tekcanyilmaz42-gif/bldc_driver/yardımcı_dokuman/montaj_yan.png

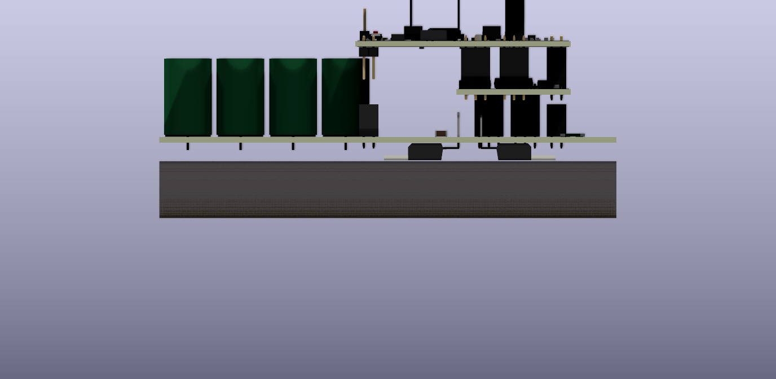
yardımcı_dokuman/montaj_yan.png
