tekcanyilmaz42-gif/bldc_driver/yardımcı_dokuman/montaj_3d.png

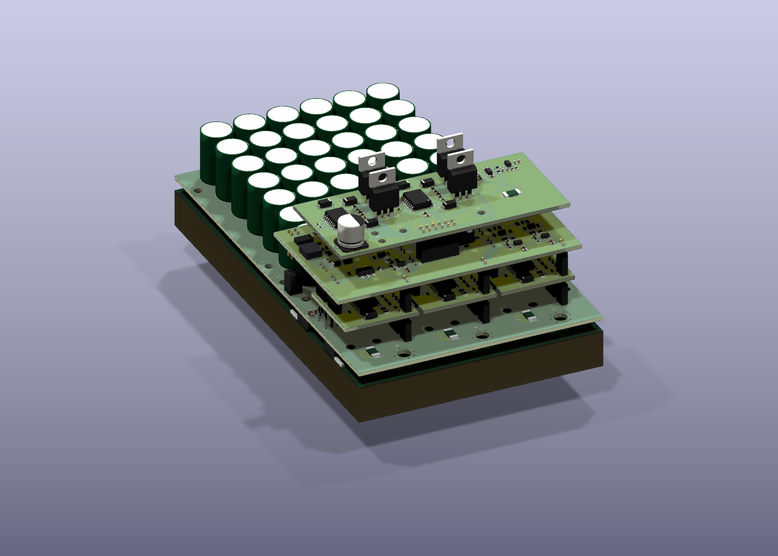
yardımcı_dokuman/montaj_3d.png
