tekcanyilmaz42-gif/bldc_driver/yardımcı_dokuman/guc_karti_alt_TO220.png

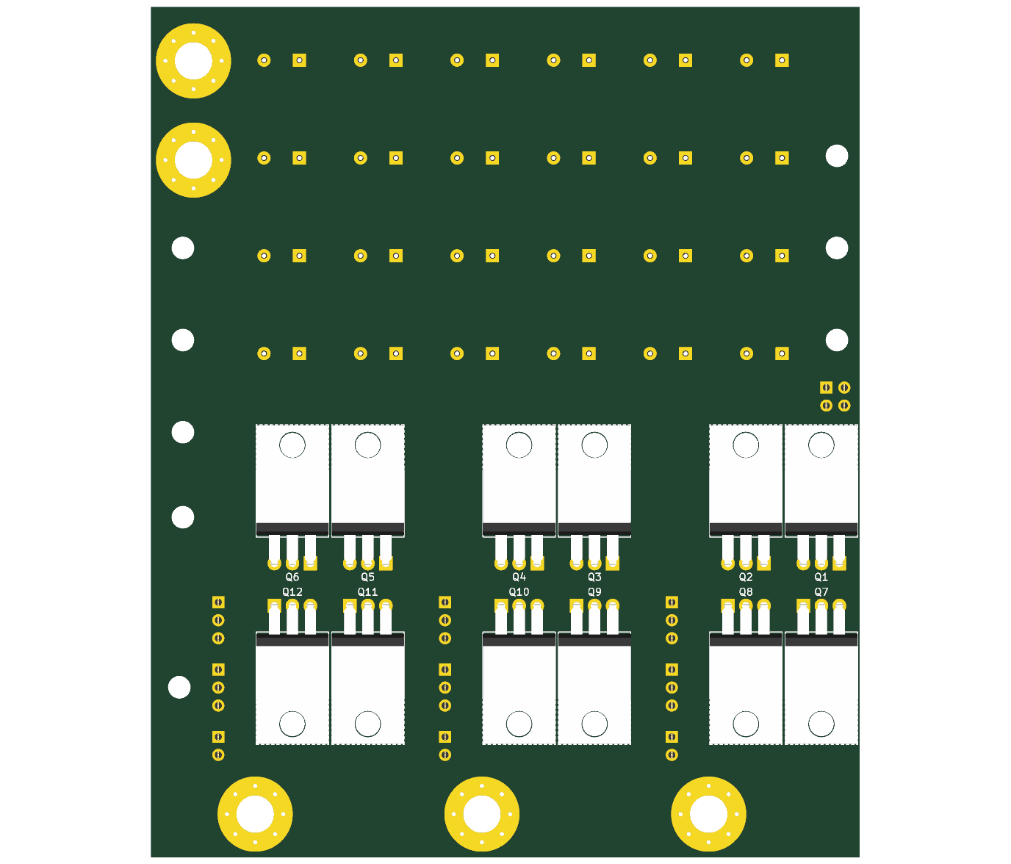
yardımcı_dokuman/guc_karti_alt_TO220.png
