tekcanyilmaz42-gif/bldc_driver/yardımcı_dokuman/master_bottom.png

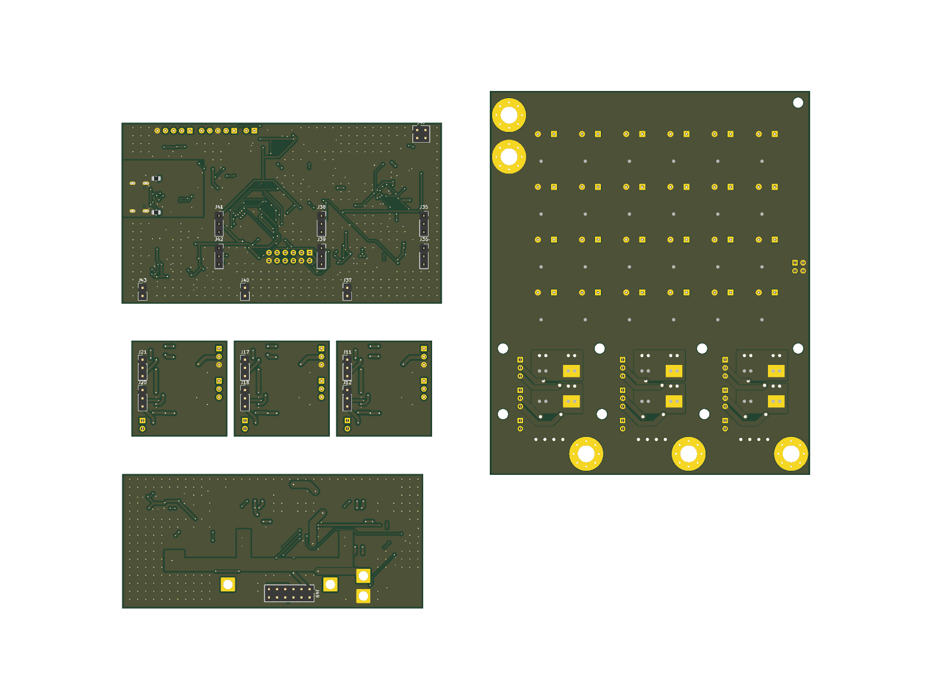
yardımcı_dokuman/master_bottom.png
