tekcanyilmaz42-gif/bldc_driver/yardımcı_dokuman/master_top.png

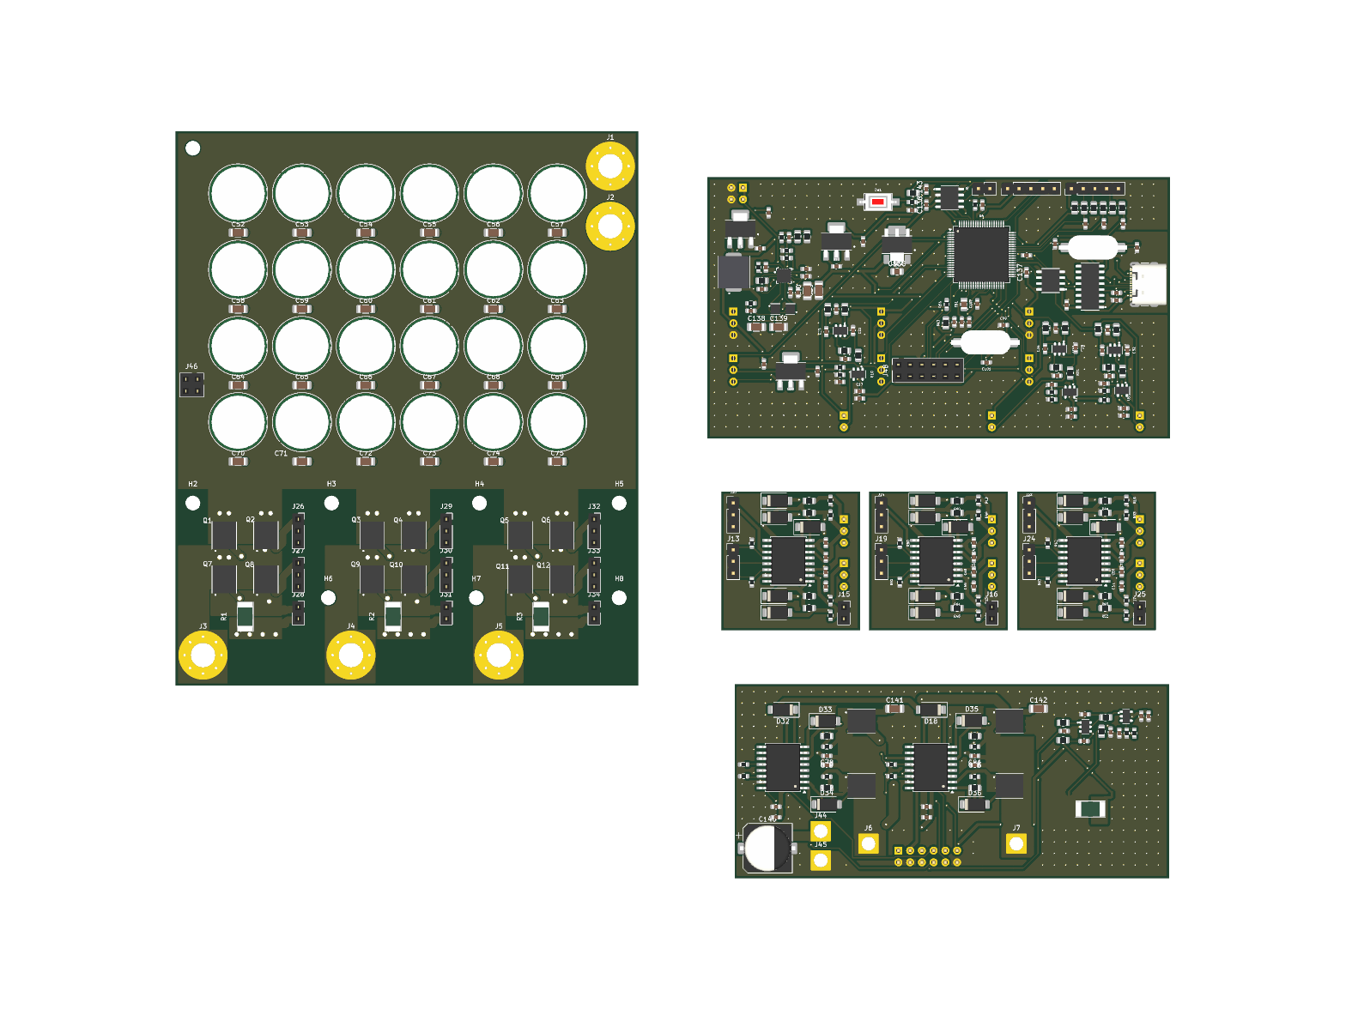
yardımcı_dokuman/master_top.png
