tekcanyilmaz42-gif/bldc_driver/yardımcı_dokuman/pmsm_bom.pdf

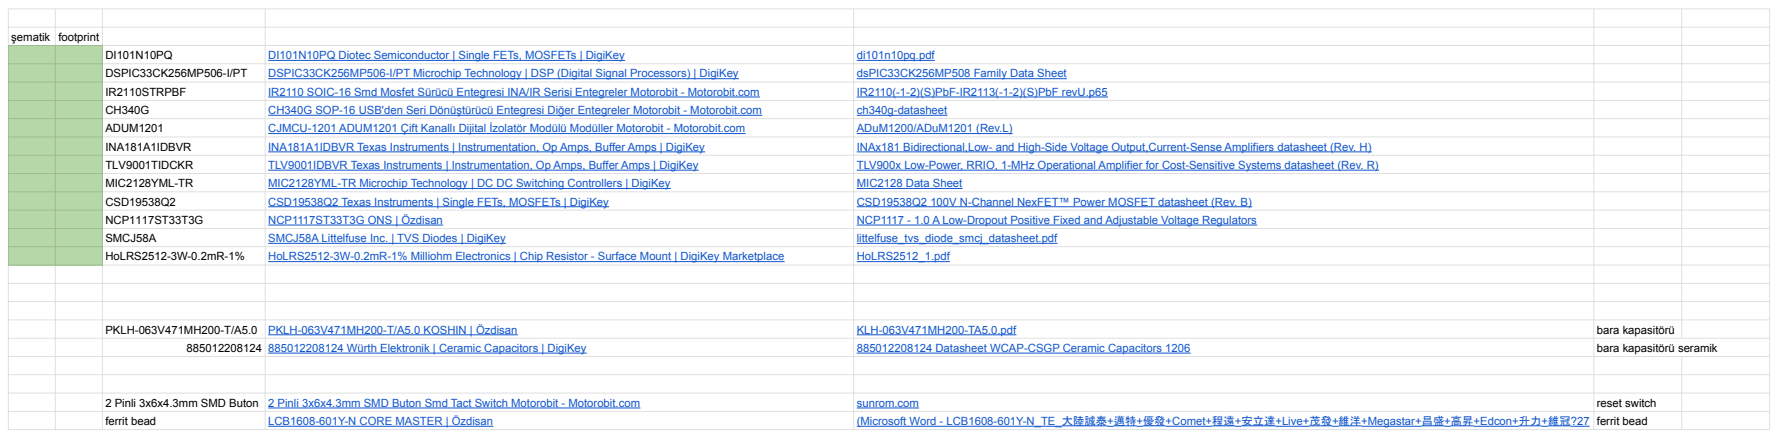
[picture p6: page 1]
şematik footprint; DI101N10PQ Diotec Semiconductor | Single FETs, MOSFETs | DigiKey; di101n10pq.pdf; DSPIC33CK256MP506-I/PT; DSPIC33CK256MP506-I/PT Microchip Technology | DSP (Digital Signal Processors) | DigiKey; dsPIC33CK256MP508 Family Data Sheet; IR2110STRPBF; IR2110 SOIC-16 Smd Mosfet Sürücü Entegresi INA/IR Serisi Entegreler Motorobit - Motorobit.com; IR2110(-1-2)(S)PbF-IR2113(-1-2)(S)PbF revU.p65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

şematik | footprint
| | SS18-T/R | VCC-VB diyot | SS18-T/R (https://www.ozdisan.com/p/schottky-diyotlar-385/galaxy-ss18-t-r-349246) | SK12-SK110.xls (https://cdn.ozdisan.com/public/product/assets/SS12-SS110-GALAXY.pdf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) | önceki ES1A-ES1J_HT.pdf (https://cdn.ozdisan.com/public/product/assets/ES1A-ES1J_HT.pdf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)
| | SS18-T/R | gate diyot | SS18-T/R (https://www.ozdisan.com/p/schottky-diyotlar-385/galaxy-ss18-t-r-349246) | SK12-SK110.xls (https://cdn.ozdisan.com/public/product/assets/SS12-SS110-GALAXY.pdf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) | Önceki https://diotec.com/request/datasheet/m1.pdf
| | CL10B104KB8NNNC | 100nF | CL10B104KB8NNNC SAMSUNG | Özdisan (https://www.ozdisan.com/p/smt-smd-ve-mlcc-kapasitorler-184/samsung-cl10b104kb8nnnc-9739?catSequenceId=184) | SAMSUNG MLCC_JAN-2024.pdf (https://cdn.ozdisan.com/public/product/assets/SAMSUNG%20MLCC_JAN-2024.pdf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)
| | CL21A106KAYNNNE | 10uF | CL21A106KAYNNNE SAMSUNG | Özdisan (https://www.ozdisan.com/p/smt-smd-ve-mlcc-kapasitorler-184/samsung-cl21a106kaynnne-453566?catSequenceId=184) | SAMSUNG MLCC_JAN-2024.pdf (https://cdn.ozdisan.com/public/product/assets/SAMSUNG%20MLCC_JAN-2024.pdf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)
| | 0805S8J0100T5E | 10 ohm | 0805S8J0100T5E ROYALOHM | Özdisan (https://www.ozdisan.com/p/smt-smd-ve-cip-direncler-194/royalohm-0805s8j0100t5e-29704?catSequenceId=194) | general_royalohm.pdf (https://cdn.ozdisan.com/public/product/assets/general_royalohm.pdf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)
| | RC0603JR-0710KL | 10k ohm | RC0603JR-0710KL YAGEO | Özdisan (https://www.ozdisan.com/p/smt-smd-ve-cip-direncler-194/yageo-rc0603jr-0710kl-383150?catSequenceId=194) | PYu-RC_Group_51_RoHS_L_10.pdf (https://cdn.ozdisan.com/public/product/assets/PYu-RC_Group_51_RoHS_L_10.pdf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)
| | 0805S8J0101T5E | 100 ohm | 0805S8J0101T5E ROYALOHM | Özdisan (https://www.ozdisan.com/p/smt-smd-ve-cip-direncler-194/royalohm-0805s8j0101t5e-36382?catSequenceId=194)

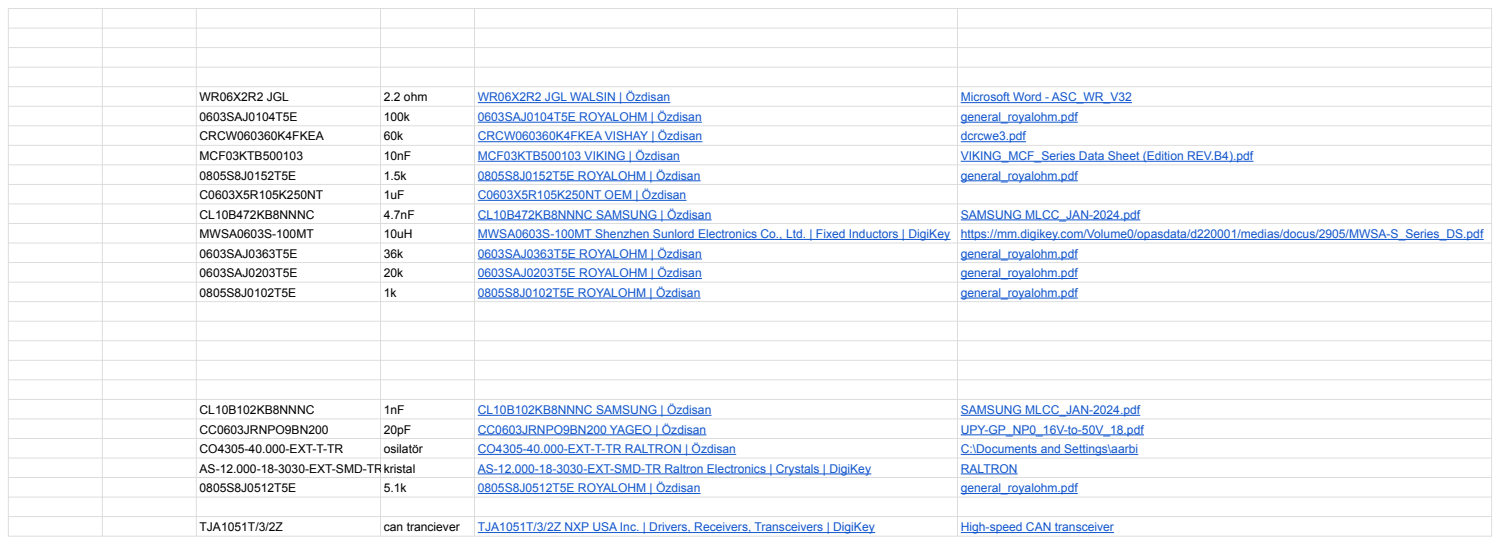
[picture p7: page 3]
WR06X2R2 JGL; 2.2 ohm; WR06X2R2 JGL WALSIN | Özdisan; Microsoft Word - ASC_WR_V32; 0603SAJ0104T5E; 0603SAJ0104T5E ROYALOHM | Özdisan; general_royalohm.pdf; CRCW060360K4FKEA; CRCW060360K4FKEA VISHAY | Özdisan; dcrcwe3.pdf; MCF03KTB500103; MCF03KTB500103 VIKING | Özdisan; VIKING_MCF_Series Data Sheet (Edition REV.B4).pdf; 0805S8J0152T5E ROYALOHM | Özdisan; C0603X5R105K250NT OEM | Özdisan; CL10B472KB8NNNC; CL10B472KB8NNNC SAMSUNG | Özdisan; SAMSUNG MLCC_JAN-2024.pdf; MWSA0603S-100MT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
