tekcanyilmaz42-gif/bldc_driver/bldc_driver_ai_BOM.xlsx

Sheet: BOM
bldc_driver_ai – Malzeme Listesi (BOM)
Rev 2.5 (2 katman). Kaynak: bldc_driver_ai.kicad_pcb, referans format: yardımcı_dokuman/pmsm_bom.pdf
Üretilecek set sayısı: |  |  | 1 |  | Sarı hücreler (set sayısı, birim fiyat) kullanıcı girişidir. Yeşil = referans BOM'daki parça; turuncu = referanstan farklı / yeni parça (bkz. Not).
şematik | footprint | No | Kart / Modül | Referanslar | Adet / set | Değer | Kılıf (footprint) | Üretici parça no (MPN) | Üretici | Açıklama | Tedarikçi | Ürün arama | Datasheet | Toplam adet | Birim fiyat (TL) | Toplam fiyat (TL) | Not
 |  |  | 1 - Güç kartı
 |  | 1 | Güç kartı | Q1, Q2, Q3, Q4, Q5, Q6, Q7, Q8, Q9, Q10, Q11, Q12 | 12 | IRFB4110PBF | TO-220-3_Horizontal_TabUp_NoHole | IRFB4110PBF | Infineon | N-kanal MOSFET 100 V, 4.5 mΩ, TO-220AB | DigiKey / Özdisan | DigiKey'de ara (https://www.digikey.com/en/products/result?keywords=IRFB4110PBF) | irfb4110pbf.pdf |  |  |  | DI101N10PQ yerine (Rev 3.0). Güç kartında kartın altında yatık, tab soğutucuya (yalıtkan ped + burç + M3 vida, Mekanik sayfası); EESM'de dik, soğutucusuz. Sahte ürün riski: yetkili distribütörden alın
 |  | 2 | Güç kartı | D38, D39 | 2 | 5.0SMDJ58CA | D_SMC | 5.0SMDJ58CA | Littelfuse | TVS diyot 58 V çift yönlü 5000 W, SMC | DigiKey | DigiKey'de ara (https://www.digikey.com/en/products/result?keywords=5.0SMDJ58CA) | 5.0SMDJ series datasheet |  |  |  | Referanstaki SMCJ58A yerine daha yüksek enerjili TVS (bara koruması, Faz 3)
 |  | 3 | Güç kartı | C52, C53, C54, C55, C56, C57, C58, C59, C60, C61, C62, C63, C64, C65, C66, C67, C68, C69, C70, C71, C72, C73, C74, C75 | 24 | 4.7uF/100V | C_1210 | HMK325C7475KN-TE | Taiyo Yuden | MLCC 4.7 µF 100 V X7S 1210 (bara seramik) | DigiKey | DigiKey'de ara (https://www.digikey.com/en/products/result?keywords=HMK325C7475KN-TE) | GRM32E datasheet |  |  |  | Faz başına yüksek frekans bara dekuplajı (Faz 3)
 |  | 4 | Güç kartı | C167, C168, C169, C170, C171, C172 | 6 | 4.7nF/100V C0G | C_1206 | GRM3195C2A472JA01D | Murata | MLCC 4.7 nF 100 V C0G 1206 (snubber) | DigiKey | DigiKey'de ara (https://www.digikey.com/en/products/result?keywords=GRM3195C2A472JA01D) | GRM319 datasheet |  |  |  | RC snubber (Faz 3)
 |  | 5 | Güç kartı | C200, C201, C202, C203, C204, C205, C206, C207, C208, C209, C210, C211, C212, C213, C214, C215, C216, C217, C218, C219, C220, C221, C222, C223 | 24 | 1000uF/100V | CP_Radial_D18.0mm_L40mm_P7.50mm_KOSHIN_KLH | PKLH-100V102MK400 | KOSHIN | Alüminyum elektrolitik 1000 µF ±%20 100 V, KLH serisi, Ø18 x 40 mm radyal, P 7.5 mm, Z ≤ 0.076 Ω (100 kHz), IRMS 2.5 A (100 kHz, 105 °C), 5000 h @ 105 °C | Özdisan | DigiKey'de ara (https://www.digikey.com/en/products/result?keywords=PKLH-100V102MK400) | KLH-100V102MK400.pdf (KOSHIN DJJ-2875) |  |  |  | Kullanıcı seçimi: TDK B32776G4506 film yerine. Güç kartının sağ bölümünde, petek (şaşırtmalı) dizilim; 24 adet = 24 mF, 60 A rms (105 °C değeri; gereken ≈ 50–60 A rms)
 |  | 6 | Güç kartı | R1, R2, R3 | 3 | 0.2mR 4-terminal | R_Shunt_Isabellenhuette_BVR4026 | BVR-Z-R0002-1.0 | Isabellenhütte | 4 uçlu (Kelvin) şönt 0.2 mΩ %1, 4026 | DigiKey / Mouser | DigiKey'de ara (https://www.digikey.com/en/products/result?keywords=BVR-Z-R0002-1.0) | BVR datasheet |  |  |  | Faz 3: HoLRS2512 yerine 4 uçlu şönt; 100 A rms'de I²R ≈ 2 W. MPN son ekini distribütörde doğrulayın
 |  | 7 | Güç kartı | R118, R119, R120, R121, R122, R123, R124, R125, R126, R127, R128, R129 | 12 | 10k | R_0805 | RC0603JR-0710KL | YAGEO | Direnç 10 kΩ %5 0603 | Özdisan | DigiKey'de ara (https://www.digikey.com/en/products/result?keywords=RC0603JR-0710KL) | PYu-RC_Group_51_RoHS_L_10.pdf
 |  | 8 | Güç kartı | R130, R132, R134 | 3 | 2.2 | R_2010 | CRCW20102R20FKEF | Vishay | Direnç 2.2 Ω %1 0.75 W 2010 (yüksek taraf RC snubber) | DigiKey | DigiKey'de ara (https://www.digikey.com/en/products/result?keywords=CRCW20102R20FKEF) | dcrcwe3.pdf |  |  |  | HS snubber, alt yüzde band içinde; kayıp ≈ 0.27 W
 |  | 9 | Güç kartı | R131, R133, R135 | 3 | 2.2 | R_1210 | CRCW12102R20FKEA | Vishay | Direnç 2.2 Ω %1 0.5 W 1210 (alçak taraf RC snubber) | DigiKey | DigiKey'de ara (https://www.digikey.com/en/products/result?keywords=CRCW12102R20FKEA) | dcrcwe3.pdf |  |  |  | LS snubber; band üstüne sığması için 2010 yerine 1210 (kayıp ≈ 0.27 W)
 |  | 10 | Güç kartı | R136, R137, R138 | 3 | 10k 1W | R_2512 | CRCW251210K0FKEG | Vishay | Direnç 10 kΩ %1 1 W 2512 (bara deşarj) | DigiKey | DigiKey'de ara (https://www.digikey.com/en/products/result?keywords=CRCW251210K0FKEG) | dcrcwe3.pdf |  |  |  | Bara kapasitörü deşarj (bleeder), Faz 3
 |  | 11 | Güç kartı | J28, J31, J34 | 3 | - | PinSocket_1x02 | - | genel | 2.54 mm dişi soket 1x2, 8.5 mm gövde | genel (Motorobit / Özdisan) |  | - |  |  |  | Kartlar arası konnektör
 |  | 12 | Güç kartı | J26, J27, J29, J30, J32, J33 | 6 | - | PinSocket_1x03 | - | genel | 2.54 mm dişi soket 1x3, 8.5 mm gövde | genel (Motorobit / Özdisan) |  | - |  |  |  | Kartlar arası konnektör
 |  | 13 | Güç kartı | J46 | 1 | - | PinSocket_2x02 | - | genel | 2.54 mm dişi soket 2x2, 8.5 mm gövde – riser | genel (Motorobit / Özdisan) |  | - |  |  |  | Kartlar arası konnektör
 |  |  | 2 - Gate driver (U/V/W)
 |  | 14 | Gate driver (U/V/W) | U1, U2, U3 | 3 | IR2110S | SOIC-16W_7.5x10.3mm_P1.27mm | IR2110STRPBF | Infineon | Yüksek/alçak taraf gate sürücü, SOIC-16W | Motorobit | DigiKey'de ara (https://www.digikey.com/en/products/result?keywords=IR2110STRPBF) | IR2110(-1-2)(S)PbF
 |  | 15 | Gate driver (U/V/W) | D10, D11, D12, D23, D24, D25, D26, D27, D28, D29, D30, D31 | 12 | SS18 | D_SMA | SS18 | onsemi | Schottky diyot 1 A 80 V, SMA | Özdisan | DigiKey'de ara (https://www.digikey.com/en/products/result?keywords=SS18) | SK12-SK110 |  |  |  | VCC-VB (bootstrap) ve gate deşarj diyotu olarak kullanılıyor
 |  | 16 | Gate driver (U/V/W) | D1, D2, D13 | 3 | US1D | D_SMA | US1D-E3/61T | Vishay | Ultra hızlı diyot 1 A 200 V, SMA | DigiKey | DigiKey'de ara (https://www.digikey.com/en/products/result?keywords=US1D-E3%2F61T) | US1A-US1M datasheet |  |  |  | Bootstrap diyodu (SS18 yerine, Faz 2)
 |  | 17 | Gate driver (U/V/W) | C1, C5, C6, C148, C149, C152, C153, C156, C157 | 9 | 100nF | C_0603 | CL10B104KB8NNNC | Samsung | MLCC 100 nF 50 V X7R 0603 | Özdisan | DigiKey'de ara (https://www.digikey.com/en/products/result?keywords=CL10B104KB8NNNC) | SAMSUNG MLCC_JAN-2024.pdf
 |  | 18 | Gate driver (U/V/W) | C3, C4, C7 | 3 | 2.2uF/25V | C_1206 | CL31B225KAHNNNE | Samsung | MLCC 2.2 µF 25 V X7R 1206 | Özdisan | DigiKey'de ara (https://www.digikey.com/en/products/result?keywords=CL31B225KAHNNNE) | SAMSUNG MLCC_JAN-2024.pdf |  |  |  | Revizyonla eklendi
 |  | 19 | Gate driver (U/V/W) | C41, C47, C48, C49, C50, C51, C150, C154, C158 | 9 | 1uF | C_0603 | C0603X5R105K250NT | OEM | MLCC 1 µF 25 V X5R 0603 | Özdisan | DigiKey'de ara (https://www.digikey.com/en/products/result?keywords=C0603X5R105K250NT) | -
 |  | 20 | Gate driver (U/V/W) | C147, C151, C155 | 3 | 22uF/25V | C_1206 | CL31A226KAHNNNE | Samsung | MLCC 22 µF 25 V X5R 1206 | Özdisan | DigiKey'de ara (https://www.digikey.com/en/products/result?keywords=CL31A226KAHNNNE) | SAMSUNG MLCC_JAN-2024.pdf |  |  |  | Gate sürücü VCC dekuplajı
 |  | 21 | Gate driver (U/V/W) | R6, R7, R10, R11, R14, R15, R43, R45, R47, R48, R51, R52 | 12 | 10 | R_0805 | 0805S8J0100T5E | ROYALOHM | Direnç 10 Ω %5 0805 (gate direnci) | Özdisan | DigiKey'de ara (https://www.digikey.com/en/products/result?keywords=0805S8J0100T5E) | general_royalohm.pdf
 |  | 22 | Gate driver (U/V/W) | R8, R9, R12, R13, R16, R17, R44, R46, R49, R50, R53, R54, R58, R59, R60, R61, R62, R63 | 18 | 10k | R_0603 | RC0603JR-0710KL | YAGEO | Direnç 10 kΩ %5 0603 | Özdisan | DigiKey'de ara (https://www.digikey.com/en/products/result?keywords=RC0603JR-0710KL) | PYu-RC_Group_51_RoHS_L_10.pdf
 |  | 23 | Gate driver (U/V/W) | R102, R103, R104, R105, R106, R107, R108, R109, R110, R111, R112, R113 | 12 | 2.2 | R_0603 | WR06X2R2 JGL | WALSIN | Direnç 2.2 Ω %5 0603 | Özdisan | DigiKey'de ara (https://www.digikey.com/en/products/result?keywords=WR06X2R2+JGL) | ASC_WR_V32
 |  | 24 | Gate driver (U/V/W) | J10, J11, J12, J13, J14, J17, J18, J19, J20, J21, J22, J24 | 12 | - | PinHeader_1x03 | - | genel | 2.54 mm erkek pin başlık 1x3, düz | genel (Motorobit / Özdisan) |  | - |  |  |  | Kartlar arası konnektör
 |  | 25 | Gate driver (U/V/W) | J15, J16, J25 | 3 | - | PinSocket_1x02 | ESQ-102-xx-T-S sınıfı (uzun kuyruklu) | Samtec / genel | 2.54 mm 1x2 STACKING dişi soket: üstte 8.5 mm soket, altta ≥ 10.5 mm uzun kuyruk (Arduino stacking header tipi) | Samtec / LCSC | DigiKey'de ara (https://www.digikey.com/en/products/result?keywords=ESQ-102-xx-T-S+sınıfı+(uzun+kuyruklu)) | - |  |  |  | Faz 7 (inceleme K21): şönt ölçüm hattı güç kartı J28/J31/J34 soketlerine bu kuyruklarla girer (kart arası 11 mm, giriş ≈ 6 mm). Standart soket TAKILMAZ: INA181 girişleri boşta kalır
 |  |  | 3 - Kontrol kartı
 |  | 26 | Kontrol kartı | Q13, Q14 | 2 | IRLML0100TRPBF | SOT-23 | IRLML0100TRPBF | Infineon | N-kanal MOSFET 100 V 1.6 A, SOT-23 | DigiKey | DigiKey'de ara (https://www.digikey.com/en/products/result?keywords=IRLML0100TRPBF) | IRLML0100 datasheet |  |  |  | Faz 2
 |  | 27 | Kontrol kartı | Q19, Q20 | 2 | AO3400A | SOT-23 | AO3400A | Alpha & Omega | N-kanal MOSFET 30 V 5.7 A, SOT-23 | DigiKey | DigiKey'de ara (https://www.digikey.com/en/products/result?keywords=AO3400A) | AO3400A datasheet |  |  |  | Kontaktör / ön şarj sürücüsü
 |  | 28 | Kontrol kartı | U4 | 1 | ADuM1201 | ADuM1201_LP | ADUM1201ARZ | Analog Devices | Çift kanallı dijital izolatör, SOIC-8 | DigiKey | DigiKey'de ara (https://www.digikey.com/en/products/result?keywords=ADUM1201ARZ) | ADuM1200/ADuM1201 (Rev.L) |  |  |  | Referans BOM'da CJMCU-1201 modülü var; kart üstü SOIC-8 entegre gerekir
 |  | 29 | Kontrol kartı | U5 | 1 | CH340G | CH340G_LP | CH340G | WCH | USB-UART dönüştürücü, SOP-16 | Motorobit | DigiKey'de ara (https://www.digikey.com/en/products/result?keywords=CH340G) | ch340g-datasheet
 |  | 30 | Kontrol kartı | U6 | 1 | dsPIC33CK256MP508 | LQFP-80_12x12mm_P0.5mm | DSPIC33CK256MP508-I/PT | Microchip Technology | dsPIC33CK DSC, 256 KB, TQFP-80 12x12 | DigiKey | DigiKey'de ara (https://www.digikey.com/en/products/result?keywords=DSPIC33CK256MP508-I%2FPT) | dsPIC33CK256MP508 Family Data Sheet |  |  |  | Referans BOM'da MP506 (64 pin) yazıyor; tasarım 80 pinli MP508 kullanıyor
 |  | 31 | Kontrol kartı | U8, U19, U20 | 3 | LDL1117S33R | NCP1117 | LDL1117S33R | STMicroelectronics | LDO 3.3 V 1.2 A, SOT-223, seramik çıkış kondansatörüyle kararlı | DigiKey | DigiKey'de ara (https://www.digikey.com/en/products/result?keywords=LDL1117S33R) | LDL1117 datasheet |  |  |  | Faz 7: NCP1117 yerine (NCP1117 çıkış kondansatöründe ESR ≥ 33 mΩ ister; 22 µF seramikle salınım riski). Bacak düzeni aynı: 1 GND, 2 OUT, 3 IN
 |  | 32 | Kontrol kartı | U9 | 1 | MIC2128 | MIC2128_LP | MIC2128YML-TR | Microchip Technology | Senkron buck denetleyici, VQFN-16 3x3 | DigiKey | DigiKey'de ara (https://www.digikey.com/en/products/result?keywords=MIC2128YML-TR) | MIC2128 Data Sheet
 |  | 33 | Kontrol kartı | U10, U11, U13 | 3 | TLV9001 | TLV9001_LP | TLV9001IDBVR | Texas Instruments | RRIO op-amp 1 MHz, SOT-23-5 | DigiKey | DigiKey'de ara (https://www.digikey.com/en/products/result?keywords=TLV9001IDBVR) | TLV900x datasheet (Rev. R) |  |  |  | Footprint SOT-23-5 (DBV); referanstaki TLV9001TIDCKR SC-70 kılıfı uymaz
 |  | 34 | Kontrol kartı | U7, U12, U14 | 3 | INA181 | INA181_LP | INA181A1IDBVR | Texas Instruments | Akım ölçüm yükselteci, kazanç 20, SOT-23-6 | DigiKey | DigiKey'de ara (https://www.digikey.com/en/products/result?keywords=INA181A1IDBVR) | INAx181 datasheet (Rev. H)
 |  | 35 | Kontrol kartı | U21 | 1 | LDL1117S50R | NCP1117 | LDL1117S50R | STMicroelectronics | LDO 5.0 V 1.2 A, SOT-223 (CAN beslemesi) | DigiKey | DigiKey'de ara (https://www.digikey.com/en/products/result?keywords=LDL1117S50R) | LDL1117 datasheet |  |  |  | Faz 7: NCP1117-5.0 yerine
 |  | 36 | Kontrol kartı | U22 | 1 | TJA1051 | TJA1051_LP | TJA1051T/3/1J | NXP | Yüksek hızlı CAN alıcı-verici, SOIC-8 | DigiKey | DigiKey'de ara (https://www.digikey.com/en/products/result?keywords=TJA1051T%2F3%2F1J) | High-speed CAN transceiver
 |  | 37 | Kontrol kartı | U23 | 1 | SP0503BAHT | SOT-143 | SP0503BAHTG | Littelfuse | 3 kanallı ESD dizisi, SOT-143 | DigiKey | DigiKey'de ara (https://www.digikey.com/en/products/result?keywords=SP0503BAHTG) | SP0503BAHT datasheet |  |  |  | Enkoder girişleri (Faz 5)
 |  | 38 | Kontrol kartı | U24 | 1 | USBLC6-2SC6 | SOT-23-6 | USBLC6-2SC6 | STMicroelectronics | USB ESD koruma dizisi, SOT-23-6 | DigiKey | DigiKey'de ara (https://www.digikey.com/en/products/result?keywords=USBLC6-2SC6) | USBLC6-2 datasheet |  |  |  | Faz 5
 |  | 39 | Kontrol kartı | U25 | 1 | TSR 1-2450 | Converter_DCDC_TRACO_TSR-1_THT | TSR 1-2450 | TRACO Power | DC-DC regülatör modülü 5 V 1 A, SIP-3 | DigiKey | DigiKey'de ara (https://www.digikey.com/en/products/result?keywords=TSR+1-2450) | TSR-1 datasheet |  |  |  | Faz 5
 |  | 40 | Kontrol kartı | D37 | 1 | NUP2105L | SOT-23 | NUP2105LT1G | onsemi | CAN hattı ESD koruma, SOT-23 | DigiKey | DigiKey'de ara (https://www.digikey.com/en/products/result?keywords=NUP2105LT1G) | NUP2105L datasheet |  |  |  | Faz 5
 |  | 41 | Kontrol kartı | D40, D41 | 2 | SS18 | D_SMA | SS18 | onsemi | Schottky diyot 1 A 80 V, SMA | Özdisan | DigiKey'de ara (https://www.digikey.com/en/products/result?keywords=SS18) | SK12-SK110 |  |  |  | VCC-VB (bootstrap) ve gate deşarj diyotu olarak kullanılıyor
 |  | 42 | Kontrol kartı | D42 | 1 | SS34 | D_SMA | B340A-13-F | Diodes Inc. | Schottky diyot 3 A 40 V, SMA (DO-214AC) | DigiKey | DigiKey'de ara (https://www.digikey.com/en/products/result?keywords=B340A-13-F) | B320A-B360A datasheet |  |  |  | Faz 7 (D42): harici 12 V (J50.1) ile kart 12 V rayı arasında diyot-VEYA; MCU bara dolmadan açılabilsin diye
 |  | 43 | Kontrol kartı | D43 | 1 | SMAJ15A | D_SMA | SMAJ15A | Littelfuse | TVS diyot 400 W tek yönlü, VRWM 15 V, VC 24.4 V, SMA | DigiKey / LCSC | DigiKey'de ara (https://www.digikey.com/en/products/result?keywords=SMAJ15A) | SMAJ series datasheet |  |  |  | Faz 7 (inceleme): J50.1 harici 12 V girişi. Kıskaç 24.4 V < IR2110 VCC mutlak sınırı 25 V; U21 (LDL1117S50, 20 V) kısa darbelerde F1 + 12 V ray kapasitörleriyle korunur
 |  | 44 | Kontrol kartı | C8 | 1 | 10nF | C_0603 | CL10B103KB8NNNC | Samsung | MLCC 10 nF 50 V X7R 0603 | Özdisan | DigiKey'de ara (https://www.digikey.com/en/products/result?keywords=CL10B103KB8NNNC) | SAMSUNG MLCC_JAN-2024.pdf |  |  |  | Faz 7: referanstaki MCF03KTB500103 distribütörde bulunamadı
 |  | 45 | Kontrol kartı | C9, C11 | 2 | 100nF/100V | C_0805 | CL21B104KCFNNNE | Samsung | MLCC 100 nF 100 V X7R 0805 | Özdisan | DigiKey'de ara (https://www.digikey.com/en/products/result?keywords=CL21B104KCFNNNE) | SAMSUNG MLCC_JAN-2024.pdf |  |  |  | VBAT tarafı dekuplaj (Faz 4)
 |  | 46 | Kontrol kartı | C12 | 1 | 4.7nF | C_0603 | CL10B472KB8NNNC | Samsung | MLCC 4.7 nF 50 V X7R 0603 | Özdisan | DigiKey'de ara (https://www.digikey.com/en/products/result?keywords=CL10B472KB8NNNC) | SAMSUNG MLCC_JAN-2024.pdf
 |  | 47 | Kontrol kartı | C14, C15 | 2 | 10uF | C_0603 | CL10A106MA8NRNC | Samsung | MLCC 10 µF 25 V X5R 0603 | Özdisan | DigiKey'de ara (https://www.digikey.com/en/products/result?keywords=CL10A106MA8NRNC) | SAMSUNG MLCC_JAN-2024.pdf |  |  |  | Referanstaki CL21A106KAYNNNE 0805 kılıflı; bu kapasitörlerin footprint'i 0603 ve bir kısmı 12 V'ta, bu yüzden 25 V 0603 seçildi
 |  | 48 | Kontrol kartı | C23, C26, C33 | 3 | 220nF | C_0603 | CL10B224KB8NNNC | Samsung | MLCC 220 nF 50 V X7R 0603 | Özdisan | DigiKey'de ara (https://www.digikey.com/en/products/result?keywords=CL10B224KB8NNNC) | SAMSUNG MLCC_JAN-2024.pdf |  |  |  | Revizyonla eklendi
 |  | 49 | Kontrol kartı | C21, C25, C32 | 3 | 1nF C0G | C_0603 | GRM1885C1H102JA01D | Murata | MLCC 1 nF 50 V C0G 0603 (ölçüm filtresi) | DigiKey | DigiKey'de ara (https://www.digikey.com/en/products/result?keywords=GRM1885C1H102JA01D) | GRM188 datasheet |  |  |  | Faz 4
 |  | 50 | Kontrol kartı | C18, C39, C40, C91, C93 | 5 | 10uF/25V | C_1206 | CL31A106KAHNNNE | Samsung | MLCC 10 µF 25 V X5R 1206 (12 V çıkışı, R6) | Özdisan | DigiKey'de ara (https://www.digikey.com/en/products/result?keywords=CL31A106KAHNNNE) | SAMSUNG MLCC_JAN-2024.pdf |  |  |  | Revizyon R6 ile eklendi
 |  | 51 | Kontrol kartı | C19, C92, C94, C146 | 4 | 22uF/10V | C_0805 | CL21A226MPQNNNE | Samsung | MLCC 22 µF 10 V X5R 0805 | Özdisan | DigiKey'de ara (https://www.digikey.com/en/products/result?keywords=CL21A226MPQNNNE) | SAMSUNG MLCC_JAN-2024.pdf |  |  |  | LDO çıkışı (Faz 5)
 |  | 52 | Kontrol kartı | C43, C44, C99, C101 | 4 | 27pF | C_0603 | CC0603JRNPO9BN270 | YAGEO | MLCC 27 pF 50 V NP0 0603 (kristal yükü) | Özdisan | DigiKey'de ara (https://www.digikey.com/en/products/result?keywords=CC0603JRNPO9BN270) | UPY-GP_NP0_16V-to-50V_18.pdf |  |  |  | 20 pF yerine, kristal CL'ye göre
 |  | 53 | Kontrol kartı | C10, C16, C17, C22, C28, C29, C30, C35, C36, C37, C42, C45, C46, C100, C102, C103, C104, C105, C106, C136, C137, C143, C144, C199, C224 | 25 | 100nF | C_0603 | CL10B104KB8NNNC | Samsung | MLCC 100 nF 50 V X7R 0603 | Özdisan | DigiKey'de ara (https://www.digikey.com/en/products/result?keywords=CL10B104KB8NNNC) | SAMSUNG MLCC_JAN-2024.pdf
 |  | 54 | Kontrol kartı | C13, C20, C31, C38, C107 | 5 | 1uF | C_0603 | C0603X5R105K250NT | OEM | MLCC 1 µF 25 V X5R 0603 | Özdisan | DigiKey'de ara (https://www.digikey.com/en/products/result?keywords=C0603X5R105K250NT) | -
 |  | 55 | Kontrol kartı | C135 | 1 | 10uF/16V | C_0805 | CL21A106KAYNNNE | Samsung | MLCC 10 µF 25 V X5R 0805 | Özdisan | DigiKey'de ara (https://www.digikey.com/en/products/result?keywords=CL21A106KAYNNNE) | SAMSUNG MLCC_JAN-2024.pdf
 |  | 56 | Kontrol kartı | C138, C139 | 2 | 2.2uF/100V | C_1206 | 885012208124 | Würth Elektronik | MLCC 2.2 µF 100 V X7R 1206, bara kapasitörü (seramik) | DigiKey | DigiKey'de ara (https://www.digikey.com/en/products/result?keywords=885012208124) | WCAP-CSGP 1206 datasheet
 |  | 57 | Kontrol kartı | C145 | 1 | 4.7uF/10V | C_0805 | CL21A475KPFNNNE | Samsung | MLCC 4.7 µF 10 V X5R 0805 | Özdisan | DigiKey'de ara (https://www.digikey.com/en/products/result?keywords=CL21A475KPFNNNE) | SAMSUNG MLCC_JAN-2024.pdf |  |  |  | USB VBUS
 |  | 58 | Kontrol kartı | C24, C27, C34, C132, C133, C134, C173, C174, C175, C176, C177, C178 | 12 | 1nF | C_0603 | CL10B102KB8NNNC | Samsung | MLCC 1 nF 50 V X7R 0603 | Özdisan | DigiKey'de ara (https://www.digikey.com/en/products/result?keywords=CL10B102KB8NNNC) | SAMSUNG MLCC_JAN-2024.pdf
 |  | 59 | Kontrol kartı | R4 | 1 | 5.6k | R_0805 | RC0805FR-075K6L | YAGEO | Direnç 5.6 kΩ %1 0805 | Özdisan | DigiKey'de ara (https://www.digikey.com/en/products/result?keywords=RC0805FR-075K6L) | PYu-RC_Group_51_RoHS_L_10.pdf |  |  |  | Revizyonla eklendi
 |  | 60 | Kontrol kartı | R18 | 1 | 20k | R_0603 | 0603SAJ0203T5E | ROYALOHM | Direnç 20 kΩ %5 0603 | Özdisan | DigiKey'de ara (https://www.digikey.com/en/products/result?keywords=0603SAJ0203T5E) | general_royalohm.pdf
 |  | 61 | Kontrol kartı | R19 | 1 | 1.05k 1% | R_0805 | RC0805FR-071K05L | YAGEO | Direnç 1.05 kΩ %1 0805 | Özdisan | DigiKey'de ara (https://www.digikey.com/en/products/result?keywords=RC0805FR-071K05L) | PYu-RC_Group_51_RoHS_L_10.pdf |  |  |  | Revizyonla eklendi
 |  | 62 | Kontrol kartı | R20 | 1 | 2.2 | R_0603 | WR06X2R2 JGL | WALSIN | Direnç 2.2 Ω %5 0603 | Özdisan | DigiKey'de ara (https://www.digikey.com/en/products/result?keywords=WR06X2R2+JGL) | ASC_WR_V32
 |  | 63 | Kontrol kartı | R21 | 1 | 100k | R_1206 | 0603SAJ0104T5E | ROYALOHM | Direnç 100 kΩ %5 0603 | Özdisan | DigiKey'de ara (https://www.digikey.com/en/products/result?keywords=0603SAJ0104T5E) | general_royalohm.pdf
 |  | 64 | Kontrol kartı | R22 | 1 | 60k | R_0603 | CRCW060360K4FKEA | Vishay | Direnç 60.4 kΩ %1 0603 | Özdisan | DigiKey'de ara (https://www.digikey.com/en/products/result?keywords=CRCW060360K4FKEA) | dcrcwe3.pdf
 |  | 65 | Kontrol kartı | R23, R24, R33, R34, R39, R40, R68, R140, R142 | 9 | 10k | R_0603 | RC0603JR-0710KL | YAGEO | Direnç 10 kΩ %5 0603 | Özdisan | DigiKey'de ara (https://www.digikey.com/en/products/result?keywords=RC0603JR-0710KL) | PYu-RC_Group_51_RoHS_L_10.pdf
 |  | 66 | Kontrol kartı | R25, R26, R27, R29, R30, R31, R35, R36, R37 | 9 | 10 | R_0805 | 0805S8J0100T5E | ROYALOHM | Direnç 10 Ω %5 0805 (gate direnci) | Özdisan | DigiKey'de ara (https://www.digikey.com/en/products/result?keywords=0805S8J0100T5E) | general_royalohm.pdf
 |  | 67 | Kontrol kartı | R41, R42 | 2 | 5.1k | R_0805 | 0805S8J0512T5E | ROYALOHM | Direnç 5.1 kΩ %5 0805 (USB-C CC) | Özdisan | DigiKey'de ara (https://www.digikey.com/en/products/result?keywords=0805S8J0512T5E) | general_royalohm.pdf
 |  | 68 | Kontrol kartı | R57 | 1 | 2.2k | R_0603 | RC0603FR-072K2L | YAGEO | Direnç 2.2 kΩ %1 0603 | Özdisan | DigiKey'de ara (https://www.digikey.com/en/products/result?keywords=RC0603FR-072K2L) | PYu-RC_Group_51_RoHS_L_10.pdf |  |  |  | Revizyonla eklendi
 |  | 69 | Kontrol kartı | R5, R66, R100 | 3 | 100k | R_0603 | 0603SAJ0104T5E | ROYALOHM | Direnç 100 kΩ %5 0603 | Özdisan | DigiKey'de ara (https://www.digikey.com/en/products/result?keywords=0603SAJ0104T5E) | general_royalohm.pdf
 |  | 70 | Kontrol kartı | R67 | 1 | 4.7k | R_0805 | 0805S8J0472T5E | ROYALOHM | Direnç 4.7 kΩ %5 0805 (V_BUS bölücü, R7) | Özdisan | DigiKey'de ara (https://www.digikey.com/en/products/result?keywords=0805S8J0472T5E) | general_royalohm.pdf |  |  |  | Revizyon R7 ile eklendi (aynı seri)
 |  | 71 | Kontrol kartı | R28, R32, R38, R69 | 4 | 100 | R_0805 | 0805S8J0101T5E | ROYALOHM | Direnç 100 Ω %5 0805 | Özdisan | DigiKey'de ara (https://www.digikey.com/en/products/result?keywords=0805S8J0101T5E) | general_royalohm.pdf
 |  | 72 | Kontrol kartı | R71, R73, R75 | 3 | 1k | R_0805 | 0805S8J0102T5E | ROYALOHM | Direnç 1 kΩ %5 0805 | Özdisan | DigiKey'de ara (https://www.digikey.com/en/products/result?keywords=0805S8J0102T5E) | general_royalohm.pdf
 |  | 73 | Kontrol kartı | R70, R72, R74 | 3 | 1.5k | R_0805 | 0805S8J0152T5E | ROYALOHM | Direnç 1.5 kΩ %5 0805 | Özdisan | DigiKey'de ara (https://www.digikey.com/en/products/result?keywords=0805S8J0152T5E) | general_royalohm.pdf
 |  | 74 | Kontrol kartı | R97 | 1 | 0R | R_0805 | RC0805JR-070RL | YAGEO | Direnç 0 Ω 0805 (köprü) | Özdisan | DigiKey'de ara (https://www.digikey.com/en/products/result?keywords=RC0805JR-070RL) | PYu-RC_Group_51_RoHS_L_10.pdf |  |  |  | Revizyonla eklendi
 |  | 75 | Kontrol kartı | R98 | 1 | 470k | R_1206 | RC1206FR-07470KL | YAGEO | Direnç 470 kΩ %1 1206 (yüksek gerilim bölücü) | Özdisan | DigiKey'de ara (https://www.digikey.com/en/products/result?keywords=RC1206FR-07470KL) | PYu-RC_Group_51_RoHS_L_10.pdf |  |  |  | Revizyonla eklendi
 |  | 76 | Kontrol kartı | R99 | 1 | 27k | R_0603 | RC0603FR-0727KL | YAGEO | Direnç 27 kΩ %1 0603 (buck EN bölücüsü) | Özdisan | DigiKey'de ara (https://www.digikey.com/en/products/result?keywords=RC0603FR-0727KL) | PYu-RC_Group_51_RoHS_L_10.pdf |  |  |  | Faz 7: 20k yerine; 36 V'ta EN = 1.96 V (MIC2128 EN yüksek eşiği en az 1.6 V)
 |  | 77 | Kontrol kartı | R101 | 1 | 120 | R_0805 | RC0805FR-07120RL | YAGEO | Direnç 120 Ω %1 0805 (CAN sonlandırma) | Özdisan | DigiKey'de ara (https://www.digikey.com/en/products/result?keywords=RC0805FR-07120RL) | PYu-RC_Group_51_RoHS_L_10.pdf |  |  |  | JP1 ile seçilir
 |  | 78 | Kontrol kartı | R139, R141 | 2 | 100 | R_0603 | 0805S8J0101T5E | ROYALOHM | Direnç 100 Ω %5 0805 | Özdisan | DigiKey'de ara (https://www.digikey.com/en/products/result?keywords=0805S8J0101T5E) | general_royalohm.pdf
 |  | 79 | Kontrol kartı | R143 | 1 | 10k 0.1% | R_0603 | RG1608P-103-B-T5 | Susumu | Direnç 10 kΩ %0.1 25 ppm 0603 (ölçüm bölücü) | DigiKey | DigiKey'de ara (https://www.digikey.com/en/products/result?keywords=RG1608P-103-B-T5) | RG series datasheet |  |  |  | Hassas bölücü (Faz 4)
 |  | 80 | Kontrol kartı | R144 | 1 | 1k | R_0603 | 0805S8J0102T5E | ROYALOHM | Direnç 1 kΩ %5 0805 | Özdisan | DigiKey'de ara (https://www.digikey.com/en/products/result?keywords=0805S8J0102T5E) | general_royalohm.pdf
 |  | 81 | Kontrol kartı | R145 | 1 | 2.2k 0.1% | R_0603 | RG1608P-222-B-T5 | Susumu | Direnç 2.2 kΩ %0.1 25 ppm 0603 (motor sıcaklık sensörü pull-up) | DigiKey | DigiKey'de ara (https://www.digikey.com/en/products/result?keywords=RG1608P-222-B-T5) | RG series datasheet |  |  |  | İnceleme 3: hem 10k NTC hem KTY84-130 ile kullanılabilir; sensör tipi motor datasheet'inden teyit edilecek
 |  | 82 | Kontrol kartı | R146 | 1 | 22k | R_0603 | RC0603FR-0722KL | YAGEO | Direnç 22 kΩ %1 0603 | DigiKey | DigiKey'de ara (https://www.digikey.com/en/products/result?keywords=RC0603FR-0722KL) | PYu-RC_Group_51_RoHS_L_10.pdf |  |  |  | İnceleme 3: motor sıcaklık girişi seri koruma (sargı yalıtımı bozulursa 60 V'ta pine giren akım ≈ 2.6 mA)
 |  | 83 | Kontrol kartı | FB1 | 1 | FerriteBead | C_0805 | BLM21PG601SN1D | Murata | Ferrit boncuk 600 Ω @100 MHz, 0805 | DigiKey | DigiKey'de ara (https://www.digikey.com/en/products/result?keywords=BLM21PG601SN1D) | BLM21PG datasheet |  |  |  | Referanstaki LCB1608-601Y-N 0603 kılıflı; PCB footprint'i 0805 olduğu için 0805 muadili önerildi
 |  | 84 | Kontrol kartı | L2 | 1 | 33uH | L_Bourns_SRR1260 | SRR1260-330M | Bourns | Güç endüktansı 33 µH, 12.5x12.5 mm, Isat 2.8 A, Irms 3 A | DigiKey | DigiKey'de ara (https://www.digikey.com/en/products/result?keywords=SRR1260-330M) | SRR1260 datasheet |  |  |  | Buck endüktansı (Faz 5). Faz 7: Isat 2.8 A, MIC2128 akım sınırının üst değeri (≈ 2.2 A) üstünde; yeterli
 |  | 85 | Kontrol kartı | Y2, Y3 | 2 | 12MHz Kristal | AS-12.000-18-3030-EXT-SMD-TR | AS-12.000-18-3030-EXT-SMD-TR | Raltron | Kristal 12 MHz 18 pF, HC-49/US SMD 12x4.8 mm (2 pad) | DigiKey | DigiKey'de ara (https://www.digikey.com/en/products/result?keywords=AS-12.000-18-3030-EXT-SMD-TR) | RALTRON |  |  |  | Referansta dsPIC için 40 MHz osilatör (CO4305-40.000) var; tasarımda dsPIC ve CH340 için iki adet 12 MHz kristal kullanılıyor
 |  | 86 | Kontrol kartı | F1 | 1 | PTC 1.1A/33V | Fuse_1812 | 1812L110/33MR | Littelfuse | PTC resettable sigorta 1812, Ihold 1.1 A, Itrip 1.95 A, 33 V | DigiKey / LCSC C142747 | DigiKey'de ara (https://www.digikey.com/en/products/result?keywords=1812L110%2F33MR) | 1812L series datasheet |  |  |  | Faz 7 (inceleme): harici 12 V (J50.1) kart besleme yolunda, D42 öncesi
 |  | 87 | Kontrol kartı | J23 | 1 | USB_IN | USB_C_Receptacle_GCT_USB4105-xx-A_16P_TopMnt_Horizontal | USB4105-GF-A | GCT | USB-C dişi konnektör, 16 pin, yatay SMD | DigiKey | DigiKey'de ara (https://www.digikey.com/en/products/result?keywords=USB4105-GF-A) | USB4105 datasheet
 |  | 88 | Kontrol kartı | SW1 | 1 | SW_Push | SW_SPST_CK_RS282G05A3 | 2 pinli 3x6x4.3 mm SMD buton | - | SMD tact switch (reset) | Motorobit |  | sunrom.com
 |  | 89 | Kontrol kartı | Enkoder_soket1, JICSPSoket1 | 2 | - | PinHeader_1x05 | - | genel | 2.54 mm erkek pin başlık 1x5, düz | genel (Motorobit / Özdisan) |  | - |  |  |  | Kartlar arası konnektör
 |  | 90 | Kontrol kartı | J8 | 1 | - | PinHeader_1x03 | - | genel | 2.54 mm erkek pin başlık 1x3, düz | genel (Motorobit / Özdisan) |  | - |  |  |  | Kartlar arası konnektör
 |  | 91 | Kontrol kartı | J35, J36, J38, J39, J41, J42 | 6 | - | PinSocket_1x03 | - | genel | 2.54 mm dişi soket 1x3, 8.5 mm gövde | genel (Motorobit / Özdisan) |  | - |  |  |  | Kartlar arası konnektör
 |  | 92 | Kontrol kartı | J47 | 1 | - | PinHeader_2x02 | - | genel | 2.54 mm 2x2 ERKEK pin başlık, toplam pin boyu ≥ 25 mm (plastik altında ≥ 17.5 mm) | genel (LCSC 'extra long pin header') |  | - |  |  |  | Faz 7 (inceleme): kontrol kartı altı güç kartı üstünden 23.6 mm yukarıda; J46 soketine girmek için plastik altında ≈ 18 mm pin gerekir. Standart uzun pin yetmez
 |  | 93 | Kontrol kartı | J48 | 1 | - | PinSocket_2x06 | - | genel | 2.54 mm dişi soket 2x6, 8.5 mm gövde | genel (Motorobit / Özdisan) |  | - |  |  |  | Kartlar arası konnektör
 |  | 94 | Kontrol kartı | J50 | 1 | - | PinHeader_1x04 | - | genel | 2.54 mm erkek pin başlık 1x4, düz | genel (Motorobit / Özdisan) |  | - |  |  |  | Kartlar arası konnektör
 |  | 95 | Kontrol kartı | J37, J40, J43, J51, J52 | 5 | - | PinHeader_1x02 | - | genel | 2.54 mm erkek pin başlık 1x2, düz | genel (Motorobit / Özdisan) |  | - |  |  |  | Kartlar arası konnektör
 |  |  | 4 - EESM modülü
 |  | 96 | EESM modülü | Q15, Q16, Q17, Q18 | 4 | IRFB4110PBF | TO-220-3_Vertical | IRFB4110PBF | Infineon | N-kanal MOSFET 100 V, 4.5 mΩ, TO-220AB | DigiKey / Özdisan | DigiKey'de ara (https://www.digikey.com/en/products/result?keywords=IRFB4110PBF) | irfb4110pbf.pdf |  |  |  | DI101N10PQ yerine (Rev 3.0). Güç kartında kartın altında yatık, tab soğutucuya (yalıtkan ped + burç + M3 vida, Mekanik sayfası); EESM'de dik, soğutucusuz. Sahte ürün riski: yetkili distribütörden alın
 |  | 97 | EESM modülü | U15, U16 | 2 | IR2110S | SOIC-16W_7.5x10.3mm_P1.27mm | IR2110STRPBF | Infineon | Yüksek/alçak taraf gate sürücü, SOIC-16W | Motorobit | DigiKey'de ara (https://www.digikey.com/en/products/result?keywords=IR2110STRPBF) | IR2110(-1-2)(S)PbF
 |  | 98 | EESM modülü | U17 | 1 | TLV9001 | TLV9001_LP | TLV9001IDBVR | Texas Instruments | RRIO op-amp 1 MHz, SOT-23-5 | DigiKey | DigiKey'de ara (https://www.digikey.com/en/products/result?keywords=TLV9001IDBVR) | TLV900x datasheet (Rev. R) |  |  |  | Footprint SOT-23-5 (DBV); referanstaki TLV9001TIDCKR SC-70 kılıfı uymaz
 |  | 99 | EESM modülü | U18 | 1 | INA181 | INA181_LP | INA181A1IDBVR | Texas Instruments | Akım ölçüm yükselteci, kazanç 20, SOT-23-6 | DigiKey | DigiKey'de ara (https://www.digikey.com/en/products/result?keywords=INA181A1IDBVR) | INAx181 datasheet (Rev. H)
 |  | 100 | EESM modülü | D18, D32 | 2 | US1D | D_SMA | US1D-E3/61T | Vishay | Ultra hızlı diyot 1 A 200 V, SMA | DigiKey | DigiKey'de ara (https://www.digikey.com/en/products/result?keywords=US1D-E3%2F61T) | US1A-US1M datasheet |  |  |  | Bootstrap diyodu (SS18 yerine, Faz 2)
 |  | 101 | EESM modülü | D33, D34, D35, D36 | 4 | SS18 | D_SMA | SS18 | onsemi | Schottky diyot 1 A 80 V, SMA | Özdisan | DigiKey'de ara (https://www.digikey.com/en/products/result?keywords=SS18) | SK12-SK110 |  |  |  | VCC-VB (bootstrap) ve gate deşarj diyotu olarak kullanılıyor
 |  | 102 | EESM modülü | C79, C83 | 2 | 2.2uF/25V | C_1206 | CL31B225KAHNNNE | Samsung | MLCC 2.2 µF 25 V X7R 1206 | Özdisan | DigiKey'de ara (https://www.digikey.com/en/products/result?keywords=CL31B225KAHNNNE) | SAMSUNG MLCC_JAN-2024.pdf |  |  |  | Revizyonla eklendi
 |  | 103 | EESM modülü | C76, C77, C80, C82, C90, C162, C166 | 7 | 1uF | C_0603 | C0603X5R105K250NT | OEM | MLCC 1 µF 25 V X5R 0603 | Özdisan | DigiKey'de ara (https://www.digikey.com/en/products/result?keywords=C0603X5R105K250NT) | -
 |  | 104 | EESM modülü | C84 | 1 | 1nF C0G | C_0603 | GRM1885C1H102JA01D | Murata | MLCC 1 nF 50 V C0G 0603 (ölçüm filtresi) | DigiKey | DigiKey'de ara (https://www.digikey.com/en/products/result?keywords=GRM1885C1H102JA01D) | GRM188 datasheet |  |  |  | Faz 4
 |  | 105 | EESM modülü | C85, C86 | 2 | 1nF | C_0603 | CL10B102KB8NNNC | Samsung | MLCC 1 nF 50 V X7R 0603 | Özdisan | DigiKey'de ara (https://www.digikey.com/en/products/result?keywords=CL10B102KB8NNNC) | SAMSUNG MLCC_JAN-2024.pdf
 |  | 106 | EESM modülü | C140 | 1 | 100uF/63V | CP_Elec_10x10.5 | EEE-FK1J101P | Panasonic | Alüminyum elektrolitik SMD 100 µF 63 V, 10x10.2 mm (EESM bulk, R13) | DigiKey | DigiKey'de ara (https://www.digikey.com/en/products/result?keywords=EEE-FK1J101P) | Panasonic FK serisi |  |  |  | Revizyon R13 ile eklendi; 10x10.5 mm footprint'e uyan muadil seçilebilir
 |  | 107 | EESM modülü | C141, C142 | 2 | 2.2uF/100V | C_1206 | 885012208124 | Würth Elektronik | MLCC 2.2 µF 100 V X7R 1206, bara kapasitörü (seramik) | DigiKey | DigiKey'de ara (https://www.digikey.com/en/products/result?keywords=885012208124) | WCAP-CSGP 1206 datasheet
 |  | 108 | EESM modülü | C159, C163 | 2 | 22uF/25V | C_1206 | CL31A226KAHNNNE | Samsung | MLCC 22 µF 25 V X5R 1206 | Özdisan | DigiKey'de ara (https://www.digikey.com/en/products/result?keywords=CL31A226KAHNNNE) | SAMSUNG MLCC_JAN-2024.pdf |  |  |  | Gate sürücü VCC dekuplajı
 |  | 109 | EESM modülü | C78, C81, C87, C88, C89, C160, C161, C164, C165 | 9 | 100nF | C_0603 | CL10B104KB8NNNC | Samsung | MLCC 100 nF 50 V X7R 0603 | Özdisan | DigiKey'de ara (https://www.digikey.com/en/products/result?keywords=CL10B104KB8NNNC) | SAMSUNG MLCC_JAN-2024.pdf
 |  | 110 | EESM modülü | C197, C198 | 2 | 4.7uF/100V | C_1210 | HMK325C7475KN-TE | Taiyo Yuden | MLCC 4.7 µF 100 V X7S 1210 (bara seramik) | DigiKey | DigiKey'de ara (https://www.digikey.com/en/products/result?keywords=HMK325C7475KN-TE) | GRM32E datasheet |  |  |  | Faz başına yüksek frekans bara dekuplajı (Faz 3)
 |  | 111 | EESM modülü | R77, R78, R80, R83, R85, R86, R89, R90, R94, R95 | 10 | 10k | R_0603 | RC0603JR-0710KL | YAGEO | Direnç 10 kΩ %5 0603 | Özdisan | DigiKey'de ara (https://www.digikey.com/en/products/result?keywords=RC0603JR-0710KL) | PYu-RC_Group_51_RoHS_L_10.pdf
 |  | 112 | EESM modülü | R76, R81, R82, R87, R88, R91, R92 | 7 | 10 | R_0805 | 0805S8J0100T5E | ROYALOHM | Direnç 10 Ω %5 0805 (gate direnci) | Özdisan | DigiKey'de ara (https://www.digikey.com/en/products/result?keywords=0805S8J0100T5E) | general_royalohm.pdf
 |  | 113 | EESM modülü | R93 | 1 | 100 | R_0805 | 0805S8J0101T5E | ROYALOHM | Direnç 100 Ω %5 0805 | Özdisan | DigiKey'de ara (https://www.digikey.com/en/products/result?keywords=0805S8J0101T5E) | general_royalohm.pdf
 |  | 114 | EESM modülü | R96 | 1 | 5mR 2512 3W | R_2512 | WSLP25125L000FEA | Vishay | Şönt 5 mΩ %1 3 W 2512 (EESM akım ölçümü) | DigiKey | DigiKey'de ara (https://www.digikey.com/en/products/result?keywords=WSLP25125L000FEA) | WSLP datasheet |  |  |  | EESM uyartım akımı
 |  | 115 | EESM modülü | R114, R115, R116, R117 | 4 | 2.2 | R_0603 | WR06X2R2 JGL | WALSIN | Direnç 2.2 Ω %5 0603 | Özdisan | DigiKey'de ara (https://www.digikey.com/en/products/result?keywords=WR06X2R2+JGL) | ASC_WR_V32
 |  | 116 | EESM modülü | J49 | 1 | - | PinHeader_2x06 | - | genel | 2.54 mm erkek pin başlık 2x6, düz | genel (Motorobit / Özdisan) |  | - |  |  |  | Kartlar arası konnektör
 |  |  |  | TOPLAM |  |  |  |  |  |  |  |  |  |  |  |  | Fiyatı girilmemiş satırlar toplama katılmaz

Sheet: Toplu Sipariş
Toplu sipariş listesi (aynı MPN tüm kartlarda birleştirildi)
MPN | Üretici | Açıklama | Tedarikçi | Adet / set | Toplam adet | Birim fiyat (TL) | Toplam fiyat (TL)
IRFB4110PBF | Infineon | N-kanal MOSFET 100 V, 4.5 mΩ, TO-220AB | DigiKey / Özdisan
5.0SMDJ58CA | Littelfuse | TVS diyot 58 V çift yönlü 5000 W, SMC | DigiKey
HMK325C7475KN-TE | Taiyo Yuden | MLCC 4.7 µF 100 V X7S 1210 (bara seramik) | DigiKey
GRM3195C2A472JA01D | Murata | MLCC 4.7 nF 100 V C0G 1206 (snubber) | DigiKey
PKLH-100V102MK400 | KOSHIN | Alüminyum elektrolitik 1000 µF ±%20 100 V, KLH serisi, Ø18 x 40 mm radyal, P 7.5 mm, Z ≤ 0.076 Ω (100 kHz), IRMS 2.5 A (100 kHz, 105 °C), 5000 h @ 105 °C | Özdisan
BVR-Z-R0002-1.0 | Isabellenhütte | 4 uçlu (Kelvin) şönt 0.2 mΩ %1, 4026 | DigiKey / Mouser
RC0603JR-0710KL | YAGEO | Direnç 10 kΩ %5 0603 | Özdisan
CRCW20102R20FKEF | Vishay | Direnç 2.2 Ω %1 0.75 W 2010 (yüksek taraf RC snubber) | DigiKey
CRCW12102R20FKEA | Vishay | Direnç 2.2 Ω %1 0.5 W 1210 (alçak taraf RC snubber) | DigiKey
CRCW251210K0FKEG | Vishay | Direnç 10 kΩ %1 1 W 2512 (bara deşarj) | DigiKey
- | genel | 2.54 mm dişi soket 1x2, 8.5 mm gövde | genel (Motorobit / Özdisan)
- | genel | 2.54 mm dişi soket 1x3, 8.5 mm gövde | genel (Motorobit / Özdisan)
- | genel | 2.54 mm dişi soket 2x2, 8.5 mm gövde – riser | genel (Motorobit / Özdisan)
IR2110STRPBF | Infineon | Yüksek/alçak taraf gate sürücü, SOIC-16W | Motorobit
SS18 | onsemi | Schottky diyot 1 A 80 V, SMA | Özdisan
US1D-E3/61T | Vishay | Ultra hızlı diyot 1 A 200 V, SMA | DigiKey
CL10B104KB8NNNC | Samsung | MLCC 100 nF 50 V X7R 0603 | Özdisan
CL31B225KAHNNNE | Samsung | MLCC 2.2 µF 25 V X7R 1206 | Özdisan
C0603X5R105K250NT | OEM | MLCC 1 µF 25 V X5R 0603 | Özdisan
CL31A226KAHNNNE | Samsung | MLCC 22 µF 25 V X5R 1206 | Özdisan
0805S8J0100T5E | ROYALOHM | Direnç 10 Ω %5 0805 (gate direnci) | Özdisan
WR06X2R2 JGL | WALSIN | Direnç 2.2 Ω %5 0603 | Özdisan
- | genel | 2.54 mm erkek pin başlık 1x3, düz | genel (Motorobit / Özdisan)
ESQ-102-xx-T-S sınıfı (uzun kuyruklu) | Samtec / genel | 2.54 mm 1x2 STACKING dişi soket: üstte 8.5 mm soket, altta ≥ 10.5 mm uzun kuyruk (Arduino stacking header tipi) | Samtec / LCSC
IRLML0100TRPBF | Infineon | N-kanal MOSFET 100 V 1.6 A, SOT-23 | DigiKey
AO3400A | Alpha & Omega | N-kanal MOSFET 30 V 5.7 A, SOT-23 | DigiKey
ADUM1201ARZ | Analog Devices | Çift kanallı dijital izolatör, SOIC-8 | DigiKey
CH340G | WCH | USB-UART dönüştürücü, SOP-16 | Motorobit
DSPIC33CK256MP508-I/PT | Microchip Technology | dsPIC33CK DSC, 256 KB, TQFP-80 12x12 | DigiKey
LDL1117S33R | STMicroelectronics | LDO 3.3 V 1.2 A, SOT-223, seramik çıkış kondansatörüyle kararlı | DigiKey
MIC2128YML-TR | Microchip Technology | Senkron buck denetleyici, VQFN-16 3x3 | DigiKey
TLV9001IDBVR | Texas Instruments | RRIO op-amp 1 MHz, SOT-23-5 | DigiKey
INA181A1IDBVR | Texas Instruments | Akım ölçüm yükselteci, kazanç 20, SOT-23-6 | DigiKey
LDL1117S50R | STMicroelectronics | LDO 5.0 V 1.2 A, SOT-223 (CAN beslemesi) | DigiKey
TJA1051T/3/1J | NXP | Yüksek hızlı CAN alıcı-verici, SOIC-8 | DigiKey
SP0503BAHTG | Littelfuse | 3 kanallı ESD dizisi, SOT-143 | DigiKey
USBLC6-2SC6 | STMicroelectronics | USB ESD koruma dizisi, SOT-23-6 | DigiKey
TSR 1-2450 | TRACO Power | DC-DC regülatör modülü 5 V 1 A, SIP-3 | DigiKey
NUP2105LT1G | onsemi | CAN hattı ESD koruma, SOT-23 | DigiKey
B340A-13-F | Diodes Inc. | Schottky diyot 3 A 40 V, SMA (DO-214AC) | DigiKey
SMAJ15A | Littelfuse | TVS diyot 400 W tek yönlü, VRWM 15 V, VC 24.4 V, SMA | DigiKey / LCSC
CL10B103KB8NNNC | Samsung | MLCC 10 nF 50 V X7R 0603 | Özdisan
CL21B104KCFNNNE | Samsung | MLCC 100 nF 100 V X7R 0805 | Özdisan
CL10B472KB8NNNC | Samsung | MLCC 4.7 nF 50 V X7R 0603 | Özdisan
CL10A106MA8NRNC | Samsung | MLCC 10 µF 25 V X5R 0603 | Özdisan
CL10B224KB8NNNC | Samsung | MLCC 220 nF 50 V X7R 0603 | Özdisan
GRM1885C1H102JA01D | Murata | MLCC 1 nF 50 V C0G 0603 (ölçüm filtresi) | DigiKey
CL31A106KAHNNNE | Samsung | MLCC 10 µF 25 V X5R 1206 (12 V çıkışı, R6) | Özdisan
CL21A226MPQNNNE | Samsung | MLCC 22 µF 10 V X5R 0805 | Özdisan
CC0603JRNPO9BN270 | YAGEO | MLCC 27 pF 50 V NP0 0603 (kristal yükü) | Özdisan
CL21A106KAYNNNE | Samsung | MLCC 10 µF 25 V X5R 0805 | Özdisan
885012208124 | Würth Elektronik | MLCC 2.2 µF 100 V X7R 1206, bara kapasitörü (seramik) | DigiKey
CL21A475KPFNNNE | Samsung | MLCC 4.7 µF 10 V X5R 0805 | Özdisan
CL10B102KB8NNNC | Samsung | MLCC 1 nF 50 V X7R 0603 | Özdisan
RC0805FR-075K6L | YAGEO | Direnç 5.6 kΩ %1 0805 | Özdisan
0603SAJ0203T5E | ROYALOHM | Direnç 20 kΩ %5 0603 | Özdisan
RC0805FR-071K05L | YAGEO | Direnç 1.05 kΩ %1 0805 | Özdisan
0603SAJ0104T5E | ROYALOHM | Direnç 100 kΩ %5 0603 | Özdisan
CRCW060360K4FKEA | Vishay | Direnç 60.4 kΩ %1 0603 | Özdisan
0805S8J0512T5E | ROYALOHM | Direnç 5.1 kΩ %5 0805 (USB-C CC) | Özdisan
RC0603FR-072K2L | YAGEO | Direnç 2.2 kΩ %1 0603 | Özdisan
0805S8J0472T5E | ROYALOHM | Direnç 4.7 kΩ %5 0805 (V_BUS bölücü, R7) | Özdisan
0805S8J0101T5E | ROYALOHM | Direnç 100 Ω %5 0805 | Özdisan
0805S8J0102T5E | ROYALOHM | Direnç 1 kΩ %5 0805 | Özdisan
0805S8J0152T5E | ROYALOHM | Direnç 1.5 kΩ %5 0805 | Özdisan
RC0805JR-070RL | YAGEO | Direnç 0 Ω 0805 (köprü) | Özdisan
RC1206FR-07470KL | YAGEO | Direnç 470 kΩ %1 1206 (yüksek gerilim bölücü) | Özdisan
RC0603FR-0727KL | YAGEO | Direnç 27 kΩ %1 0603 (buck EN bölücüsü) | Özdisan
RC0805FR-07120RL | YAGEO | Direnç 120 Ω %1 0805 (CAN sonlandırma) | Özdisan
RG1608P-103-B-T5 | Susumu | Direnç 10 kΩ %0.1 25 ppm 0603 (ölçüm bölücü) | DigiKey
RG1608P-222-B-T5 | Susumu | Direnç 2.2 kΩ %0.1 25 ppm 0603 (motor sıcaklık sensörü pull-up) | DigiKey
RC0603FR-0722KL | YAGEO | Direnç 22 kΩ %1 0603 | DigiKey
BLM21PG601SN1D | Murata | Ferrit boncuk 600 Ω @100 MHz, 0805 | DigiKey
SRR1260-330M | Bourns | Güç endüktansı 33 µH, 12.5x12.5 mm, Isat 2.8 A, Irms 3 A | DigiKey
AS-12.000-18-3030-EXT-SMD-TR | Raltron | Kristal 12 MHz 18 pF, HC-49/US SMD 12x4.8 mm (2 pad) | DigiKey
1812L110/33MR | Littelfuse | PTC resettable sigorta 1812, Ihold 1.1 A, Itrip 1.95 A, 33 V | DigiKey / LCSC C142747
USB4105-GF-A | GCT | USB-C dişi konnektör, 16 pin, yatay SMD | DigiKey
2 pinli 3x6x4.3 mm SMD buton | - | SMD tact switch (reset) | Motorobit
- | genel | 2.54 mm erkek pin başlık 1x5, düz | genel (Motorobit / Özdisan)
- | genel | 2.54 mm 2x2 ERKEK pin başlık, toplam pin boyu ≥ 25 mm (plastik altında ≥ 17.5 mm) | genel (LCSC 'extra long pin header')
- | genel | 2.54 mm dişi soket 2x6, 8.5 mm gövde | genel (Motorobit / Özdisan)
- | genel | 2.54 mm erkek pin başlık 1x4, düz | genel (Motorobit / Özdisan)
- | genel | 2.54 mm erkek pin başlık 1x2, düz | genel (Motorobit / Özdisan)
EEE-FK1J101P | Panasonic | Alüminyum elektrolitik SMD 100 µF 63 V, 10x10.2 mm (EESM bulk, R13) | DigiKey
WSLP25125L000FEA | Vishay | Şönt 5 mΩ %1 3 W 2512 (EESM akım ölçümü) | DigiKey
- | genel | 2.54 mm erkek pin başlık 2x6, düz | genel (Motorobit / Özdisan)
 |  |  | TOPLAM
 |  |  | Kontrol: BOM sayfası toplamı

Sheet: Mekanik ve Montaj
Kart dışı malzemeler (montaj, soğutucu, bağlantı)
Kalem | Adet / set | Toplam adet | Açıklama | Not
PCB – Güç kartı (Katman 1) | 1 |  | 120 x 161 mm, 2 katman, 2 oz (24 x KLH kapasitör yüksek taraf MOSFET'lerin üstünde) | Evde üretim: iz ≥ 1.5 mm, via ≥ 1.0/1.8 mm (bldc_driver_ai.kicad_dru). xSH barı, faz bağlantıları ve şönt GND viyaları bakır telle takviye edilmeli
PCB – Gate driver kartı (Katman 2) | 3 |  | 2 katman, U/V/W
PCB – Kontrol kartı (Katman 3) | 1 |  | 2 katman
PCB – EESM modülü (Katman 4) | 1 |  | 2 katman
Alüminyum soğutucu levha | 1 |  | Düz plaka, 15 mm kalınlık, ≈ 92 x 54 mm (yalnız 12 MOSFET gövdesinin altı) | 12 adet M3 havşalı geçiş deliği (TO-220 vidaları alttan girer)
TO-220 yalıtkan ısıl ped | 12 |  | Silikon (Sil-Pad) TO-220, ≥1.5 kV | IRFB4110 tabı dren potansiyelinde: tab–levha arasına zorunlu
TO-220 yalıtkan burç (omuzlu) | 12 |  | TO-220 tab deliği için naylon/polyamid omuzlu burç (M3) | ZORUNLU: vida ile tab arasında yalıtım
Naylon düz pul M3, Ø7 mm (somun altı) | 12 |  | PA66, M3, dış çap 7 mm | Somun tabın üstünde, kartın altında kalır; metal pul KULLANMAYIN
M3 havşa başlı vida + somun (TO-220) | 12 |  | M3x10 havşa başlı + M3 somun; vida soğutucunun altından girer, somun tabın üstünde | Kartta TO-220 deliği yok (kapasitörler üstte): MOSFET'ler kart lehimlenmeden önce soğutucuya sabitlenir. Vida ucu somundan ≤ 2 mm taşmalı
M3 vida + ara parça 8.5 mm | 8 |  | H1–H8, kartı soğutucuya / tabana sabitleme | Kart soğutucunun 8.5 mm üstünde (TO-220 4.5 + ped 0.3 + 3.7 mm boşluk). Kapasitör bacakları HS MOSFET gövdelerinin üstüne gelir: bacak ucu ≤ 1.5 mm kesilmeli (≈ 2.2 mm pay kalır)
M5 cıvata + somun + kablo pabucu | 5 |  | J1–J5 bara bağlantıları (VBAT, GND, U, V, W) | Kartın sağ kenarındaki şeritte; kontrol kartının yanında, üstü açık
Pabuç makaronu / izolasyon başlığı | 2 |  | 25–35 mm² pabuç için ısıyla daralan kalın makaron veya PVC başlık (J1 VBAT kırmızı, J2 GND siyah) | ZORUNLU: J1–J2 merkezleri arası 15 mm, pabuçlar dönünce değebilir (bataryaya kısa devre). Pabuç dili kart kenarına doğru bağlanmalı
Kablo 2.5 mm² | 1 |  | EESM besleme (J44 VBAT_EESM, J45 GND_EESM) ve J6/J7 | Uzunluk montaja göre
Kart arası ara parça (spacer) M3 | 12 |  | Kat aralığı 11 mm (gate/kontrol/EESM) | Adet montaj şekline göre değişebilir

Sheet: Notlar
Notlar
1. Bu BOM doğrudan bldc_driver_ai.kicad_pcb dosyasındaki 460 footprint'ten üretildi.
2. Listeye alınmayanlar: net-tie (NT1–NT8, bakır köprü, parça yok), montaj delikleri (H1–H8), M5 pabuç pad'leri (J1–J5) ve kablo lehim pad'leri (J6, J7, J44, J45). Bunların donanımı 'Mekanik ve Montaj' sayfasında.
3. Parça numaraları ve tedarikçiler referans BOM'dan (yardımcı_dokuman/pmsm_bom.pdf) alındı. Referansta olmayan ya da tasarımla uyuşmayan kalemler turuncu işaretli; nedeni 'Not' sütununda.
4. Referansta olup tasarımda olmayan: CO4305-40.000 osilatör (yerine 12 MHz kristal). Referanstaki SMCJ58A yerine 5.0SMDJ58CA bara TVS'i (D38, D39) kullanıldı. JP1 lehim köprüsüdür, parça değildir.
5. Ürün arama bağlantıları DigiKey arama sayfasını açar; Özdisan ve Motorobit için aynı MPN ile arama yapın.
6. Fiyat sütunları boş bırakıldı; birim fiyatları girince toplam maliyet otomatik hesaplanır.
7. Gate driver satırları üç kartın (U, V, W) toplamını gösterir; referans sütunundaki numaralar üç karta aittir.
