tekcanyilmaz42-gif/bldc_driver/montaj/3d/gate_driver_v.step

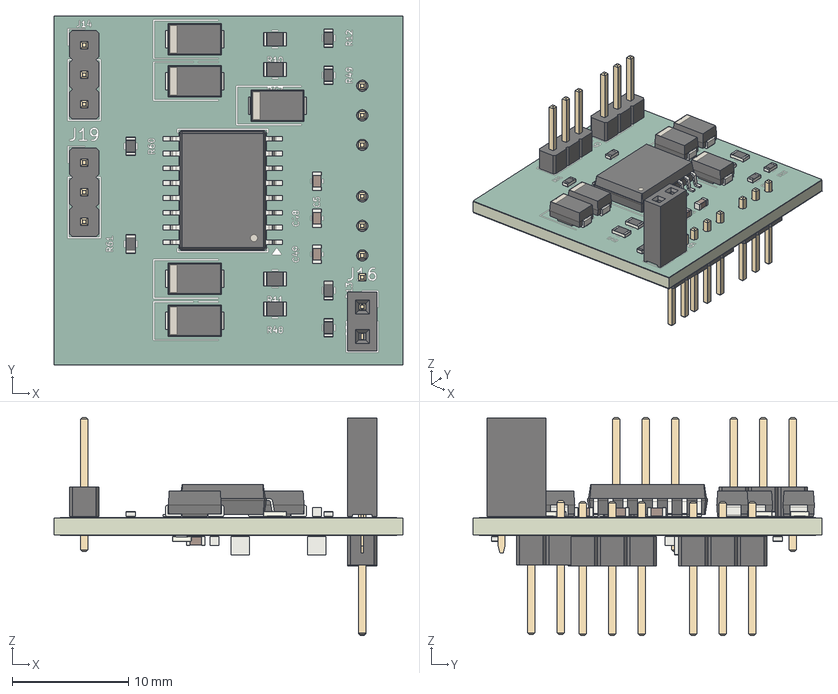
[picture p8: CAD file, 2026-11-07]
montaj/3d/gate_driver_v.step
30.0 x 30.0 x 18.8 mm
R_0603_1608Metric x 10
PinSocket_1x02_P2.54mm_Vertical
PinHeader_1x02_P254mm_Vertical
D_SMA x 5
R_0805_2012Metric x 4
C_0603_1608Metric x 6
SOIC-16W_7.5x10.3mm_P1.27mm
PinHeader_1x03_P254mm_Vertical x 4
C_1206_3216Metric x 2
gate_driver_v_copper
gate_driver_v_via
gate_driver_v_silkscreen x 2
gate_driver_v_soldermask x 2
gate_driver_v_PCB
