tekcanyilmaz42-gif/bldc_driver/yardımcı_dokuman/3d/kontrol_karti.step

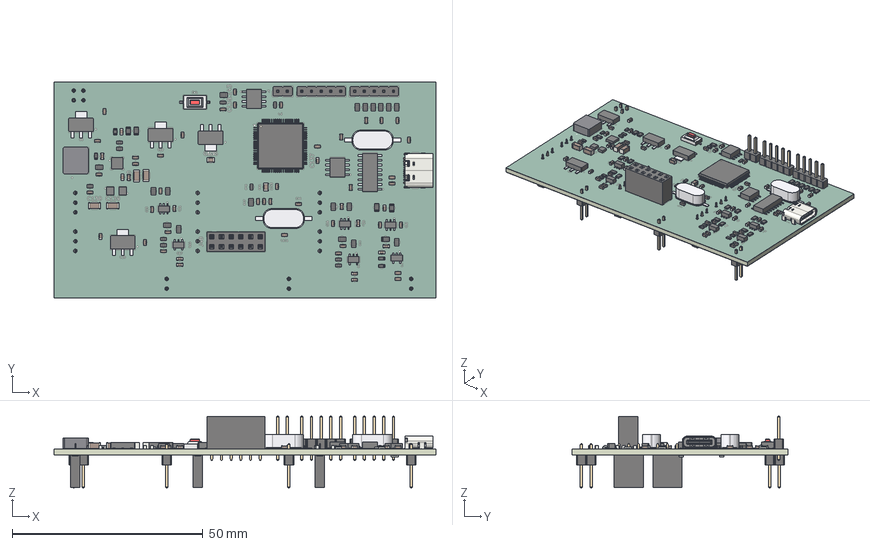
[picture p9: CAD file, 2026-11-04]
yardımcı_dokuman/3d/kontrol_karti.step
100.0 x 56.5 x 18.8 mm
R_0603_1608Metric x 14
C_0603_1608Metric x 55
Leads x 16
R_0805_2012Metric x 25
C_1206_3216Metric x 4
PinHeader_1x02_P254mm_Vertical x 4
MoldedBody x 3
ThermalPad x 3
PinSocket_2x06_P2.54mm_Vertical
PinHeader_1x05_P254mm_Vertical x 2
SOT223Body x 4
C_0805_2012Metric x 2
MetalCan x 2
SMDLeads x 2
LQFP-80_12x12mm_P0.5mm
SW_SPST_CK_RS282G05A3
USB_C_Receptacle_16P_TopMnt_Horizontal_GCT_USB4105-xx-A
InductorCore
Terminals
PinSocket_1x03_P2.54mm_Vertical x 6
PinHeader_2x02_P254mm_Vertical
kontrol_karti_copper
kontrol_karti_via
kontrol_karti_silkscreen x 2
kontrol_karti_soldermask x 2
kontrol_karti_PCB
