tekcanyilmaz42-gif/bldc_driver/montaj/3d/gate_driver_u.step

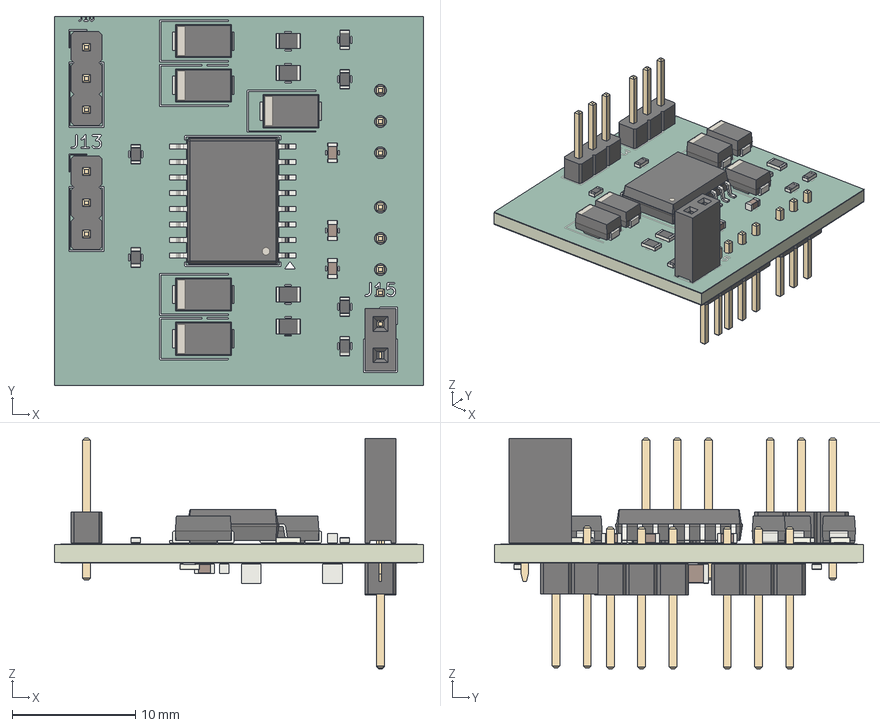
[picture p12: CAD file, 2026-11-07]
montaj/3d/gate_driver_u.step
30.0 x 30.0 x 18.8 mm
PinHeader_1x03_P254mm_Vertical x 4
R_0805_2012Metric x 4
C_0603_1608Metric x 6
PinSocket_1x02_P2.54mm_Vertical
PinHeader_1x02_P254mm_Vertical
D_SMA x 5
R_0603_1608Metric x 10
SOIC-16W_7.5x10.3mm_P1.27mm
C_1206_3216Metric x 2
gate_driver_u_copper
gate_driver_u_via
gate_driver_u_silkscreen x 2
gate_driver_u_soldermask x 2
gate_driver_u_PCB
