tekcanyilmaz42-gif/bldc_driver/montaj/3d/guc_karti.step

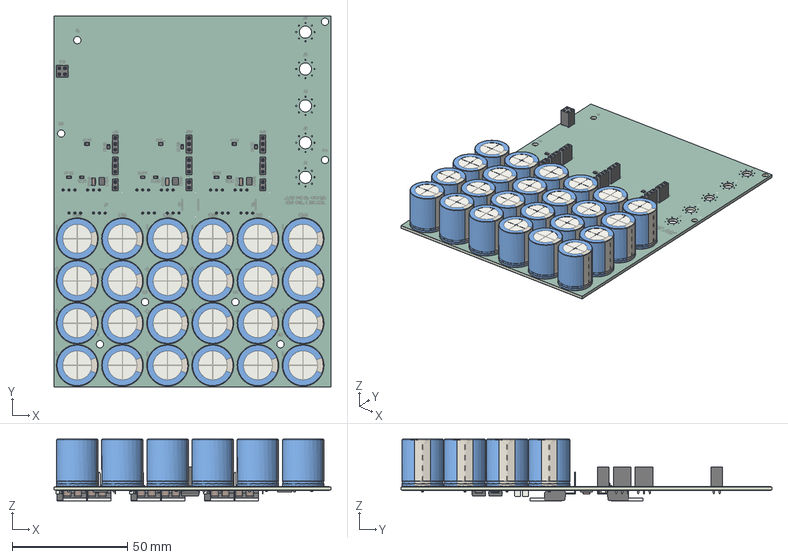
[picture p13: CAD file, 2026-11-07]
montaj/3d/guc_karti.step
120.0 x 161.0 x 26.7 mm
CP_Radial_D180mm_P750mm x 24
PinSocket_1x03_P2.54mm_Vertical x 6
R_0805_2012Metric x 12
R_1210_3225Metric x 3
C_1206_3216Metric x 6
PinSocket_1x02_P2.54mm_Vertical x 3
PinSocket_2x02_P2.54mm_Vertical
TO-220-3_Horizontal_TabUp x 12
C_1210_3225Metric x 24
R_2512_6332Metric x 3
R_2010_5025Metric x 3
D_SMC x 2
guc_karti_copper
guc_karti_via
guc_karti_silkscreen x 2
guc_karti_soldermask x 2
guc_karti_PCB
