tekcanyilmaz42-gif/bldc_driver/yardımcı_dokuman/3d/eesm_modulu.step

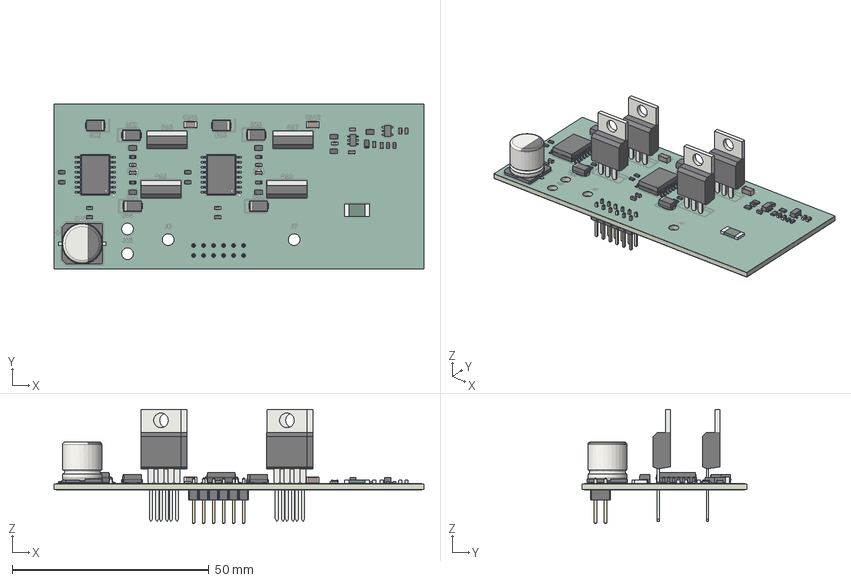
[picture p14: CAD file, 2026-11-04]
yardımcı_dokuman/3d/eesm_modulu.step
94.0 x 42.0 x 29.0 mm
CP_Elec_10x105
R_0603_1608Metric x 10
C_0603_1608Metric x 15
D_SMA x 6
TO-220-3_Vertical x 4
R_0805_2012Metric x 8
SOIC-16W_7.5x10.3mm_P1.27mm x 2
C_1206_3216Metric x 2
ResistorBody
Terminations
Leads x 2
PinHeader_2x06_P254mm_Vertical
eesm_modulu_copper
eesm_modulu_via
eesm_modulu_silkscreen x 2
eesm_modulu_soldermask x 2
eesm_modulu_PCB
