tekcanyilmaz42-gif/bldc_driver/yardımcı_dokuman/3d/guc_karti.step

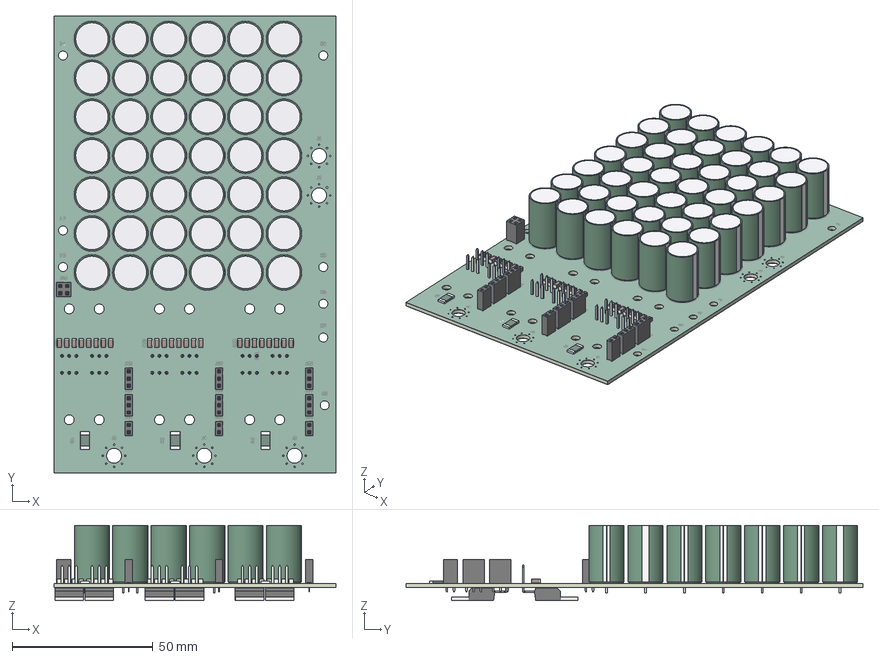
[picture p15: CAD file, 2026-11-04]
yardımcı_dokuman/3d/guc_karti.step
100.0 x 162.0 x 26.7 mm
C_1206_3216Metric x 24
PinSocket_1x03_P2.54mm_Vertical x 6
SleeveBody x 42
AluminumTopVent x 42
CathodeStripe x 42
BottomSeal x 42
WireLeads x 42
ResistorBody x 3
Terminations x 3
PinSocket_1x02_P2.54mm_Vertical x 3
PinSocket_2x02_P2.54mm_Vertical
TO-220-3_Horizontal_TabUp x 12
guc_karti_copper
guc_karti_silkscreen x 2
guc_karti_soldermask x 2
guc_karti_PCB
