tekcanyilmaz42-gif/bldc_driver/(list of files, cad)

Other CAD files:
montaj/3d/kontrol_karti.step
yardımcı_dokuman/3d/gate_driver_v.step
yardımcı_dokuman/3d/gate_driver_w.step
montaj/3d/gate_driver_w.step
