tekcanyilmaz42-gif/bldc_driver/montaj/render_guc_karti_alt.png

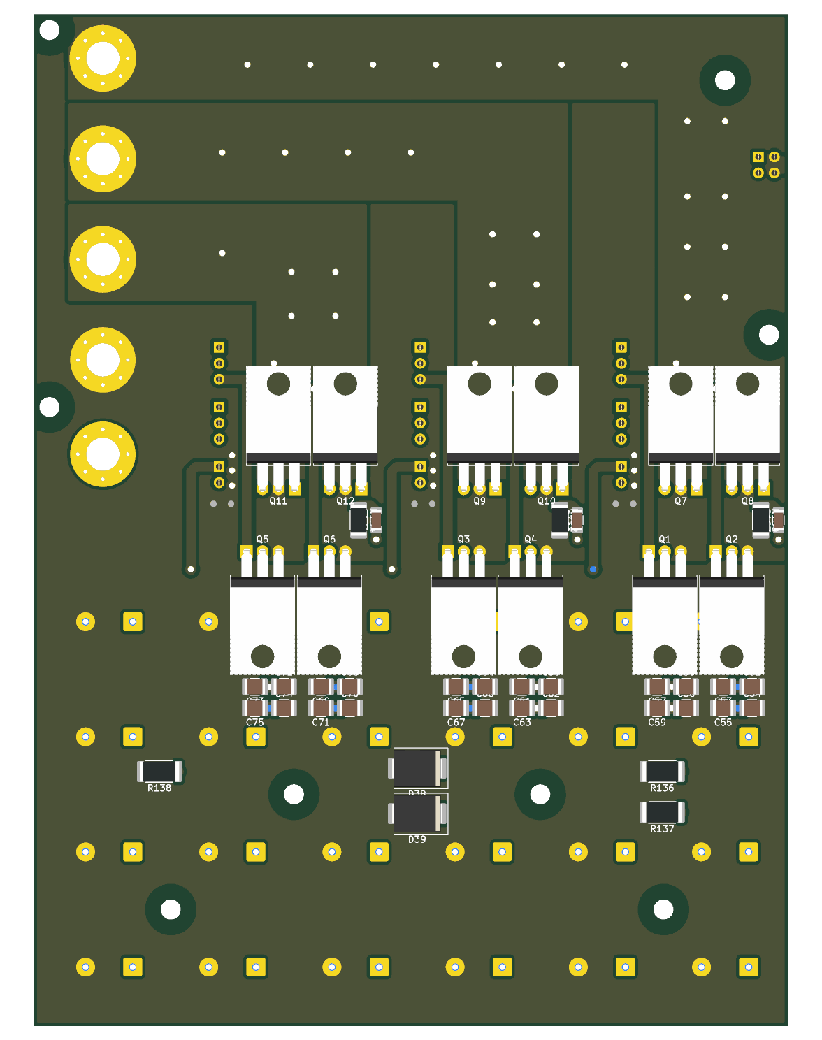
montaj/render_guc_karti_alt.png
