tekcanyilmaz42-gif/bldc_driver/montaj/render_montaj_iso.png

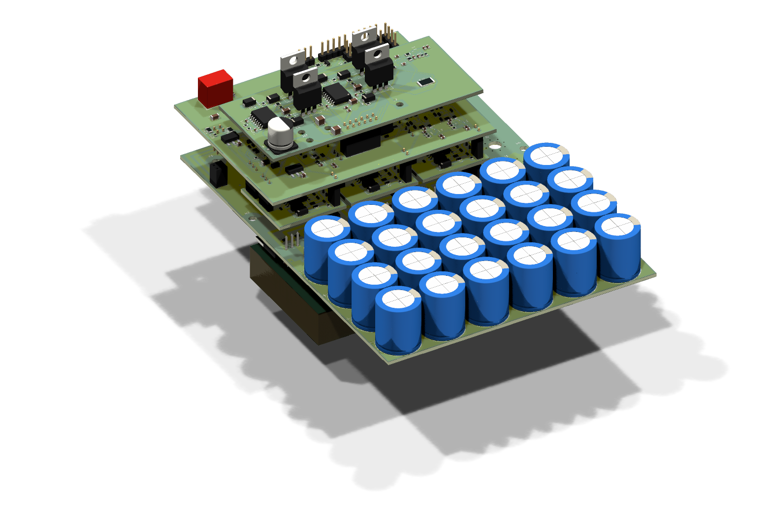
montaj/render_montaj_iso.png
