tekcanyilmaz42-gif/bldc_driver/montaj/render_montaj_yan.png

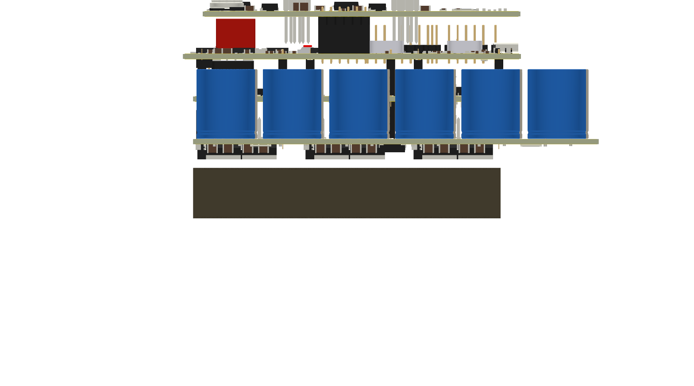
montaj/render_montaj_yan.png
