tekcanyilmaz42-gif/bldc_driver/montaj/render_pcb_ust.png

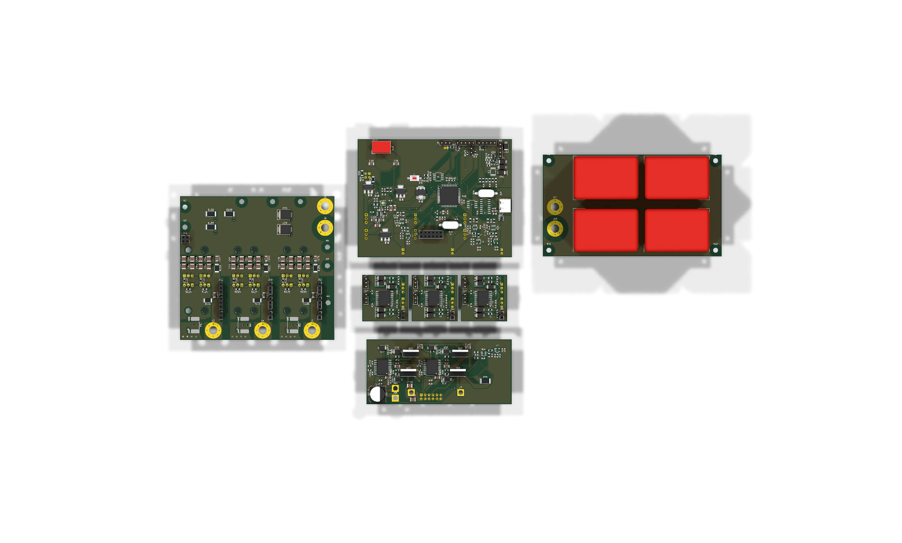
montaj/render_pcb_ust.png
