tekcanyilmaz42-gif/bldc_driver/bldc_driver_ai.pdf

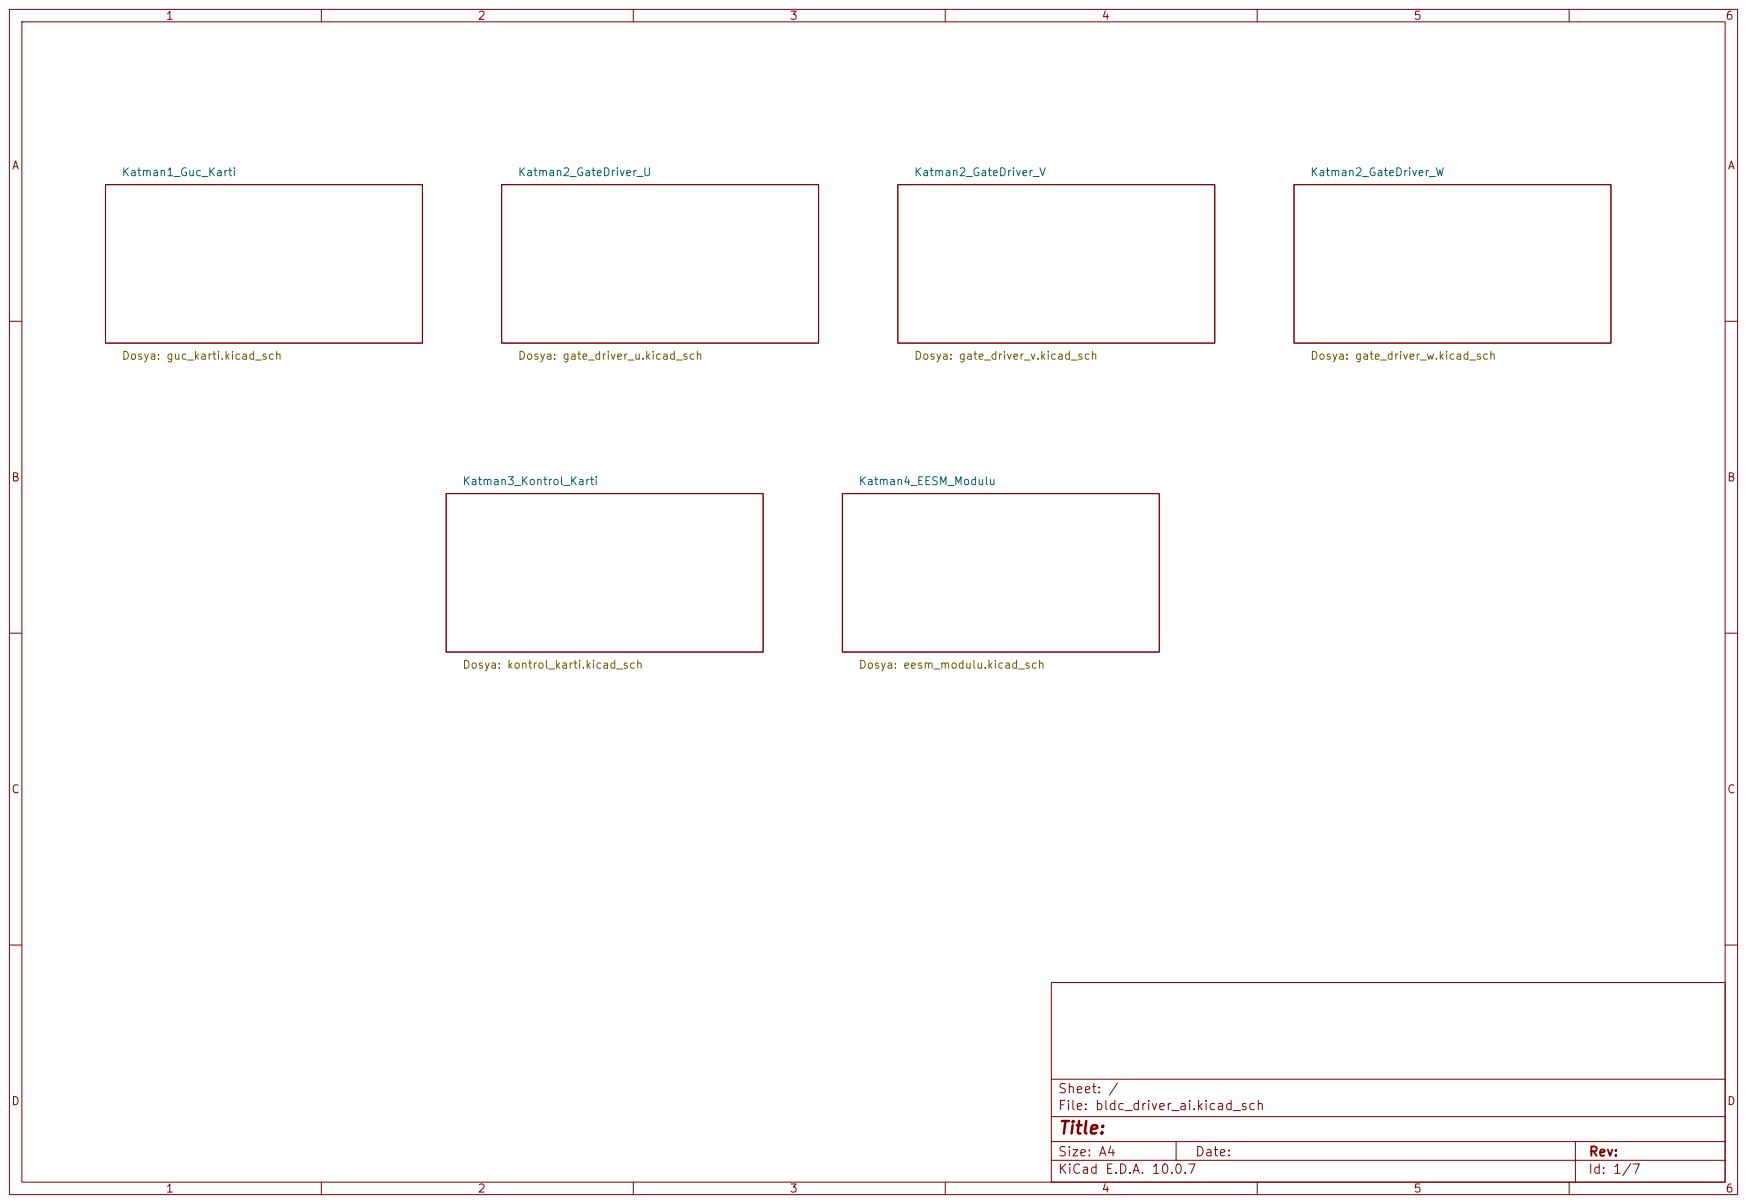
[picture p21: page 1]

Size: A4 | Rev:
KiCad E.D.A. 10.0.7 | Id: 1/7

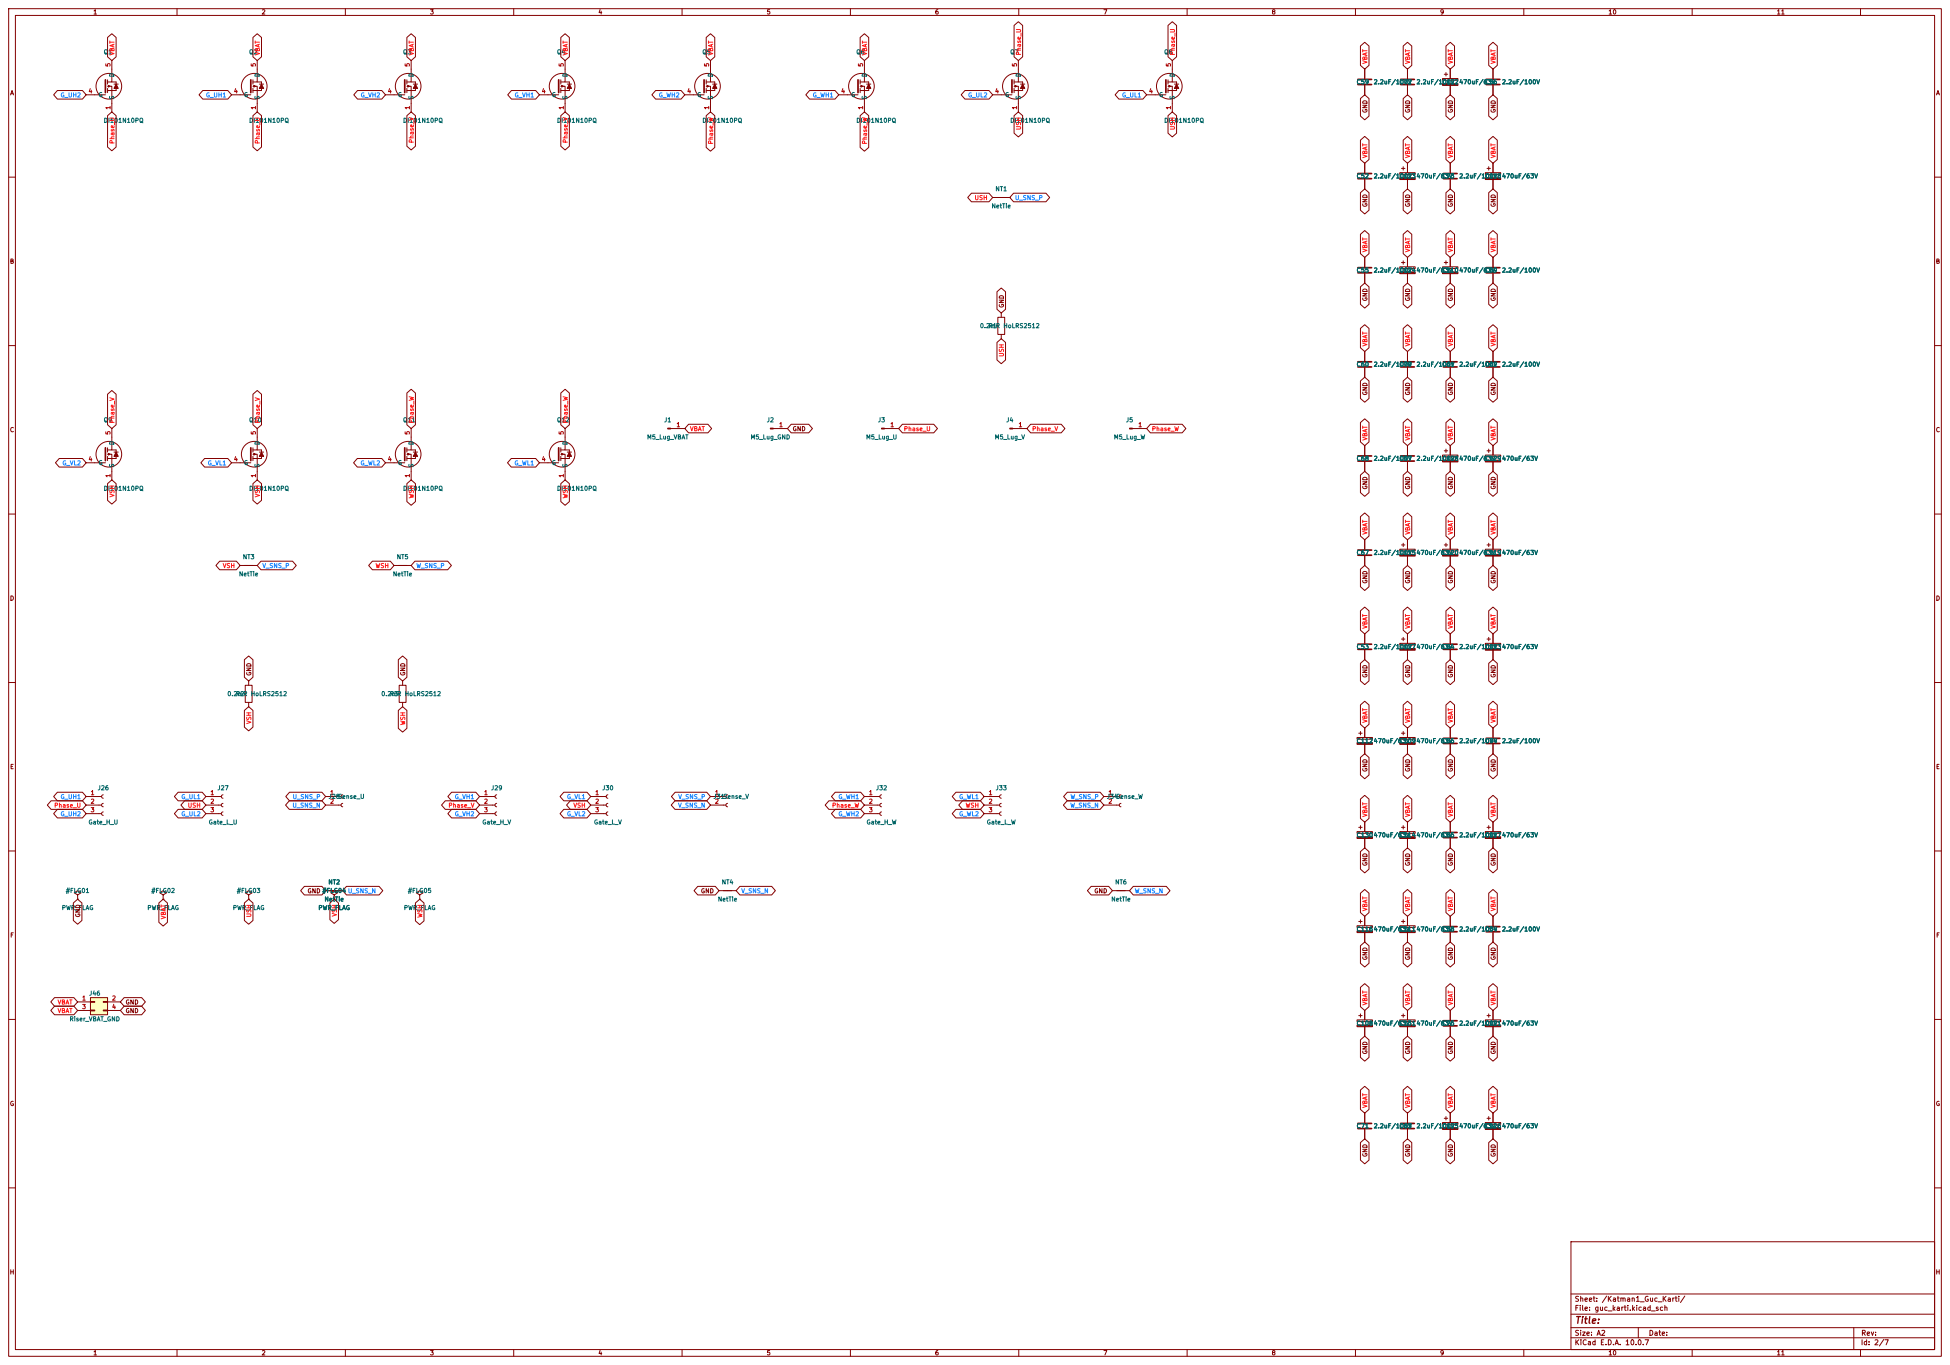
[picture p22: page 2]

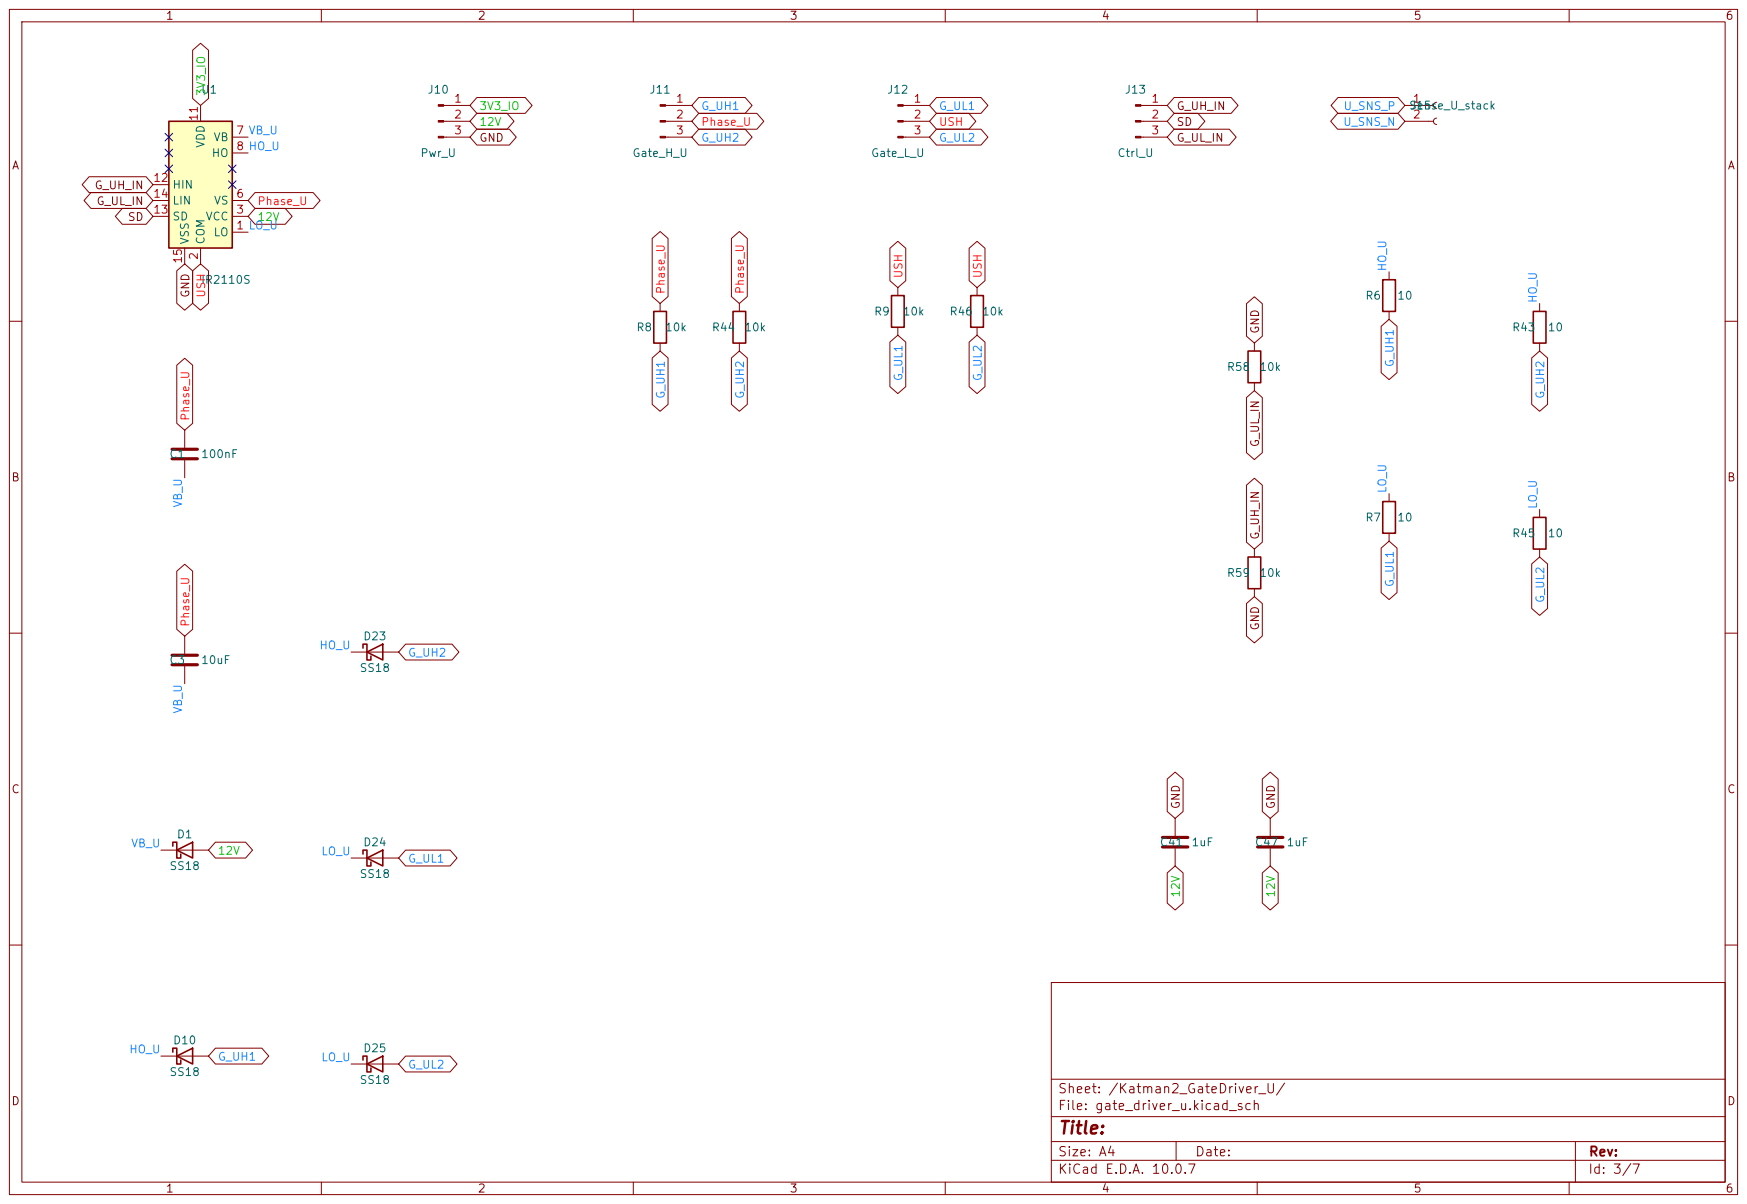
[picture p23: page 3]

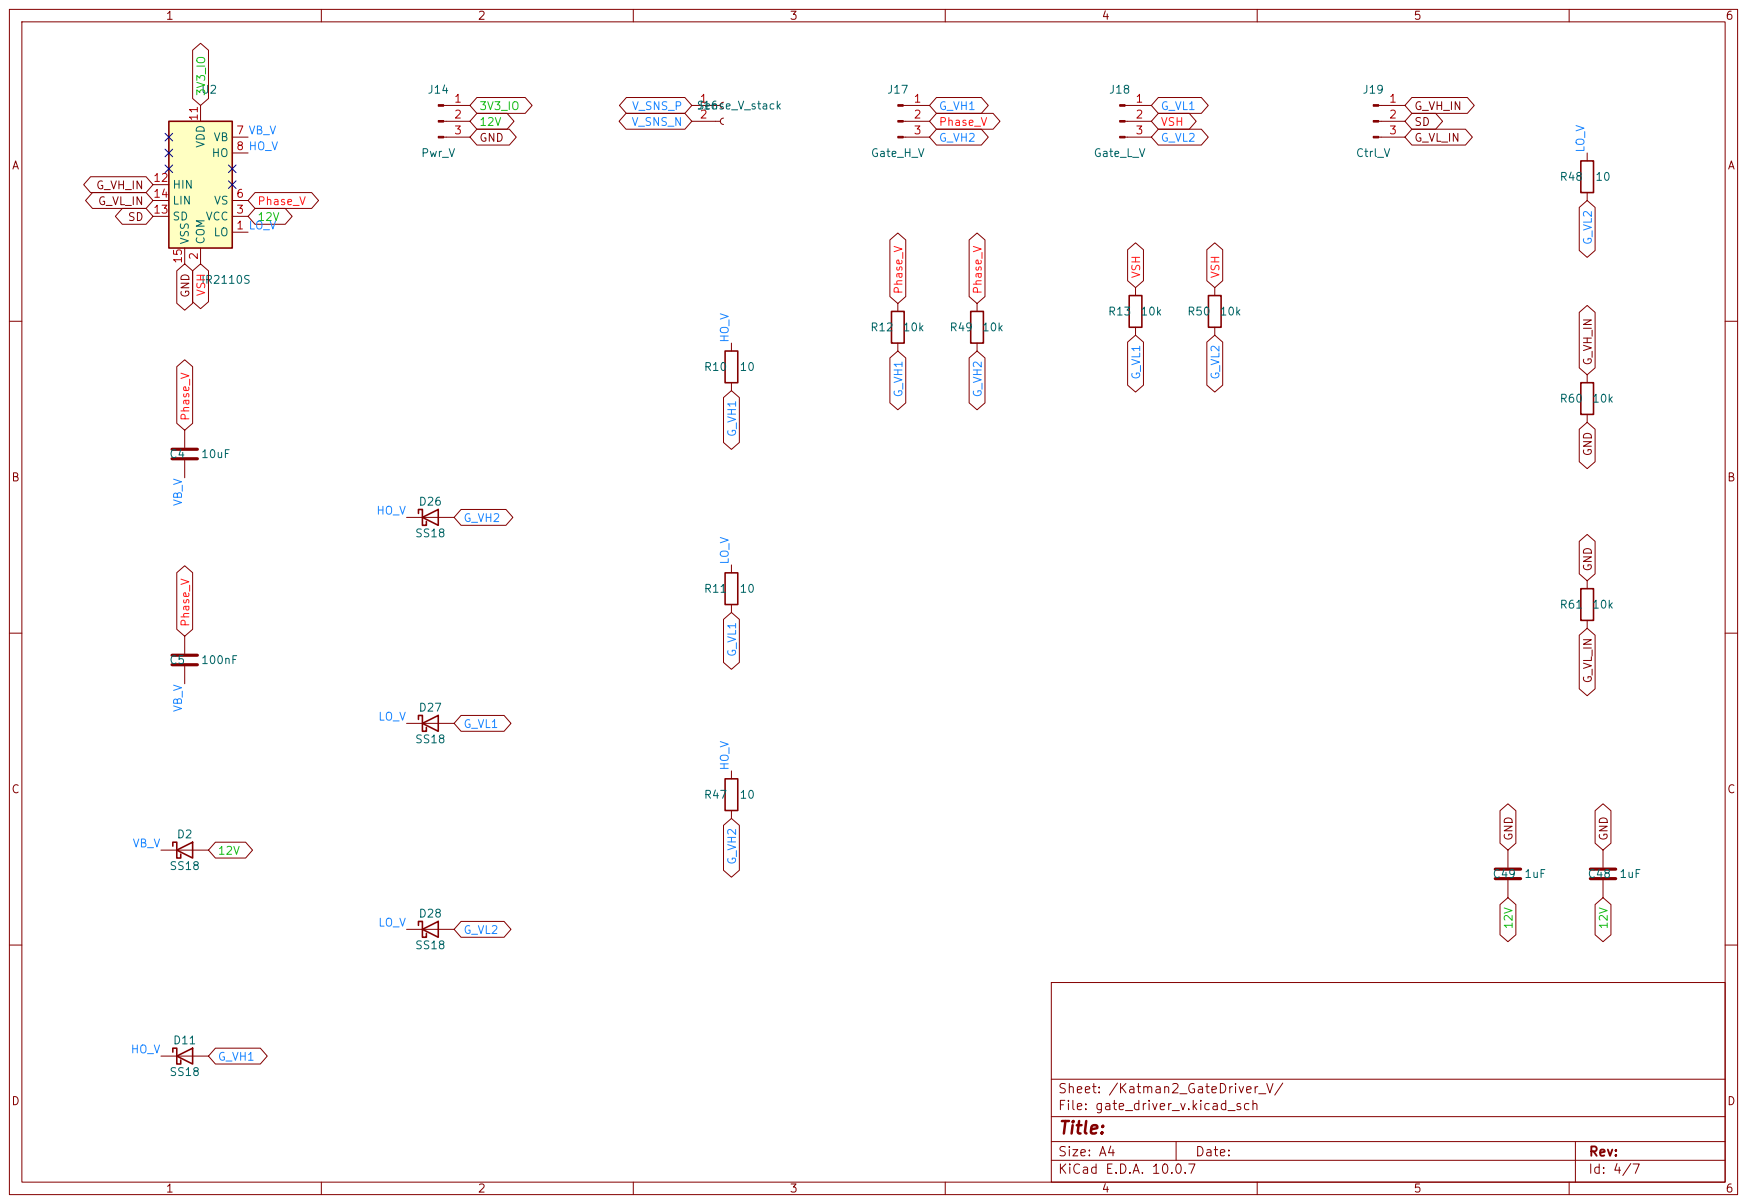
[picture p24: page 4]

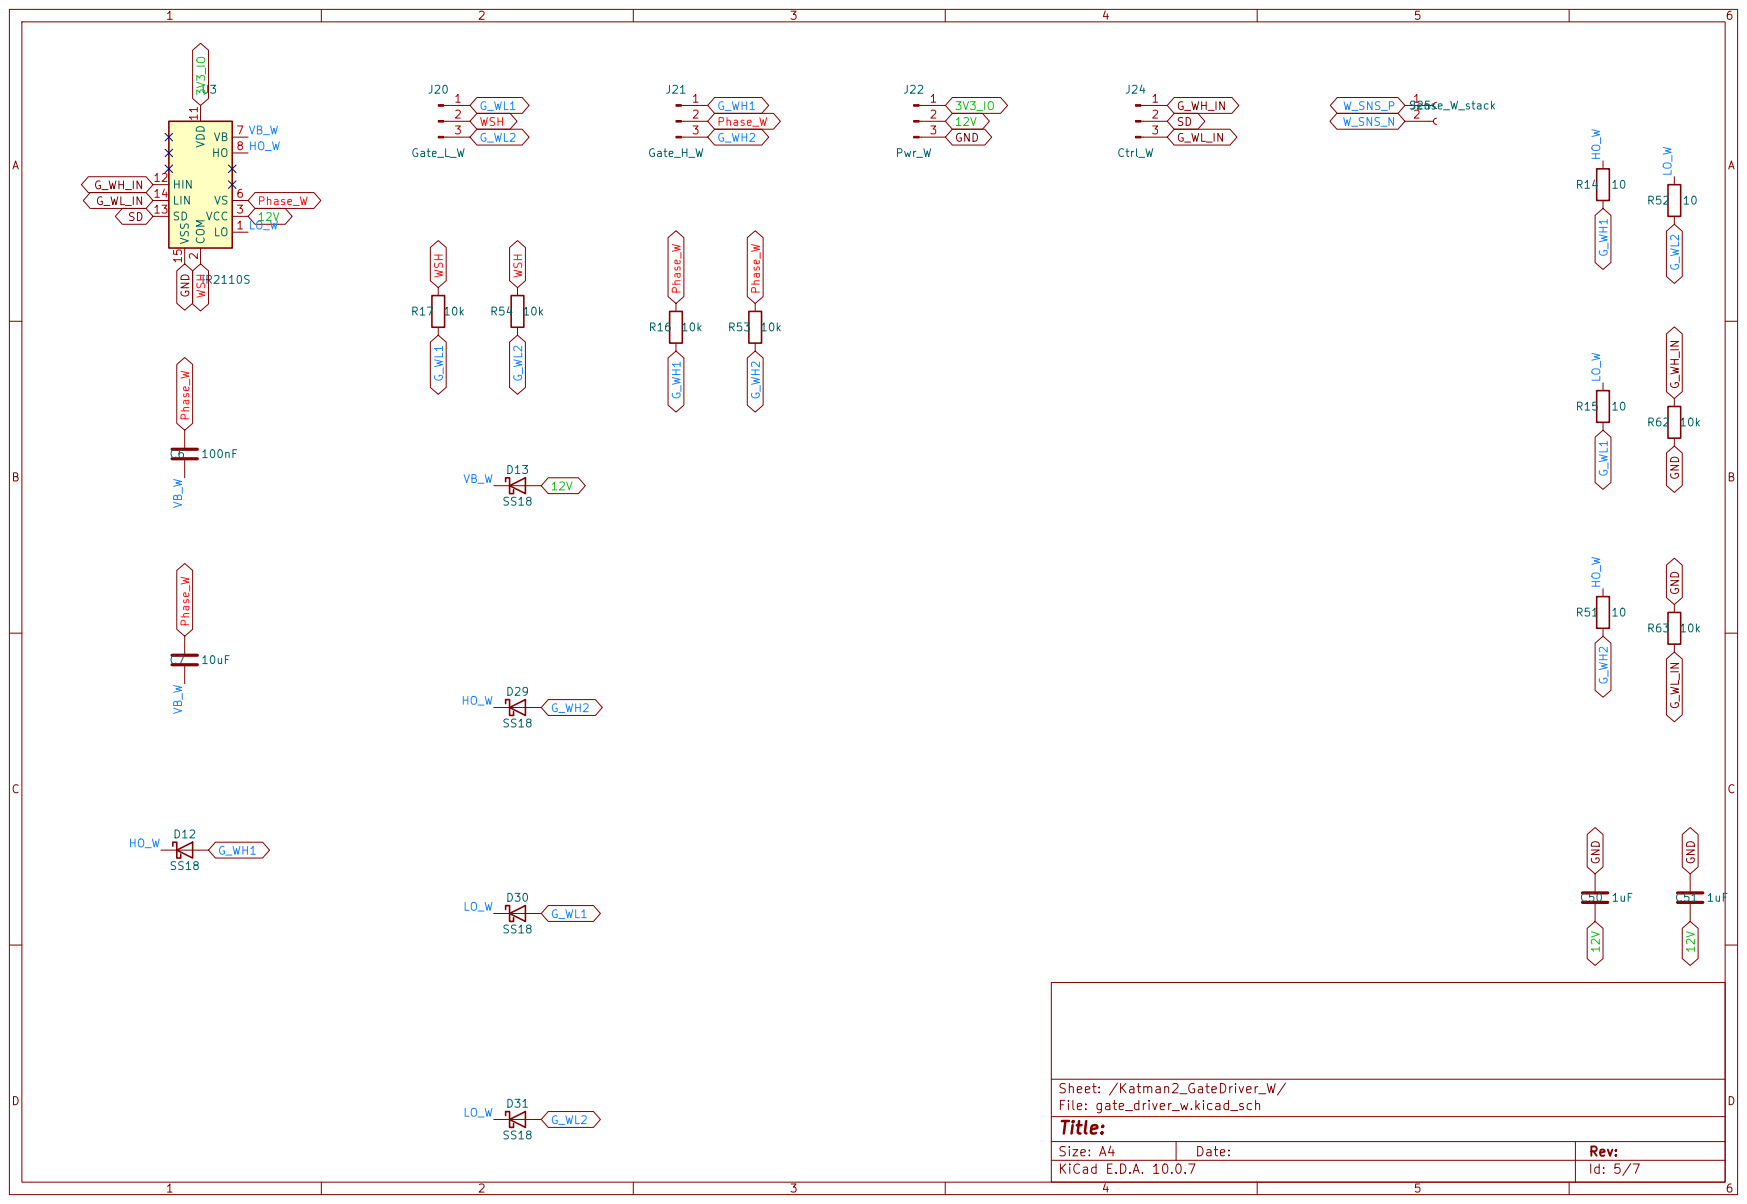
[picture p25: page 5]

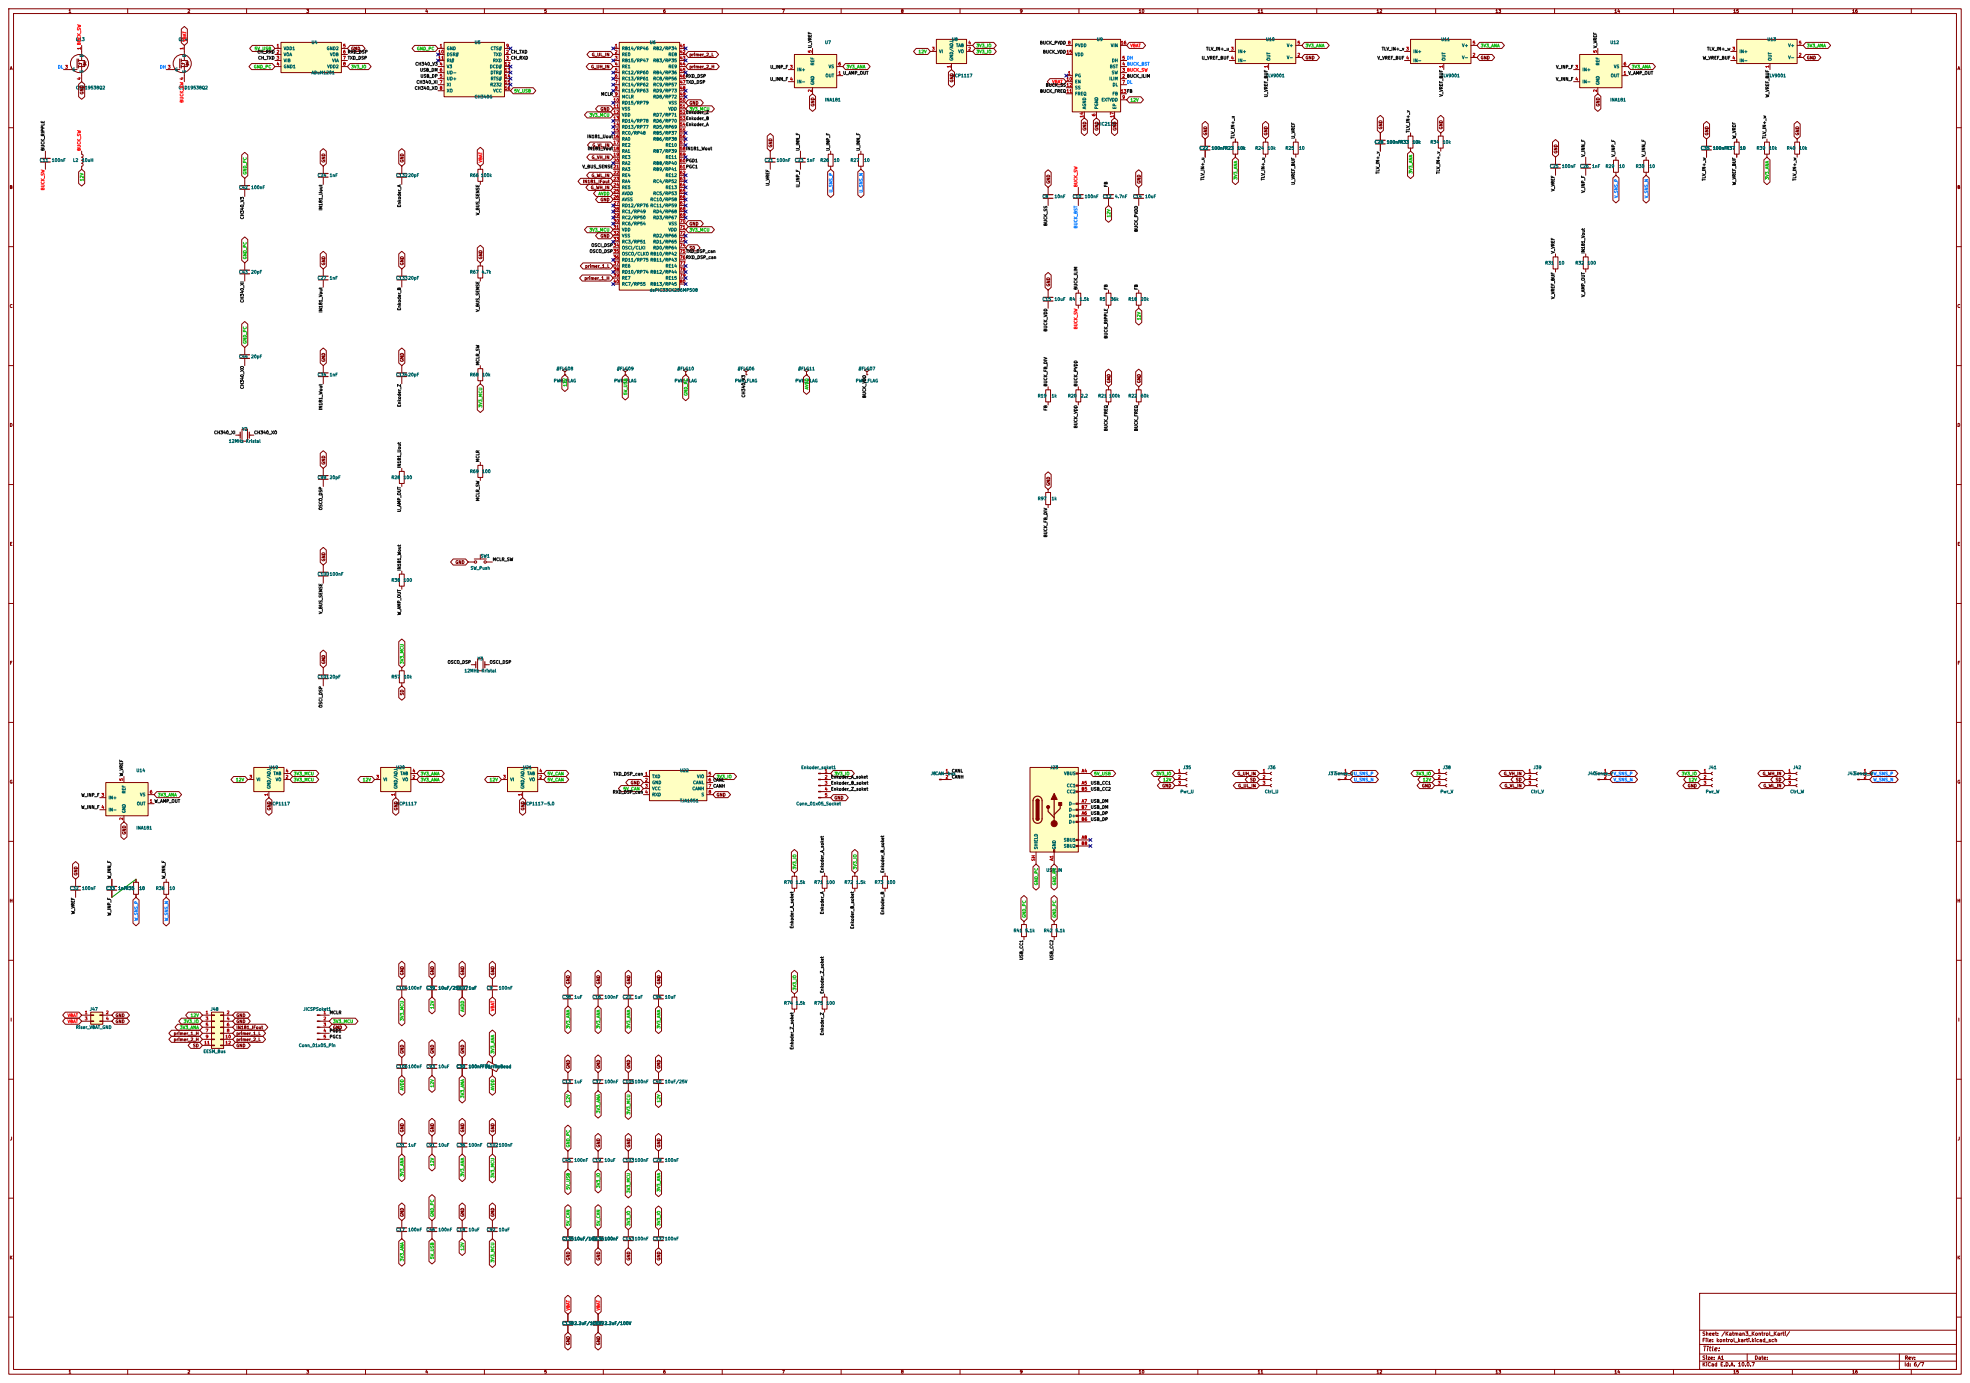
[picture p26: page 6]

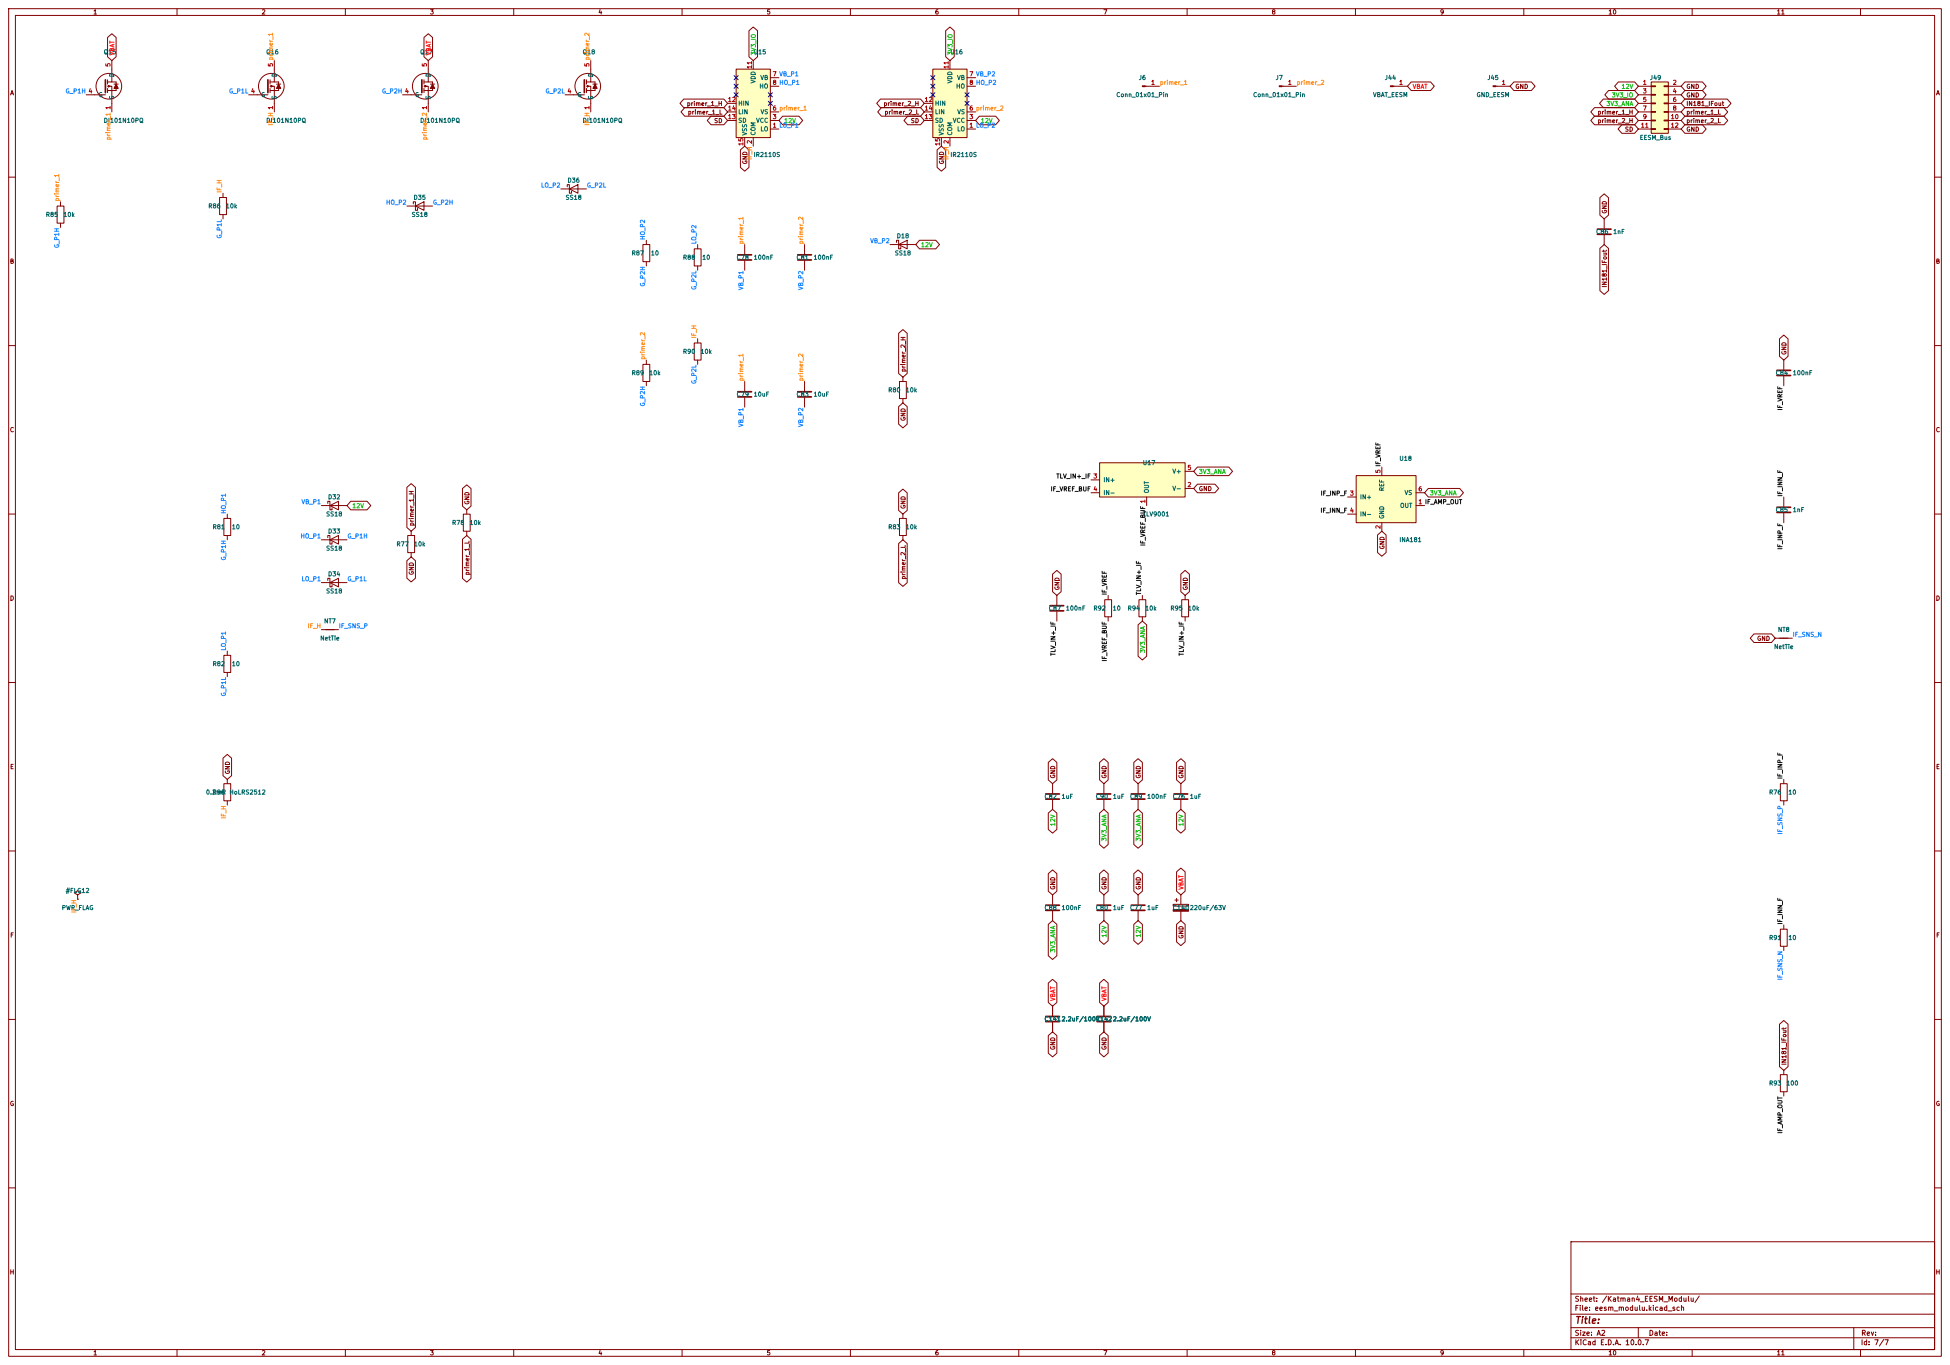
[picture p27: page 7]
