tekcanyilmaz42-gif/bldc_driver/yedek_faz7/pre_inceleme3/bldc_driver_ai.kicad_pcb

## KiCad design yedek_faz7/pre_inceleme3/bldc_driver_ai.kicad_pcb (2026-11-06)

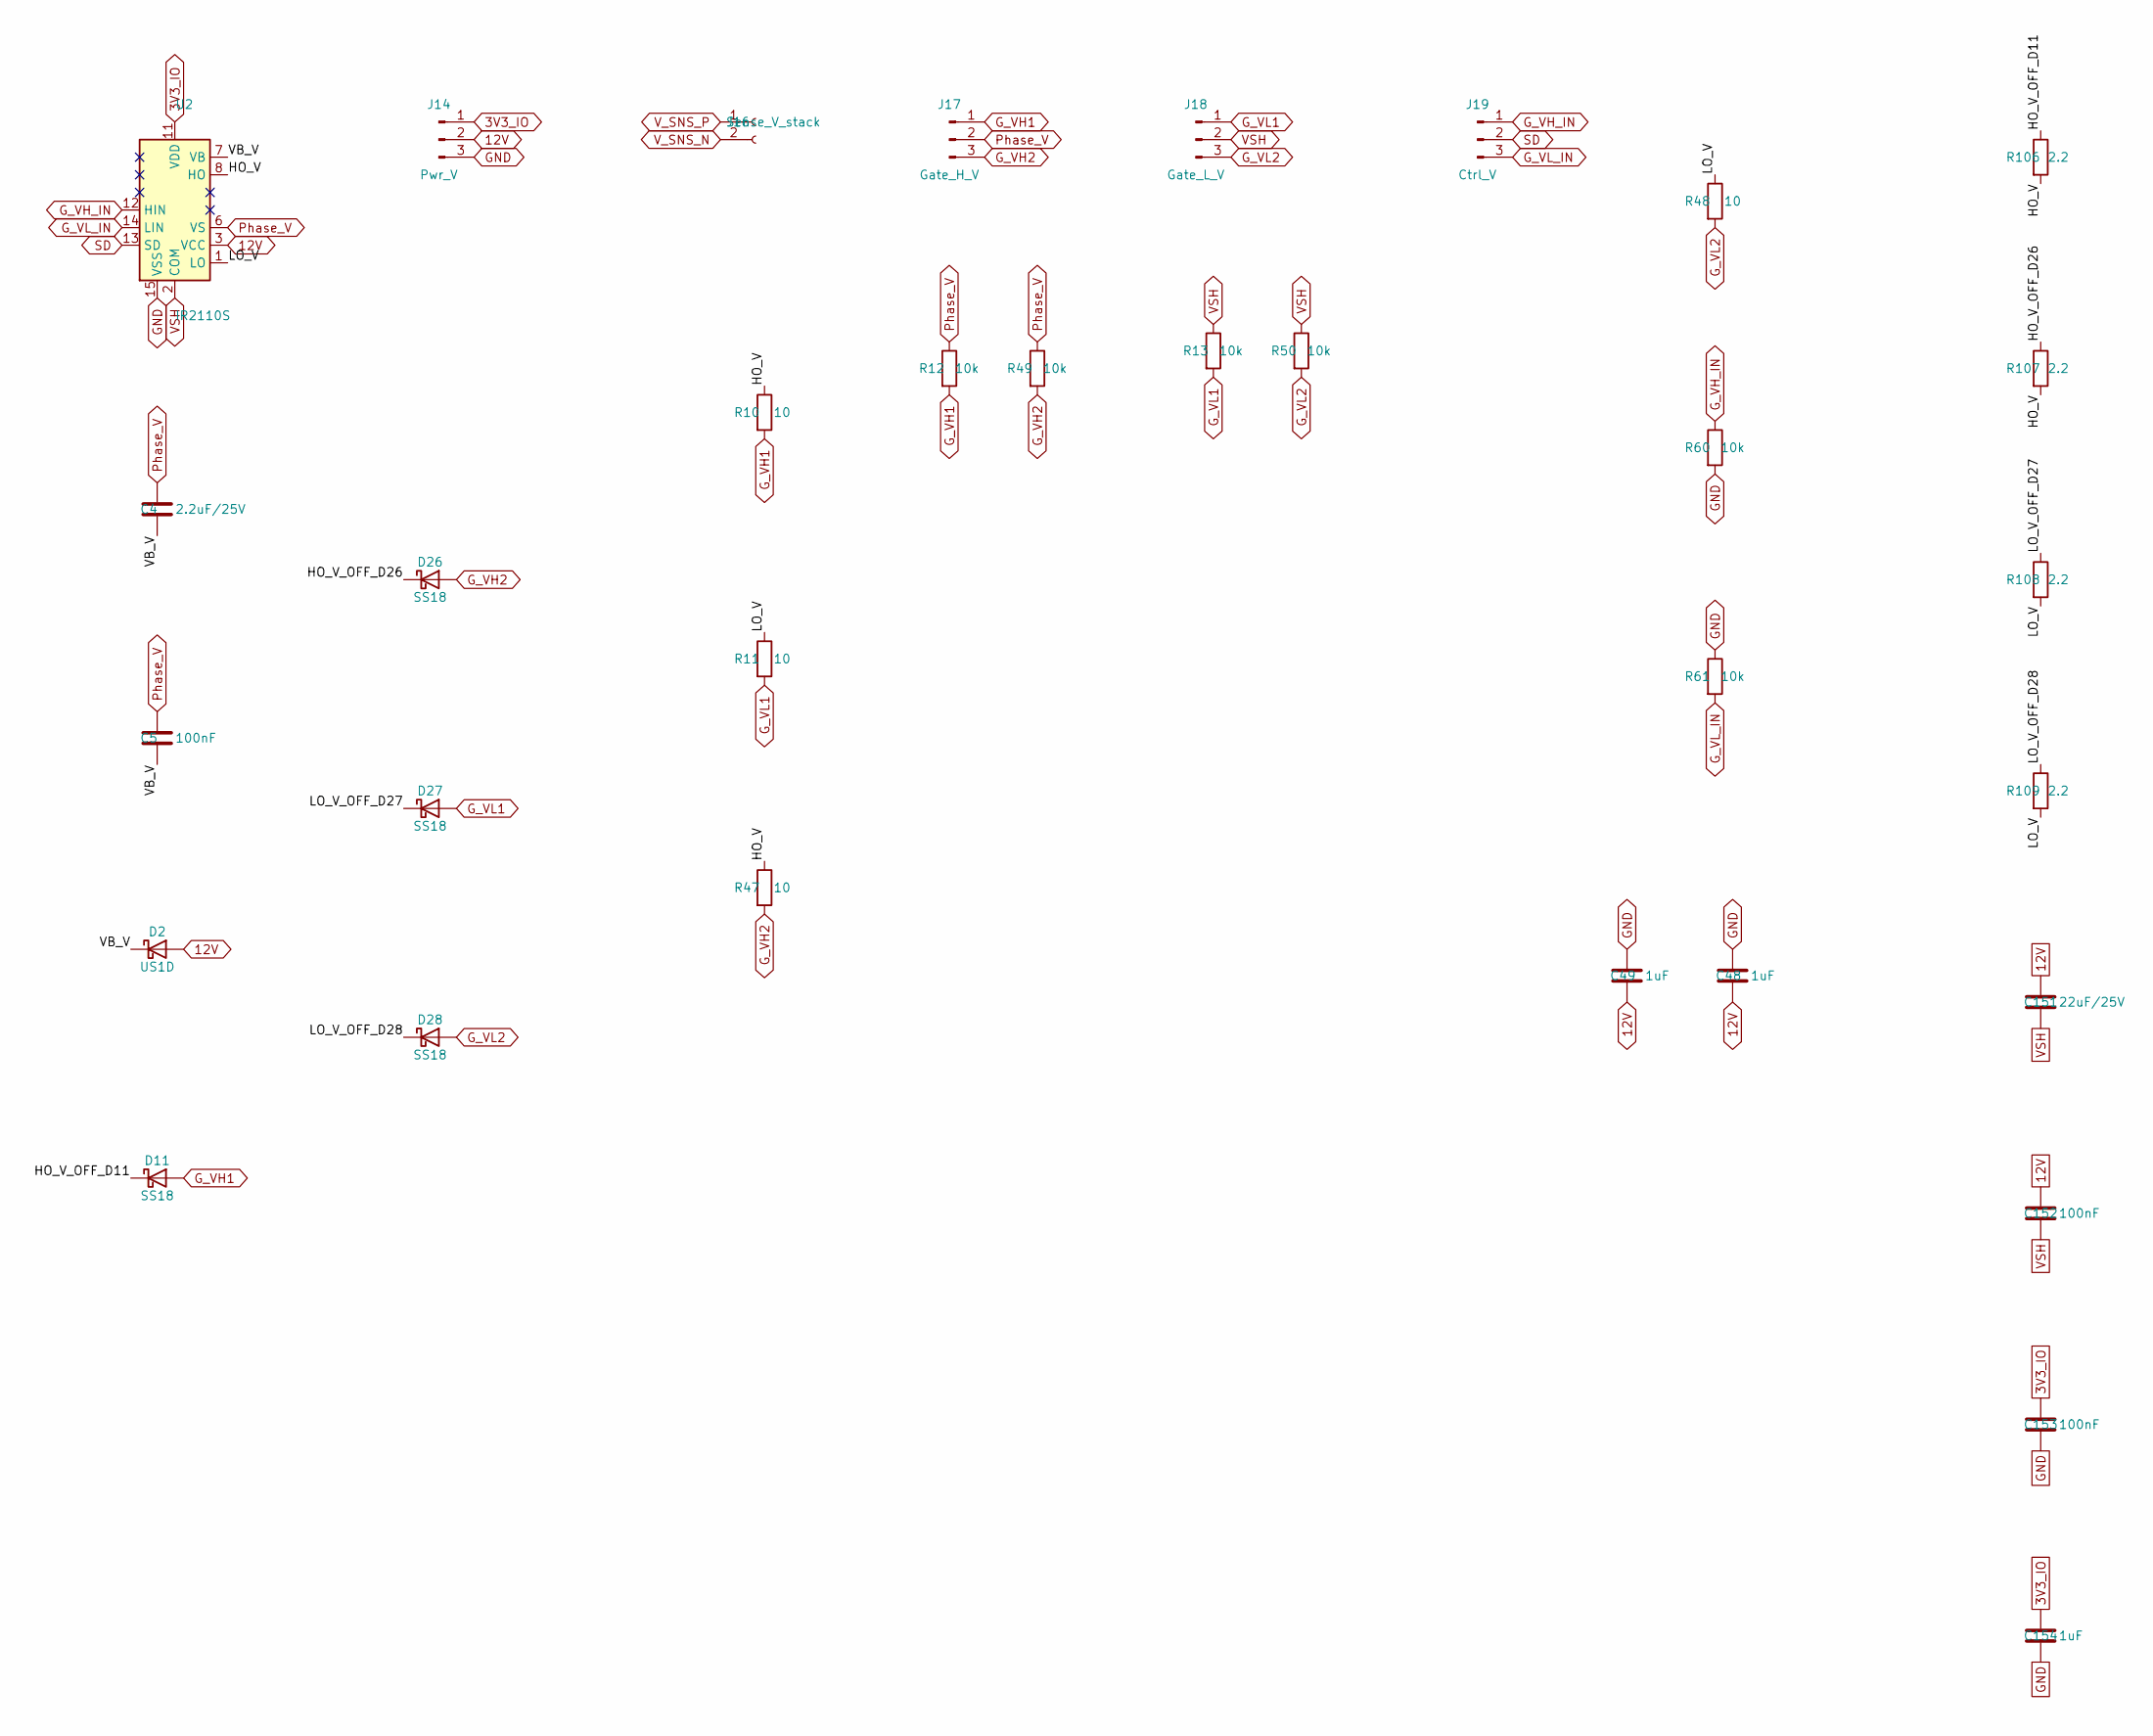
[picture p28: schematic gate_driver_v.kicad_sch]

Parts:
C4: 2.2uF/25V; C_1206_3216Metric; MPN CL31B225KAHNNNE
C5, C152, C153: 100nF; C_0603_1608Metric
C48, C49, C154: 1uF; C_0603_1608Metric
C151: 22uF/25V; C_1206_3216Metric; MPN CL31A226KAHNNNE
D2: US1D; D_SMA; MPN US1D-13-F
D11, D26, D27, D28: SS18; D_SMA
J14: Pwr_V; PinHeader_1x03_P2.54mm_Vertical
J16: Sense_V_stack; PinSocket_1x02_P2.54mm_Vertical
J17: Gate_H_V; PinHeader_1x03_P2.54mm_Vertical
J18: Gate_L_V; PinHeader_1x03_P2.54mm_Vertical
J19: Ctrl_V; PinHeader_1x03_P2.54mm_Vertical
R10, R11, R47, R48: 10; R_0805_2012Metric
R12, R13, R49, R50, R60, R61: 10k; R_0603_1608Metric
R106, R107, R108, R109: 2.2; R_0603_1608Metric
U2: IR2110S; SOIC-16W_7.5x10.3mm_P1.27mm

Connections:
3V3_IO: C153.1, C154.1, J14.1, U2.11 (VDD); also elsewhere on the board
12V: C48.2, C49.2, C151.1, C152.1, D2.2 (A), J14.2, U2.3 (VCC); also elsewhere on the board
/Katman2_GateDriver_V/HO_V: R10.1, R47.1, R106.2, R107.2, U2.8 (HO)
/Katman2_GateDriver_V/HO_V_OFF_D11: D11.1 (K), R106.1
/Katman2_GateDriver_V/HO_V_OFF_D26: D26.1 (K), R107.1
/Katman2_GateDriver_V/LO_V: R11.1, R48.1, R108.2, R109.2, U2.1 (LO)
/Katman2_GateDriver_V/LO_V_OFF_D27: D27.1 (K), R108.1
/Katman2_GateDriver_V/LO_V_OFF_D28: D28.1 (K), R109.1
/Katman2_GateDriver_V/VB_V: C4.2, C5.2, D2.1 (K), U2.7 (VB)
GND: C48.1, C49.1, C153.2, C154.2, J14.3, R60.2, R61.1, U2.15 (VSS); also elsewhere on the board
G_VH1: D11.2 (A), J17.1, R10.2, R12.2; also elsewhere on the board
G_VH2: D26.2 (A), J17.3, R47.2, R49.2; also elsewhere on the board
G_VH_IN: J19.1, R60.1, U2.12 (HIN); also elsewhere on the board
G_VL1: D27.2 (A), J18.1, R11.2, R13.2; also elsewhere on the board
G_VL2: D28.2 (A), J18.3, R48.2, R50.2; also elsewhere on the board
G_VL_IN: J19.3, R61.2, U2.14 (LIN); also elsewhere on the board
Phase_V: C4.1, C5.1, J17.2, R12.1, R49.1, U2.6 (VS); also elsewhere on the board
SD: J19.2, U2.13 (SD); also elsewhere on the board
VSH: C151.2, C152.2, J18.2, R13.1, R50.1, U2.2 (COM); also elsewhere on the board
V_SNS_N: J16.2; also elsewhere on the board
V_SNS_P: J16.1; also elsewhere on the board

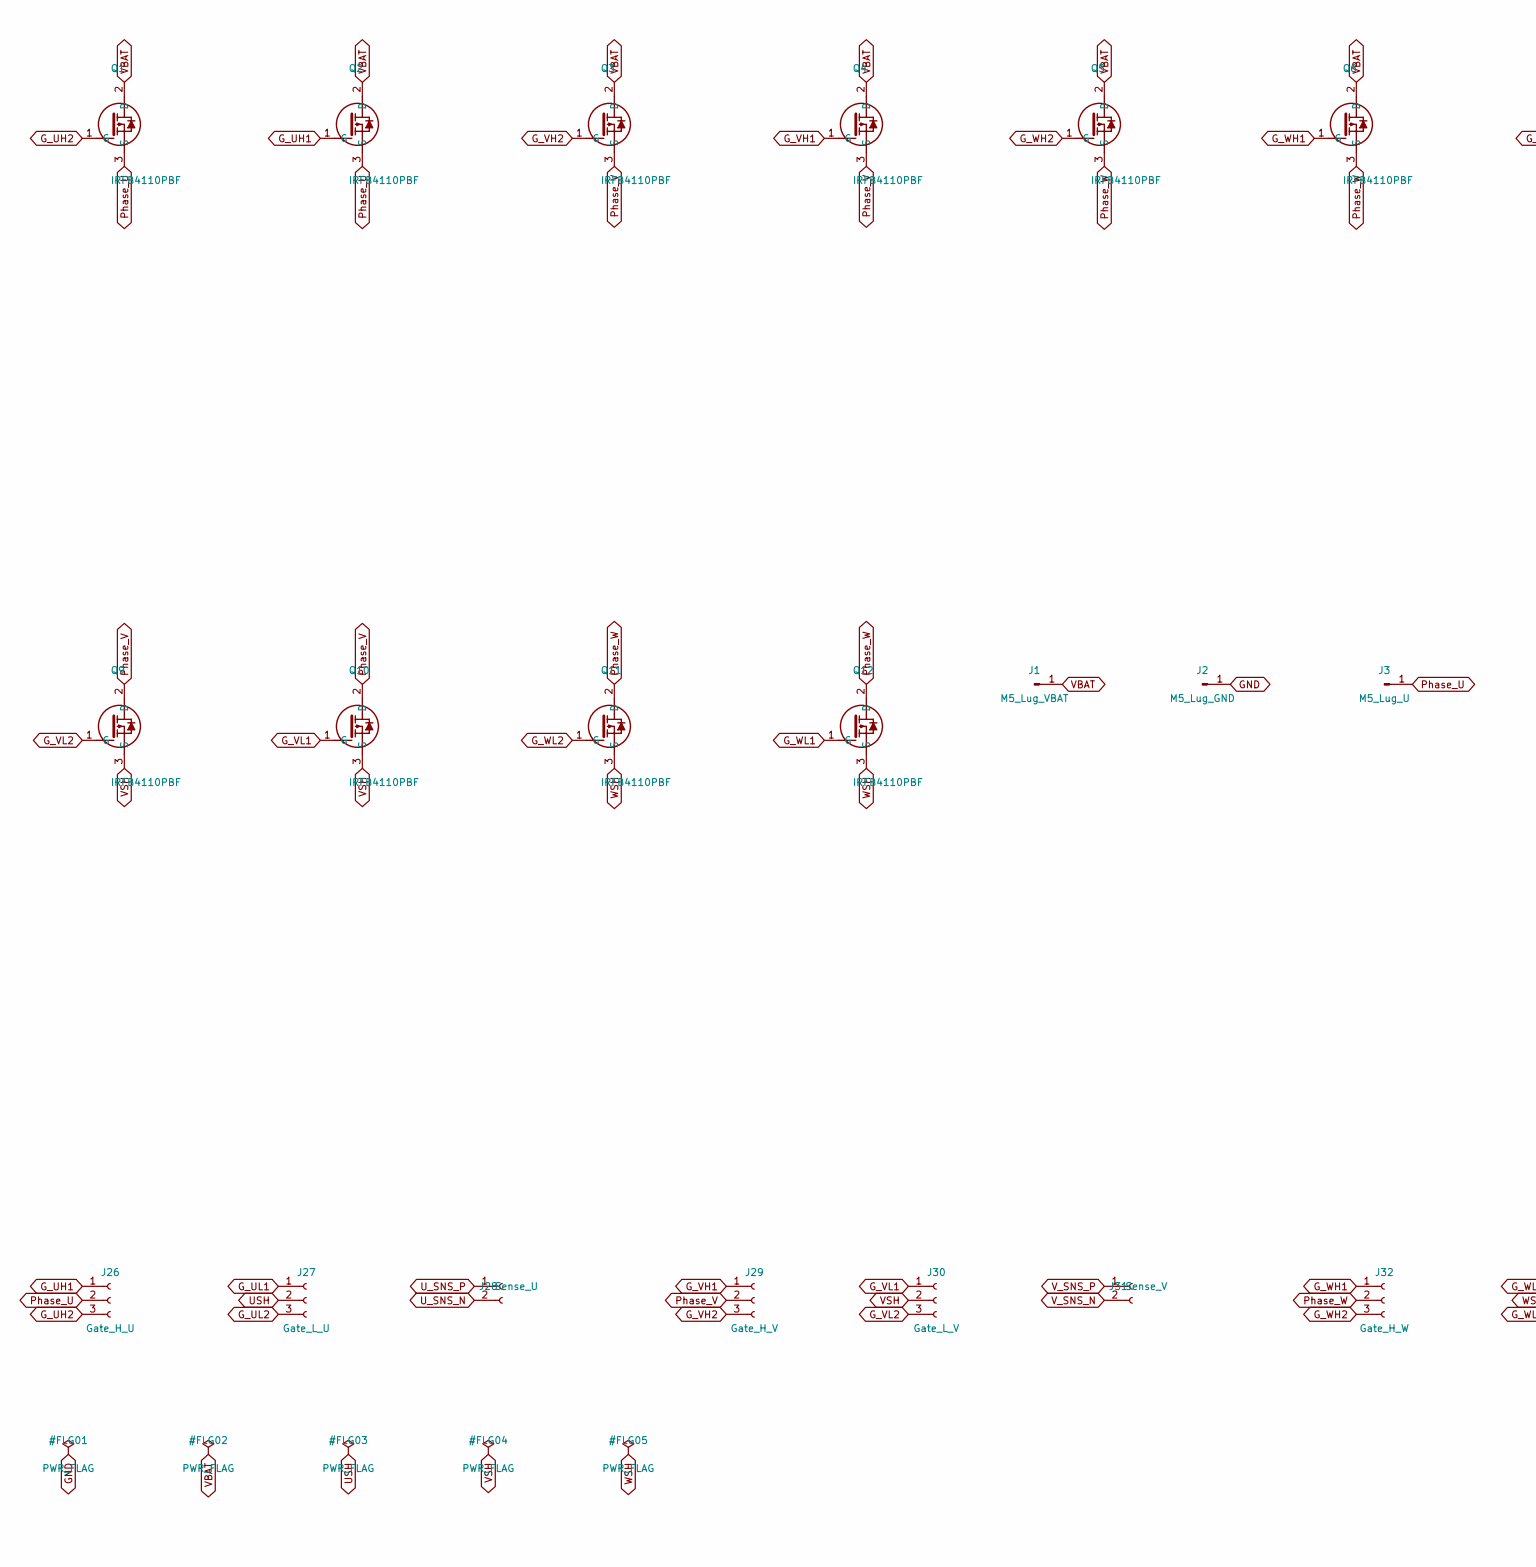
[picture p29: schematic guc_karti.kicad_sch, part in row 1, column 1]

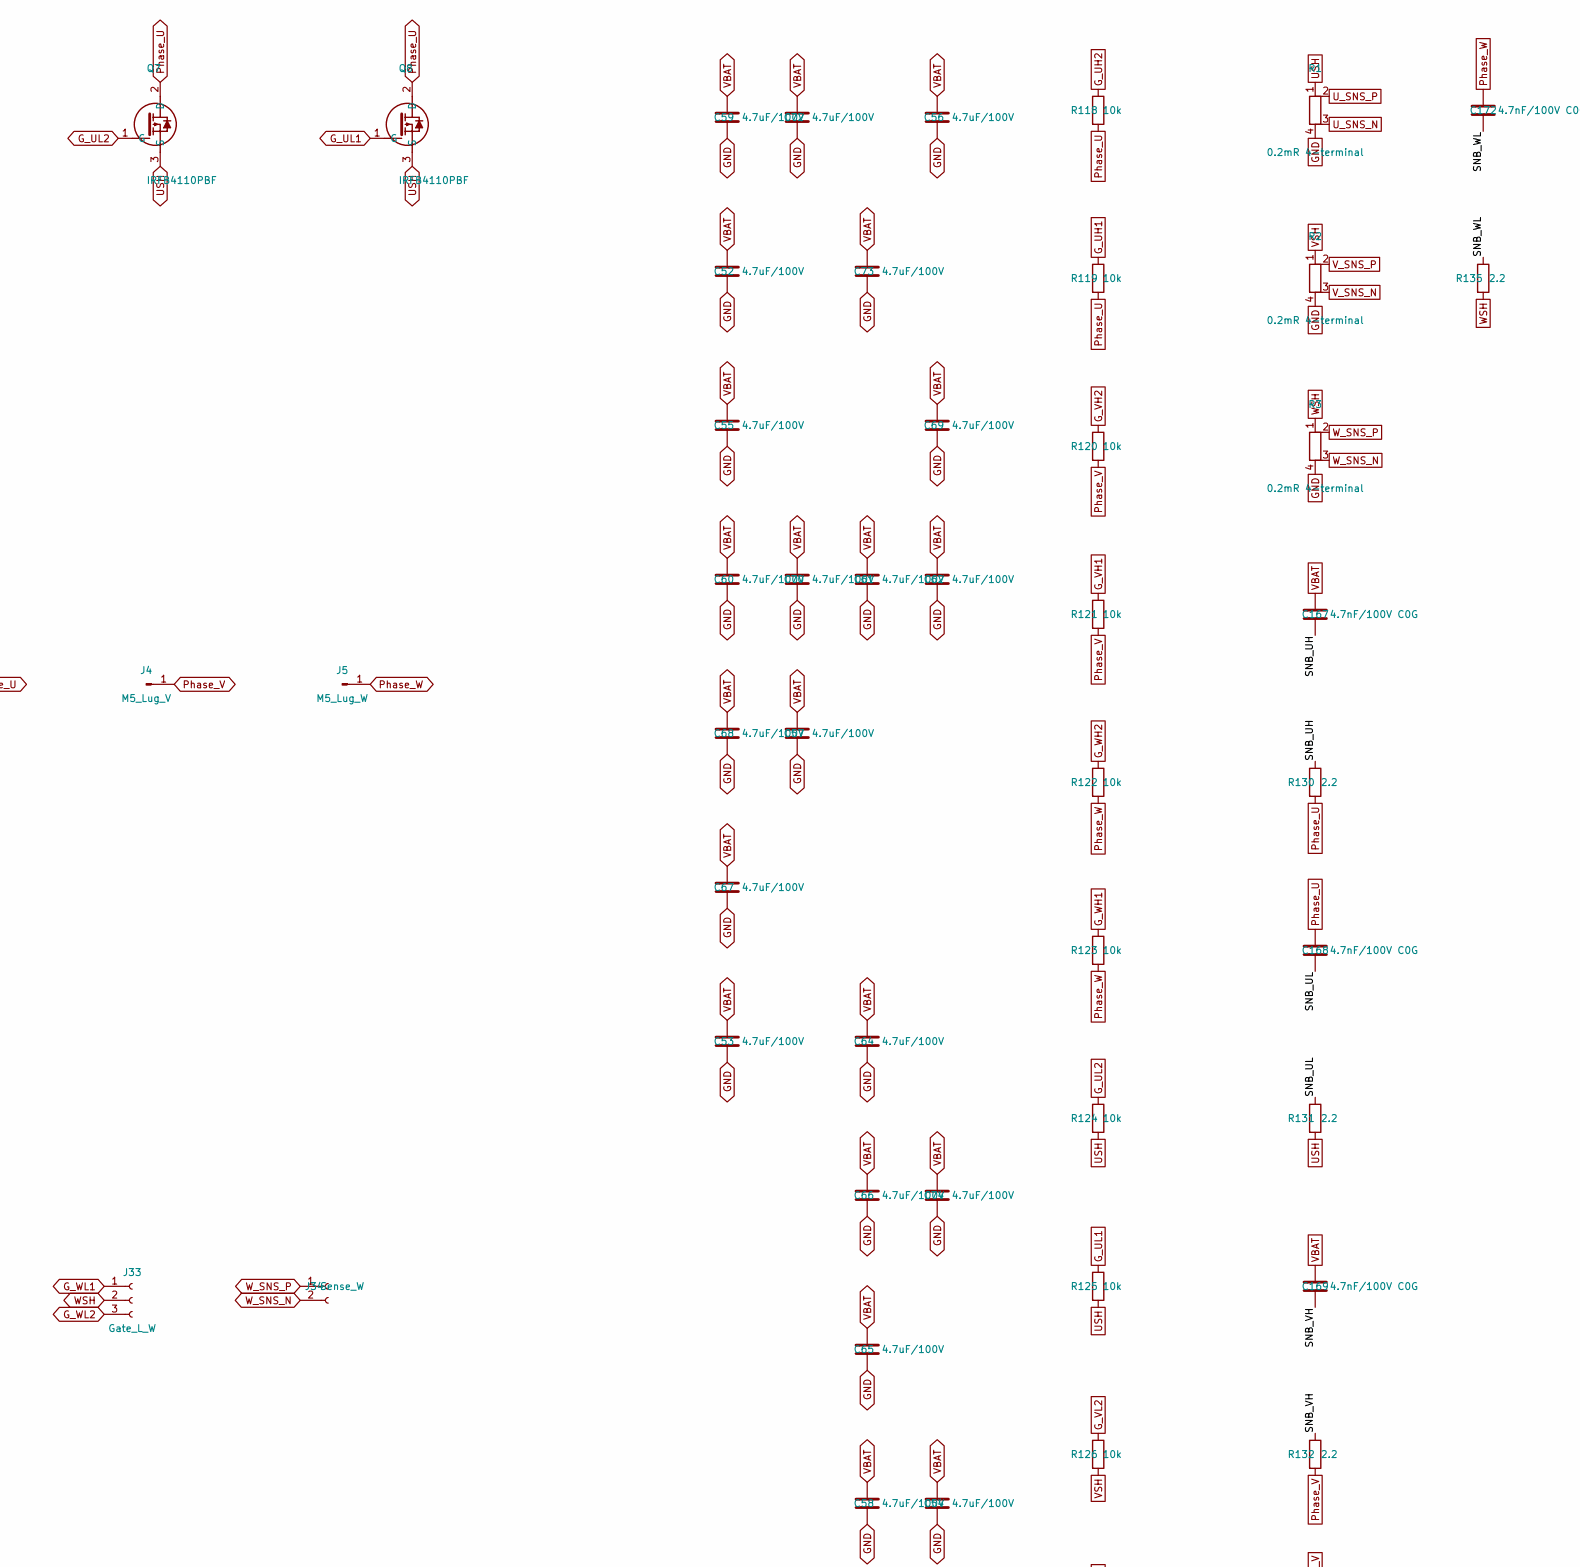
[picture p30: schematic guc_karti.kicad_sch, part in row 1, column 2]

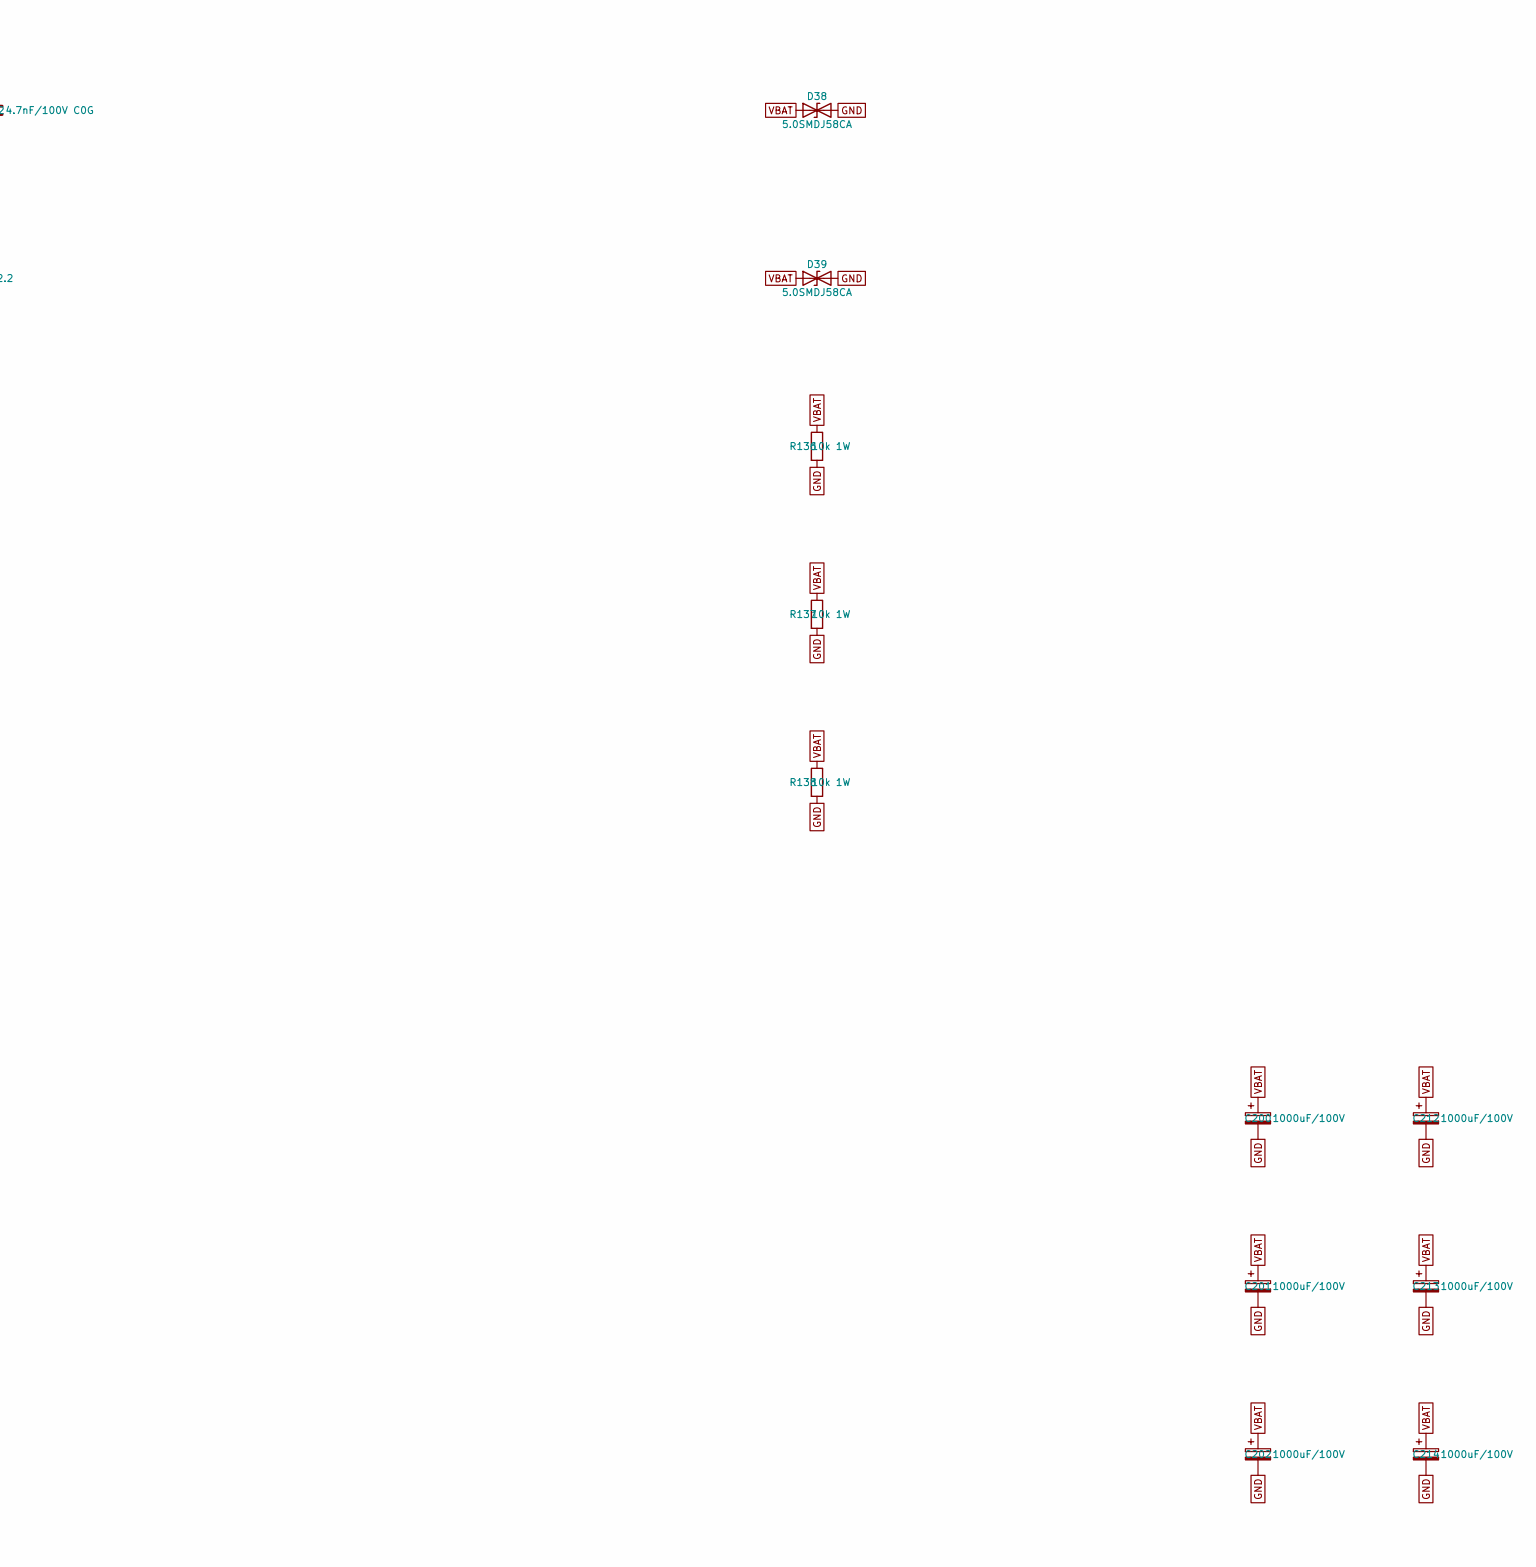
[picture p31: schematic guc_karti.kicad_sch, part in row 1, column 3]

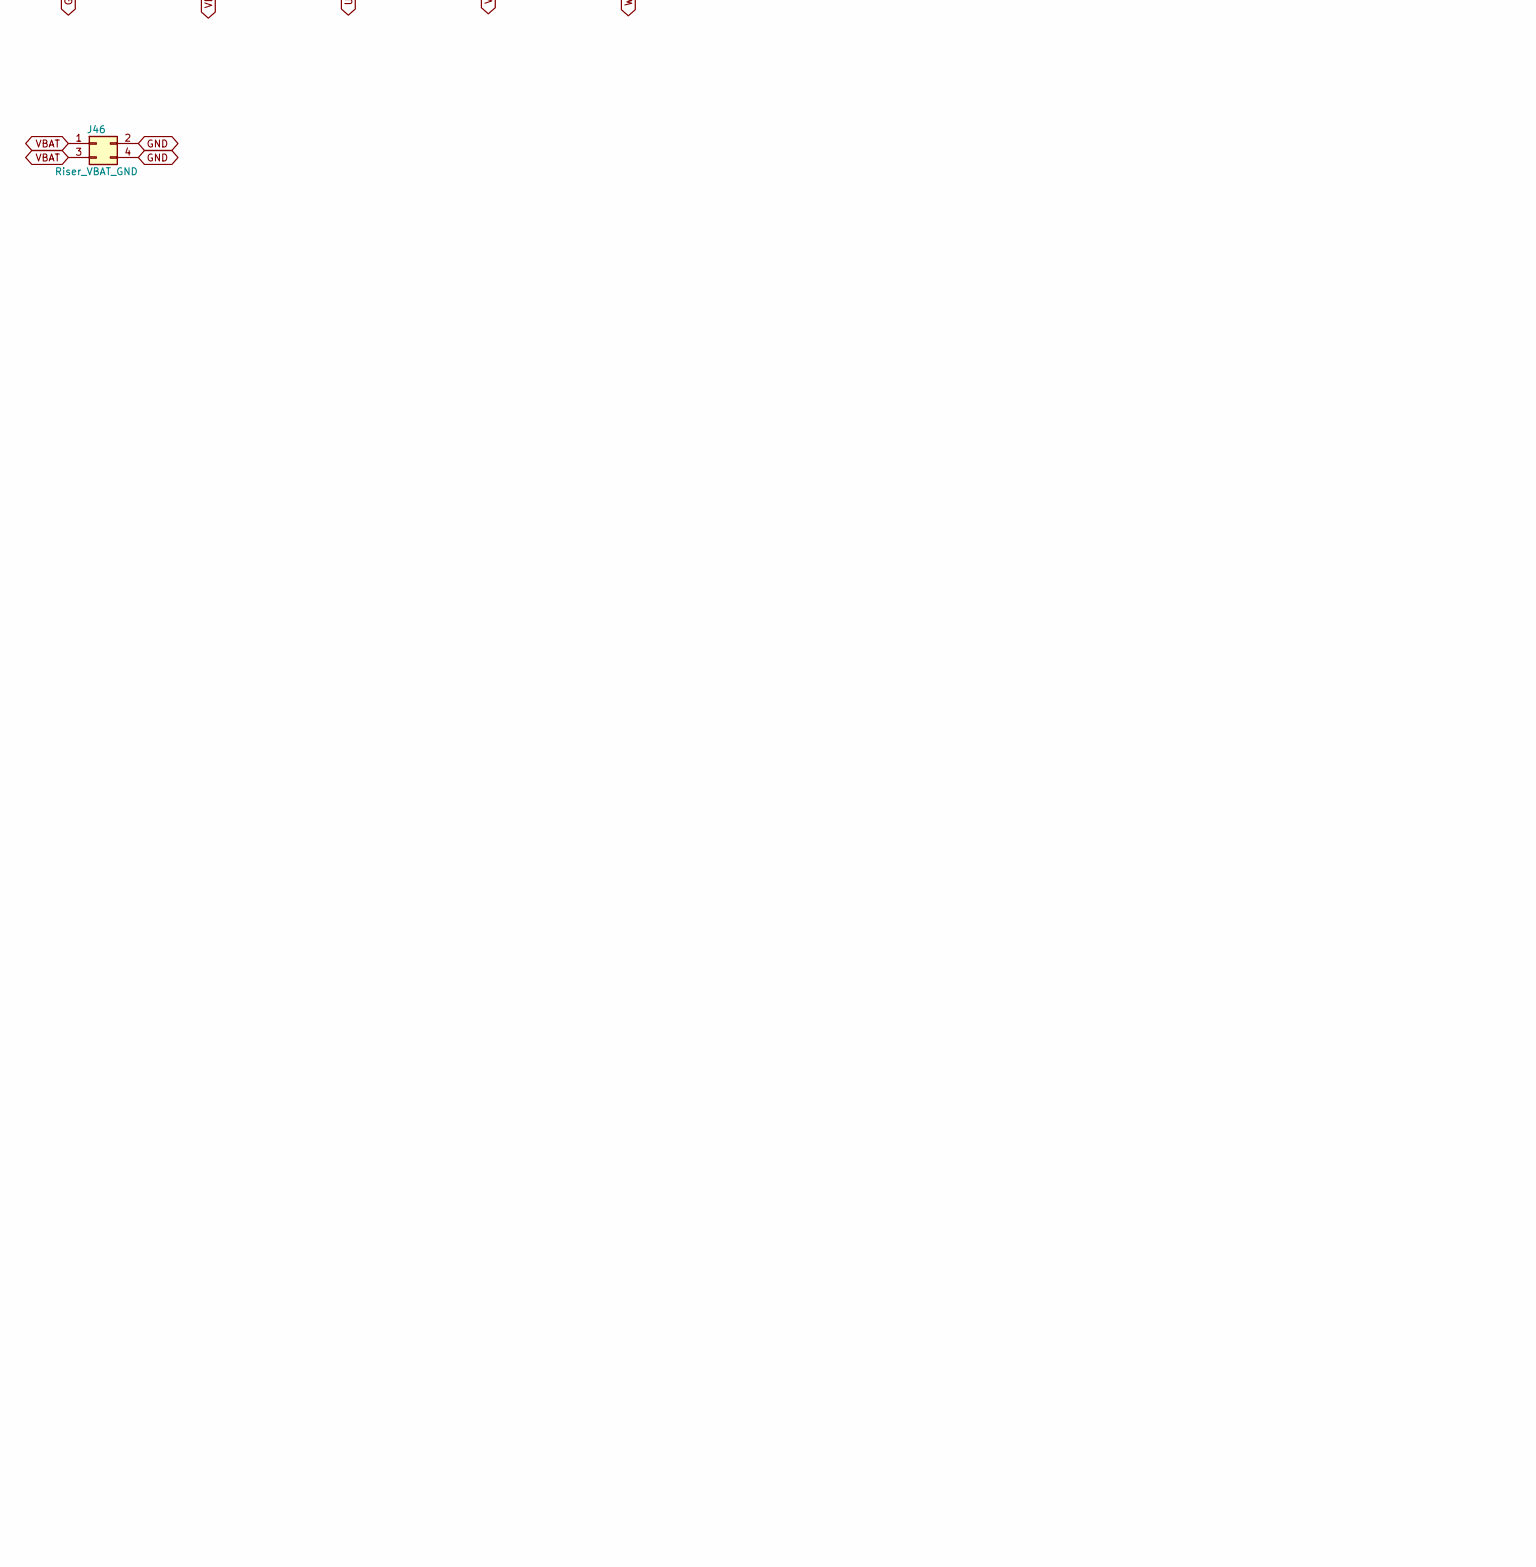
[picture p32: schematic guc_karti.kicad_sch, part in row 2, column 1]

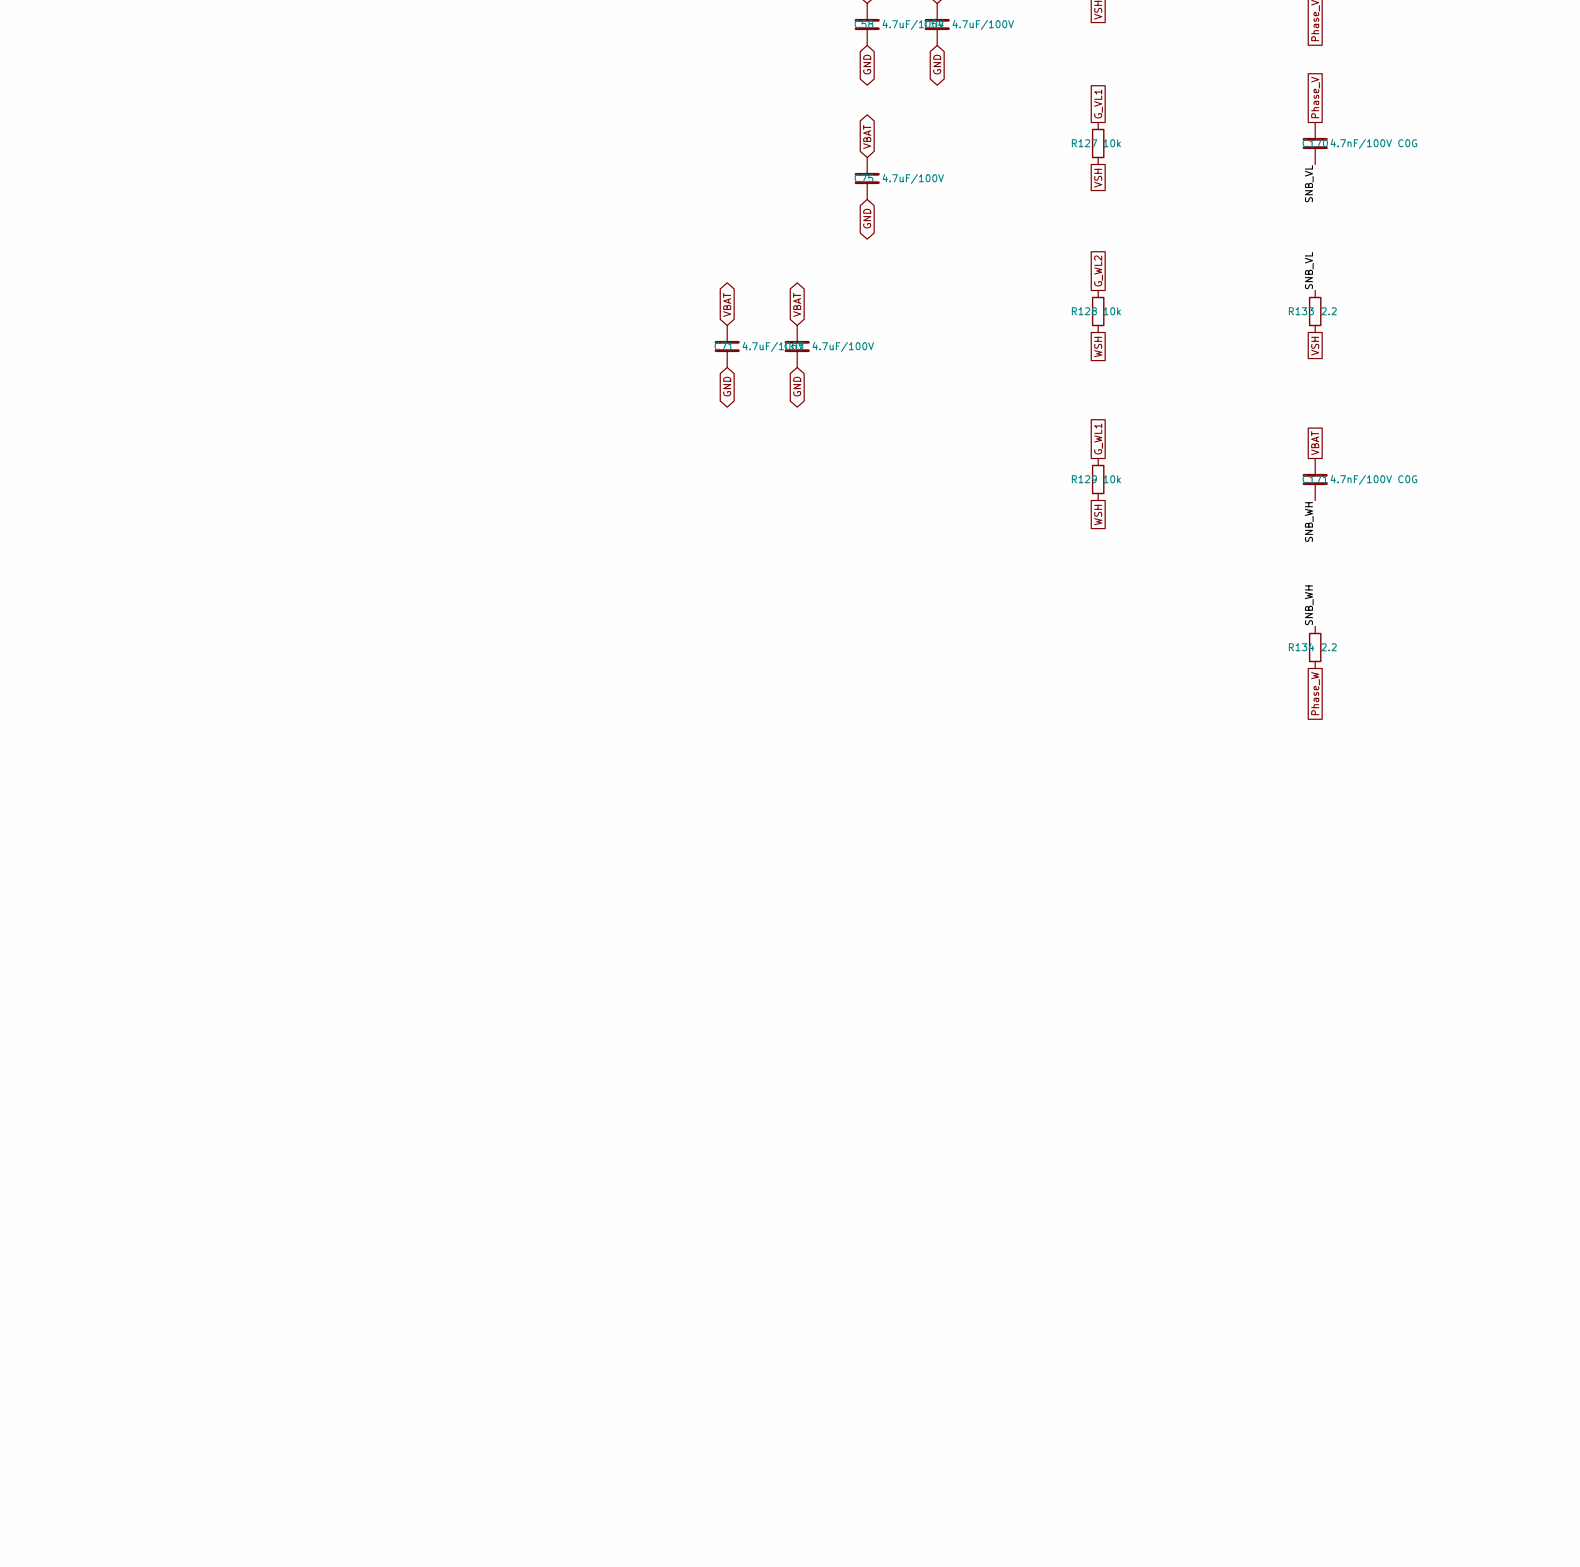
[picture p33: schematic guc_karti.kicad_sch, part in row 2, column 2]

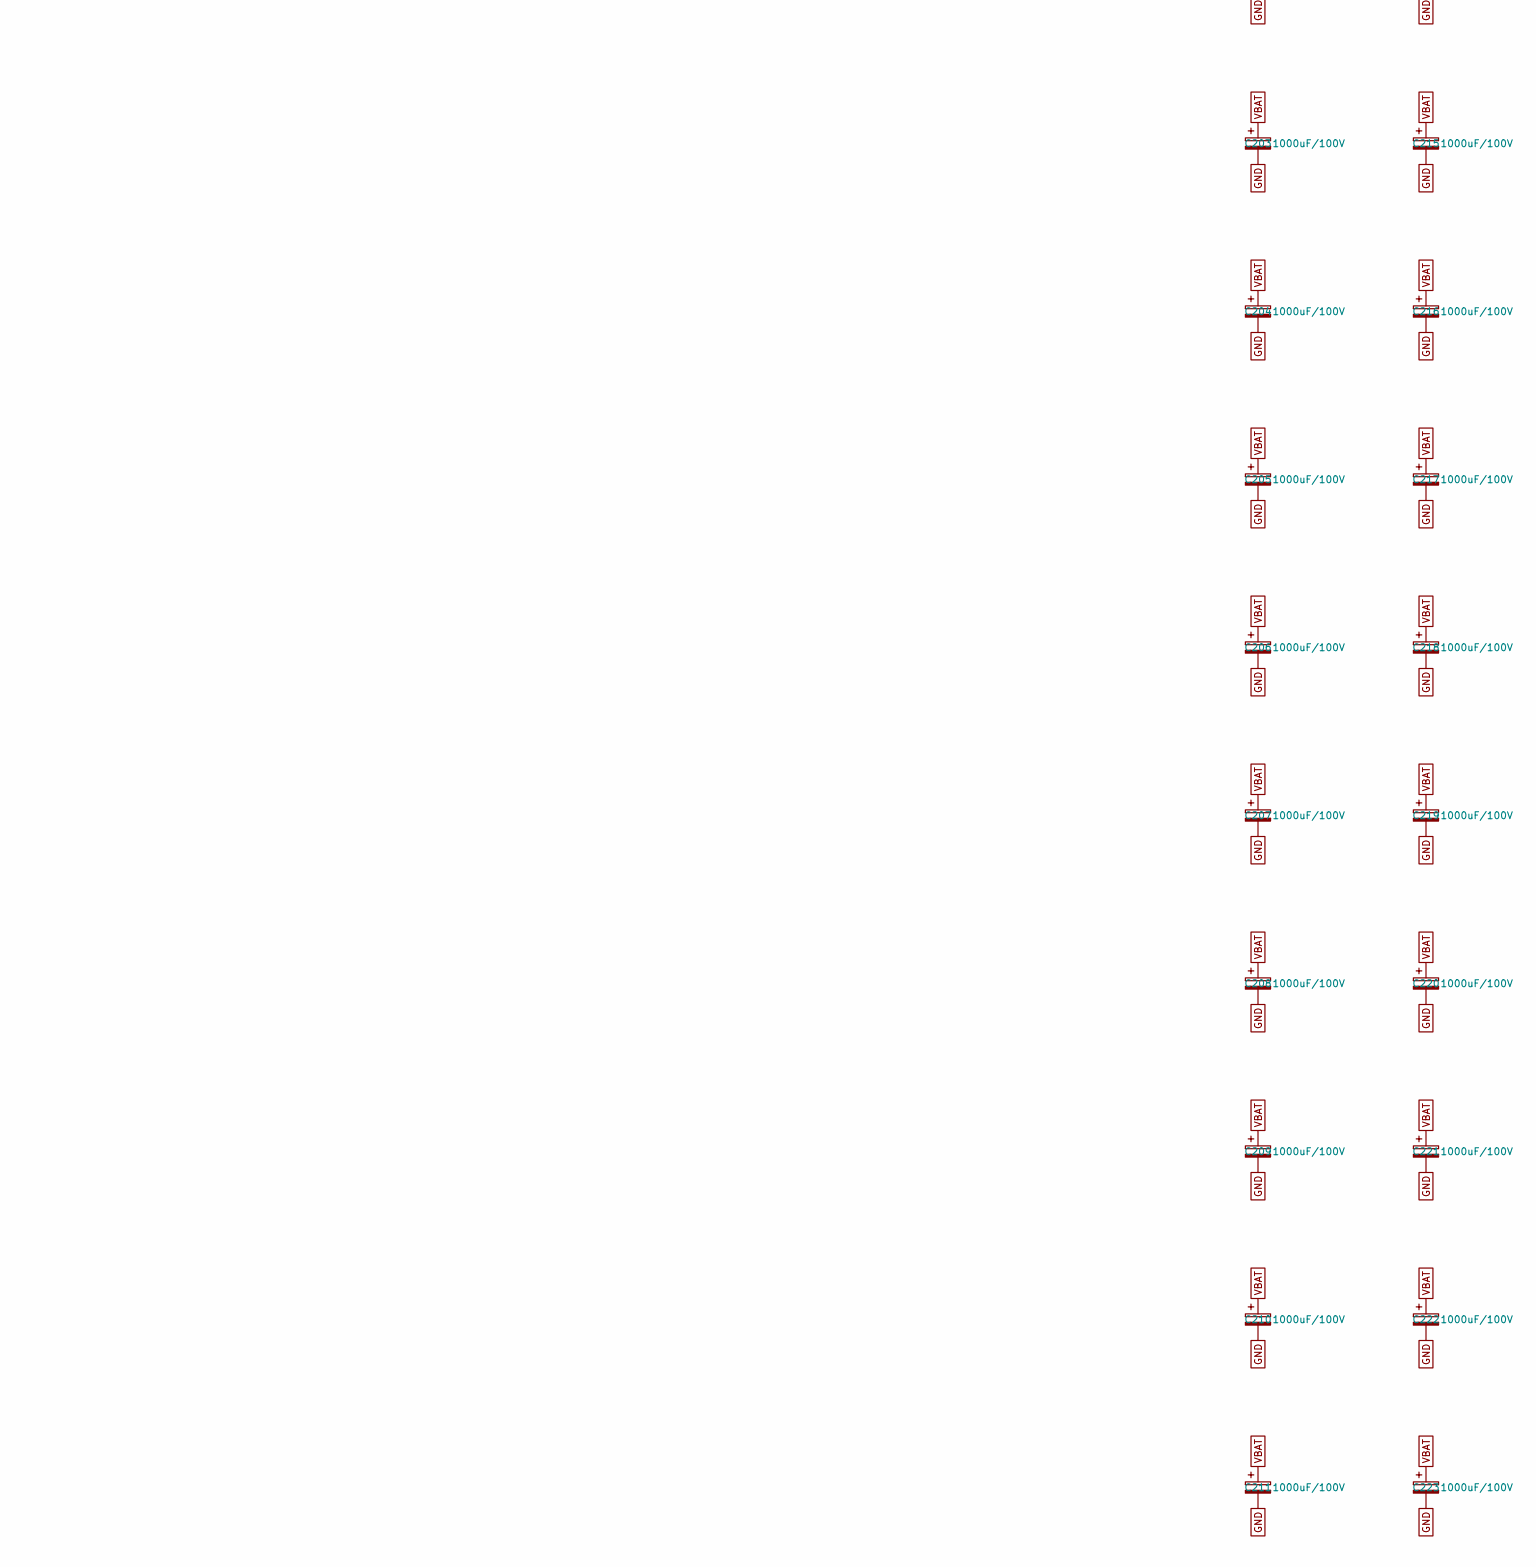
[picture p34: schematic guc_karti.kicad_sch, part in row 2, column 3]

Parts:
C52, C53, C54, C55, C56, C57, C58, C59, C60, C61, C62, C63, C64, C65, C66, C67, C68, C69, C70, C71, C72, C73, C74, C75: 4.7uF/100V; C_1210_3225Metric; MPN GRM32ER72A475KA12L
C167, C168, C169, C170, C171, C172: 4.7nF/100V C0G; C_1206_3216Metric
C200, C201, C202, C203, C204, C205, C206, C207, C208, C209, C210, C211, C212, C213, C214, C215, C216, C217, C218, C219, C220, C221, C222, C223: 1000uF/100V; CP_Radial_D18.0mm_L40mm_P7.50mm_KOSHIN_KLH; MPN PKLH-100V102MK400
D38, D39: 5.0SMDJ58CA; D_SMC; MPN 5.0SMDJ58CA (Littelfuse, 5 kW)
J1: M5_Lug_VBAT; MountingHole_5.3mm_M5_Pad_Via
J2: M5_Lug_GND; MountingHole_5.3mm_M5_Pad_Via
J3: M5_Lug_U; MountingHole_5.3mm_M5_Pad_Via
J4: M5_Lug_V; MountingHole_5.3mm_M5_Pad_Via
J5: M5_Lug_W; MountingHole_5.3mm_M5_Pad_Via
J26: Gate_H_U; PinSocket_1x03_P2.54mm_Vertical
J27: Gate_L_U; PinSocket_1x03_P2.54mm_Vertical
J28: Sense_U; PinSocket_1x02_P2.54mm_Vertical
J29: Gate_H_V; PinSocket_1x03_P2.54mm_Vertical
J30: Gate_L_V; PinSocket_1x03_P2.54mm_Vertical
J31: Sense_V; PinSocket_1x02_P2.54mm_Vertical
J32: Gate_H_W; PinSocket_1x03_P2.54mm_Vertical
J33: Gate_L_W; PinSocket_1x03_P2.54mm_Vertical
J34: Sense_W; PinSocket_1x02_P2.54mm_Vertical
J46: Riser_VBAT_GND; PinSocket_2x02_P2.54mm_Vertical
Q1, Q2, Q3, Q4, Q5, Q6, Q7, Q8, Q9, Q10, Q11, Q12: IRFB4110PBF; TO-220-3_Horizontal_TabUp_NoHole
R1, R2, R3: 0.2mR 4-terminal; R_Shunt_Isabellenhuette_BVR4026; MPN BVR-Z-R0002-1.0 (Isabellenhuette, 4026,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
R118, R119, R120, R121, R122, R123, R124, R125, R126, R127, R128, R129: 10k; R_0805_2012Metric
R130, R132, R134: 2.2; R_2010_5025Metric
R131, R133, R135: 2.2; R_1210_3225Metric
R136, R137, R138: 10k 1W; R_2512_6332Metric

Connections:
/Katman1_Guc_Karti/SNB_UH: C167.2, R130.1
/Katman1_Guc_Karti/SNB_UL: C168.2, R131.1
/Katman1_Guc_Karti/SNB_VH: C169.2, R132.1
/Katman1_Guc_Karti/SNB_VL: C170.2, R133.1
/Katman1_Guc_Karti/SNB_WH: C171.2, R134.1
/Katman1_Guc_Karti/SNB_WL: C172.2, R135.1
GND: C52.2, C53.2, C54.2, C55.2, C56.2, C57.2, C58.2, C59.2, C60.2, C61.2, C62.2, C63.2, C64.2, C65.2, C66.2, C67.2, C68.2, C69.2, C70.2, C71.2, C72.2, C73.2, C74.2, C75.2, C200.2, C201.2, C202.2, C203.2, C204.2, C205.2, C206.2, C207.2, C208.2, C209.2, C210.2, C211.2, C212.2, C213.2, C214.2, C215.2, C216.2, C217.2, C218.2, C219.2, C220.2, C221.2, C222.2, C223.2, D38.2 (A2), D39.2 (A2), J2.1 (Pin_1_1), J46.2, J46.4, R1.4, R2.4, R3.4, R136.2, R137.2, R138.2; also elsewhere on the board
G_UH1: J26.1, Q2.1 (G), R119.1; also elsewhere on the board
G_UH2: J26.3, Q1.1 (G), R118.1; also elsewhere on the board
G_UL1: J27.1, Q8.1 (G), R125.1; also elsewhere on the board
G_UL2: J27.3, Q7.1 (G), R124.1; also elsewhere on the board
G_VH1: J29.1, Q4.1 (G), R121.1; also elsewhere on the board
G_VH2: J29.3, Q3.1 (G), R120.1; also elsewhere on the board
G_VL1: J30.1, Q10.1 (G), R127.1; also elsewhere on the board
G_VL2: J30.3, Q9.1 (G), R126.1; also elsewhere on the board
G_WH1: J32.1, Q6.1 (G), R123.1; also elsewhere on the board
G_WH2: J32.3, Q5.1 (G), R122.1; also elsewhere on the board
G_WL1: J33.1, Q12.1 (G), R129.1; also elsewhere on the board
G_WL2: J33.3, Q11.1 (G), R128.1; also elsewhere on the board
Phase_U: C168.1, J3.1 (Pin_1_1), J26.2, Q1.3 (S), Q2.3 (S), Q7.2 (D), Q8.2 (D), R118.2, R119.2, R130.2; also elsewhere on the board
Phase_V: C170.1, J4.1 (Pin_1_1), J29.2, Q3.3 (S), Q4.3 (S), Q9.2 (D), Q10.2 (D), R120.2, R121.2, R132.2; also elsewhere on the board
Phase_W: C172.1, J5.1 (Pin_1_1), J32.2, Q5.3 (S), Q6.3 (S), Q11.2 (D), Q12.2 (D), R122.2, R123.2, R134.2; also elsewhere on the board
USH: J27.2, Q7.3 (S), Q8.3 (S), R1.1, R124.2, R125.2, R131.2; also elsewhere on the board
U_SNS_N: J28.2, R1.3; also elsewhere on the board
U_SNS_P: J28.1, R1.2; also elsewhere on the board
VBAT: C52.1, C53.1, C54.1, C55.1, C56.1, C57.1, C58.1, C59.1, C60.1, C61.1, C62.1, C63.1, C64.1, C65.1, C66.1, C67.1, C68.1, C69.1, C70.1, C71.1, C72.1, C73.1, C74.1, C75.1, C167.1, C169.1, C171.1, C200.1, C201.1, C202.1, C203.1, C204.1, C205.1, C206.1, C207.1, C208.1, C209.1, C210.1, C211.1, C212.1, C213.1, C214.1, C215.1, C216.1, C217.1, C218.1, C219.1, C220.1, C221.1, C222.1, C223.1, D38.1 (A1), D39.1 (A1), J1.1 (Pin_1_1), J46.1, J46.3, Q1.2 (D), Q2.2 (D), Q3.2 (D), Q4.2 (D), Q5.2 (D), Q6.2 (D), R136.1, R137.1, R138.1; also elsewhere on the board
VSH: J30.2, Q9.3 (S), Q10.3 (S), R2.1, R126.2, R127.2, R133.2; also elsewhere on the board
V_SNS_N: J31.2, R2.3; also elsewhere on the board
V_SNS_P: J31.1, R2.2; also elsewhere on the board
WSH: J33.2, Q11.3 (S), Q12.3 (S), R3.1, R128.2, R129.2, R135.2; also elsewhere on the board
W_SNS_N: J34.2, R3.3; also elsewhere on the board
W_SNS_P: J34.1, R3.2; also elsewhere on the board
