tekcanyilmaz42-gif/bldc_driver/yedek_faz7/pre_inceleme3/bldc_driver_ai.kicad_pcb

## KiCad design yedek_faz7/pre_inceleme3/bldc_driver_ai.kicad_pcb (continued)

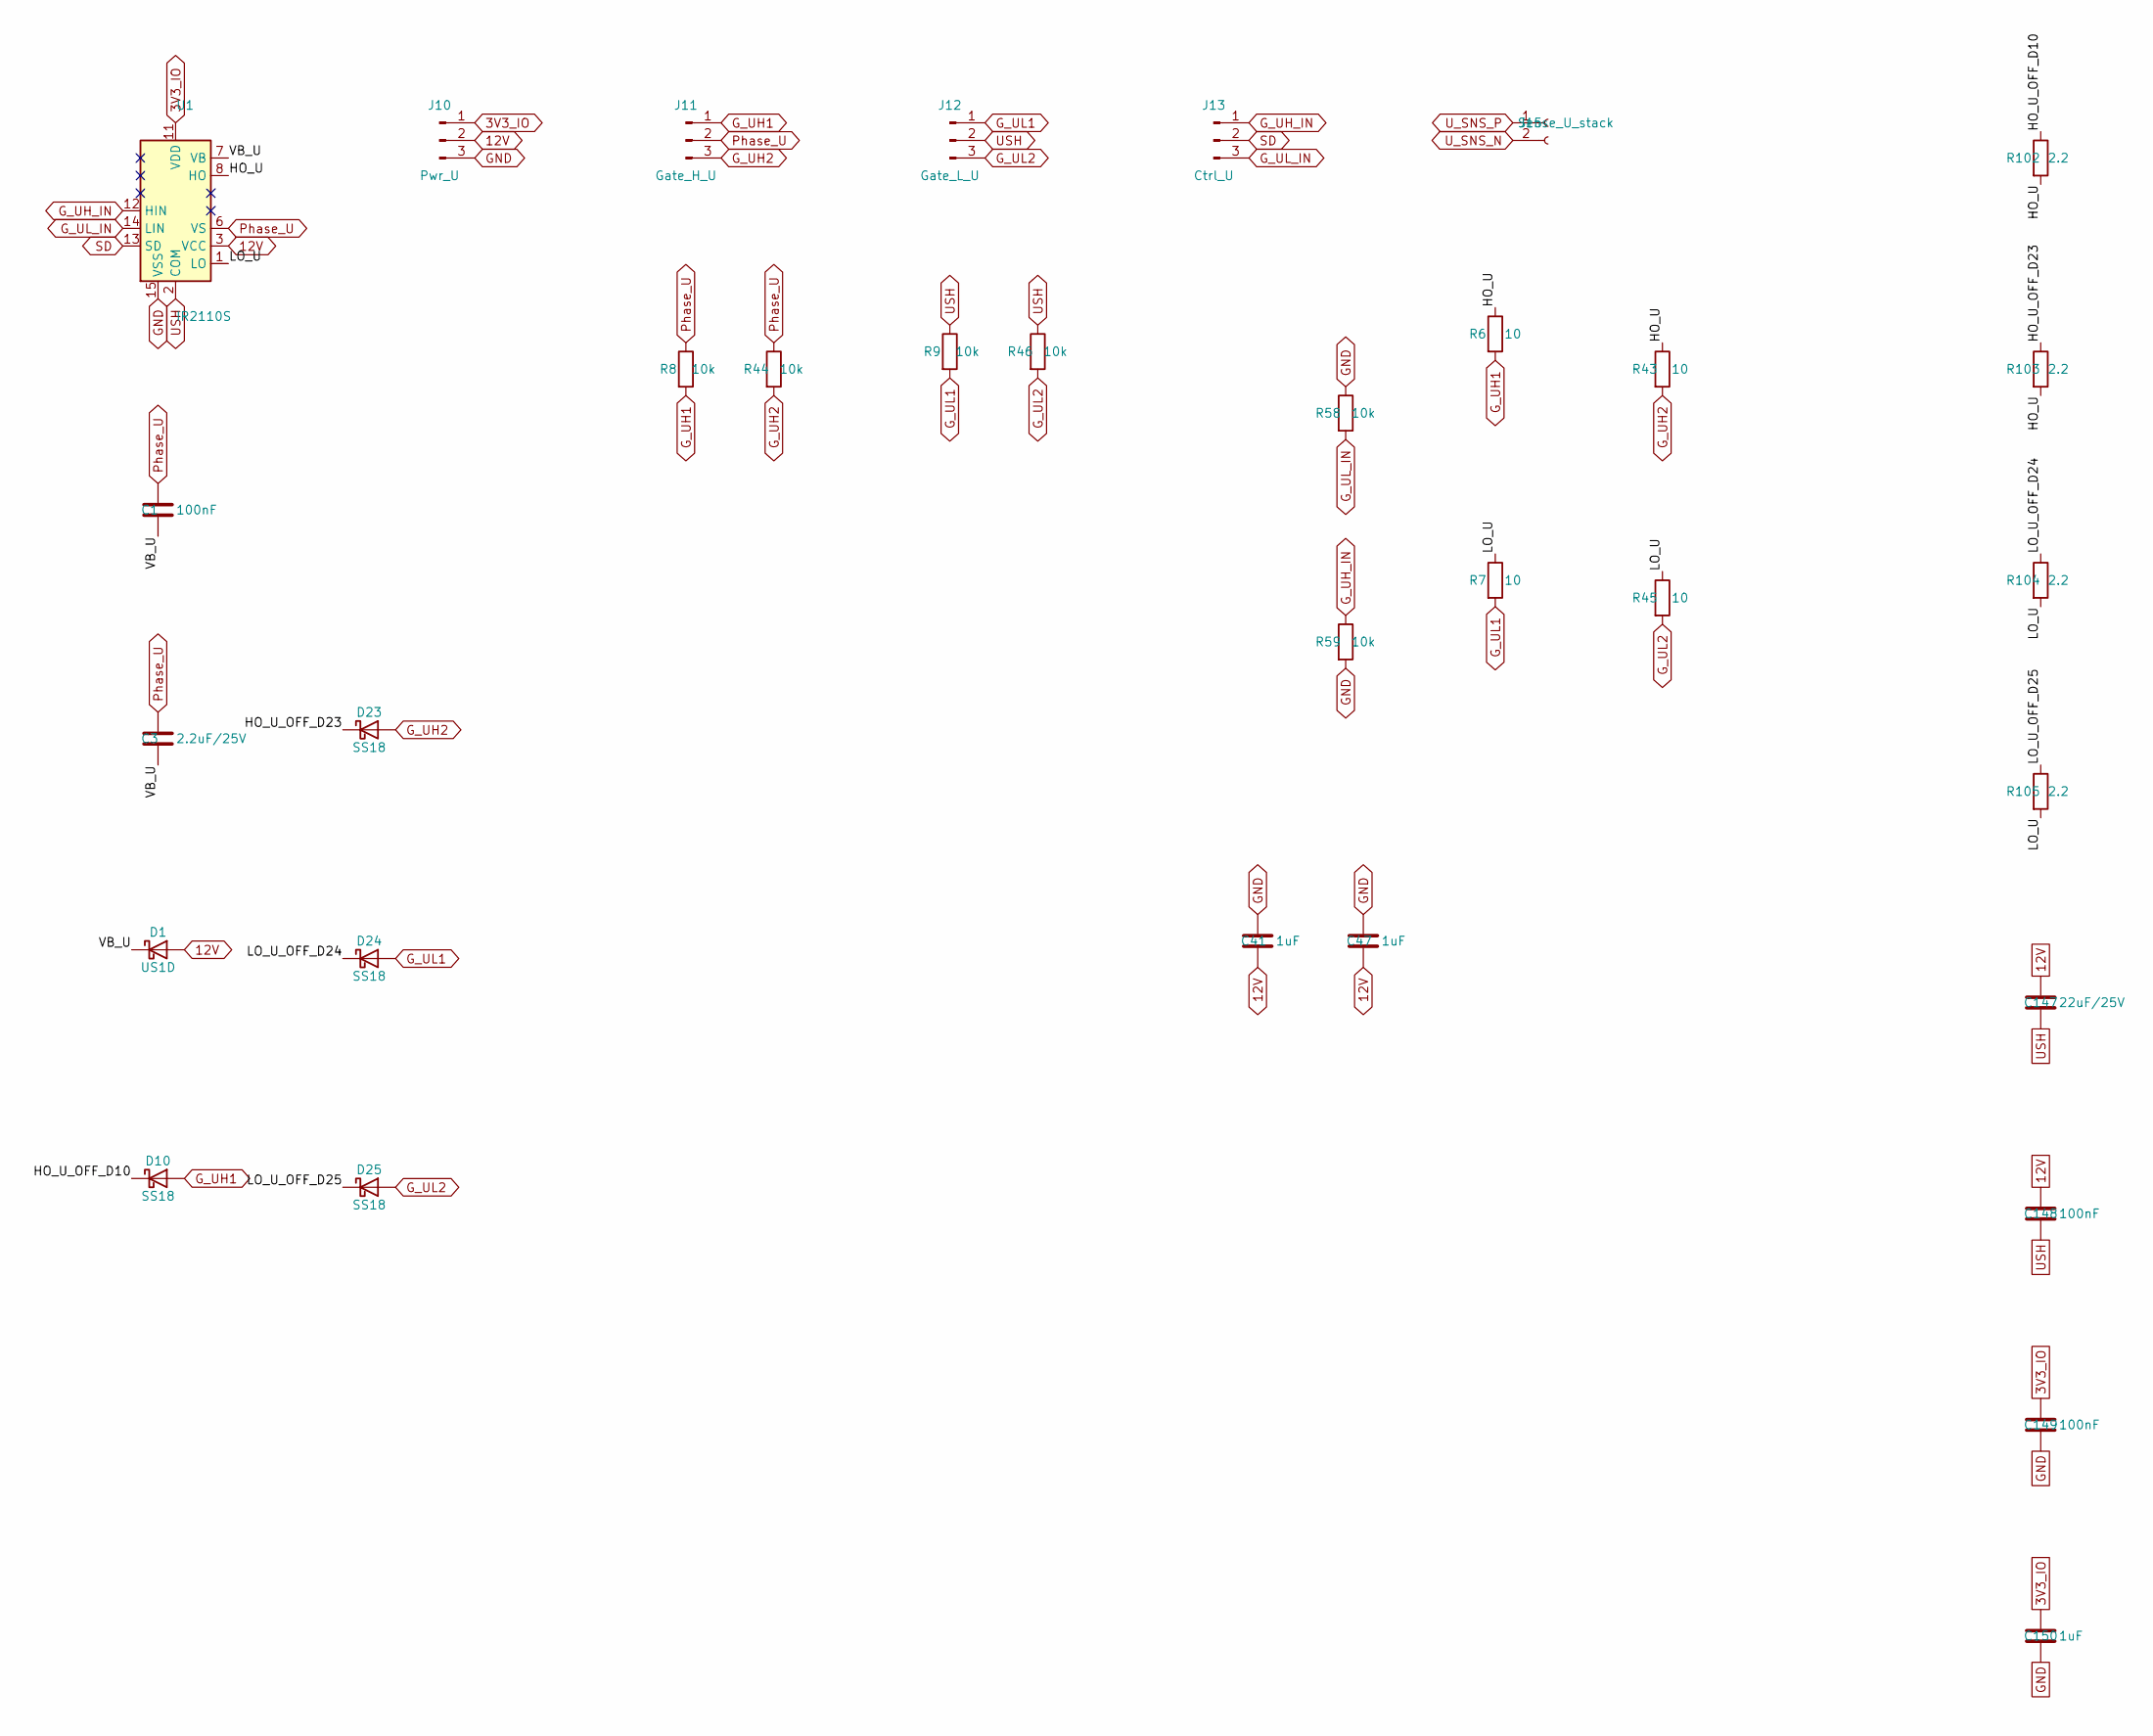
[picture p35: schematic gate_driver_u.kicad_sch]

Parts:
C1, C148, C149: 100nF; C_0603_1608Metric
C3: 2.2uF/25V; C_1206_3216Metric; MPN CL31B225KAHNNNE
C41, C47, C150: 1uF; C_0603_1608Metric
C147: 22uF/25V; C_1206_3216Metric; MPN CL31A226KAHNNNE
D1: US1D; D_SMA; MPN US1D-13-F
D10, D23, D24, D25: SS18; D_SMA
J10: Pwr_U; PinHeader_1x03_P2.54mm_Vertical
J11: Gate_H_U; PinHeader_1x03_P2.54mm_Vertical
J12: Gate_L_U; PinHeader_1x03_P2.54mm_Vertical
J13: Ctrl_U; PinHeader_1x03_P2.54mm_Vertical
J15: Sense_U_stack; PinSocket_1x02_P2.54mm_Vertical
R6, R7, R43, R45: 10; R_0805_2012Metric
R8, R9, R44, R46, R58, R59: 10k; R_0603_1608Metric
R102, R103, R104, R105: 2.2; R_0603_1608Metric
U1: IR2110S; SOIC-16W_7.5x10.3mm_P1.27mm

Connections:
3V3_IO: C149.1, C150.1, J10.1, U1.11 (VDD); also elsewhere on the board
12V: C41.2, C47.2, C147.1, C148.1, D1.2 (A), J10.2, U1.3 (VCC); also elsewhere on the board
/Katman2_GateDriver_U/HO_U: R6.1, R43.1, R102.2, R103.2, U1.8 (HO)
/Katman2_GateDriver_U/HO_U_OFF_D10: D10.1 (K), R102.1
/Katman2_GateDriver_U/HO_U_OFF_D23: D23.1 (K), R103.1
/Katman2_GateDriver_U/LO_U: R7.1, R45.1, R104.2, R105.2, U1.1 (LO)
/Katman2_GateDriver_U/LO_U_OFF_D24: D24.1 (K), R104.1
/Katman2_GateDriver_U/LO_U_OFF_D25: D25.1 (K), R105.1
/Katman2_GateDriver_U/VB_U: C1.2, C3.2, D1.1 (K), U1.7 (VB)
GND: C41.1, C47.1, C149.2, C150.2, J10.3, R58.1, R59.2, U1.15 (VSS); also elsewhere on the board
G_UH1: D10.2 (A), J11.1, R6.2, R8.2; also elsewhere on the board
G_UH2: D23.2 (A), J11.3, R43.2, R44.2; also elsewhere on the board
G_UH_IN: J13.1, R59.1, U1.12 (HIN); also elsewhere on the board
G_UL1: D24.2 (A), J12.1, R7.2, R9.2; also elsewhere on the board
G_UL2: D25.2 (A), J12.3, R45.2, R46.2; also elsewhere on the board
G_UL_IN: J13.3, R58.2, U1.14 (LIN); also elsewhere on the board
Phase_U: C1.1, C3.1, J11.2, R8.1, R44.1, U1.6 (VS); also elsewhere on the board
SD: J13.2, U1.13 (SD); also elsewhere on the board
USH: C147.2, C148.2, J12.2, R9.1, R46.1, U1.2 (COM); also elsewhere on the board
U_SNS_N: J15.2; also elsewhere on the board
U_SNS_P: J15.1; also elsewhere on the board

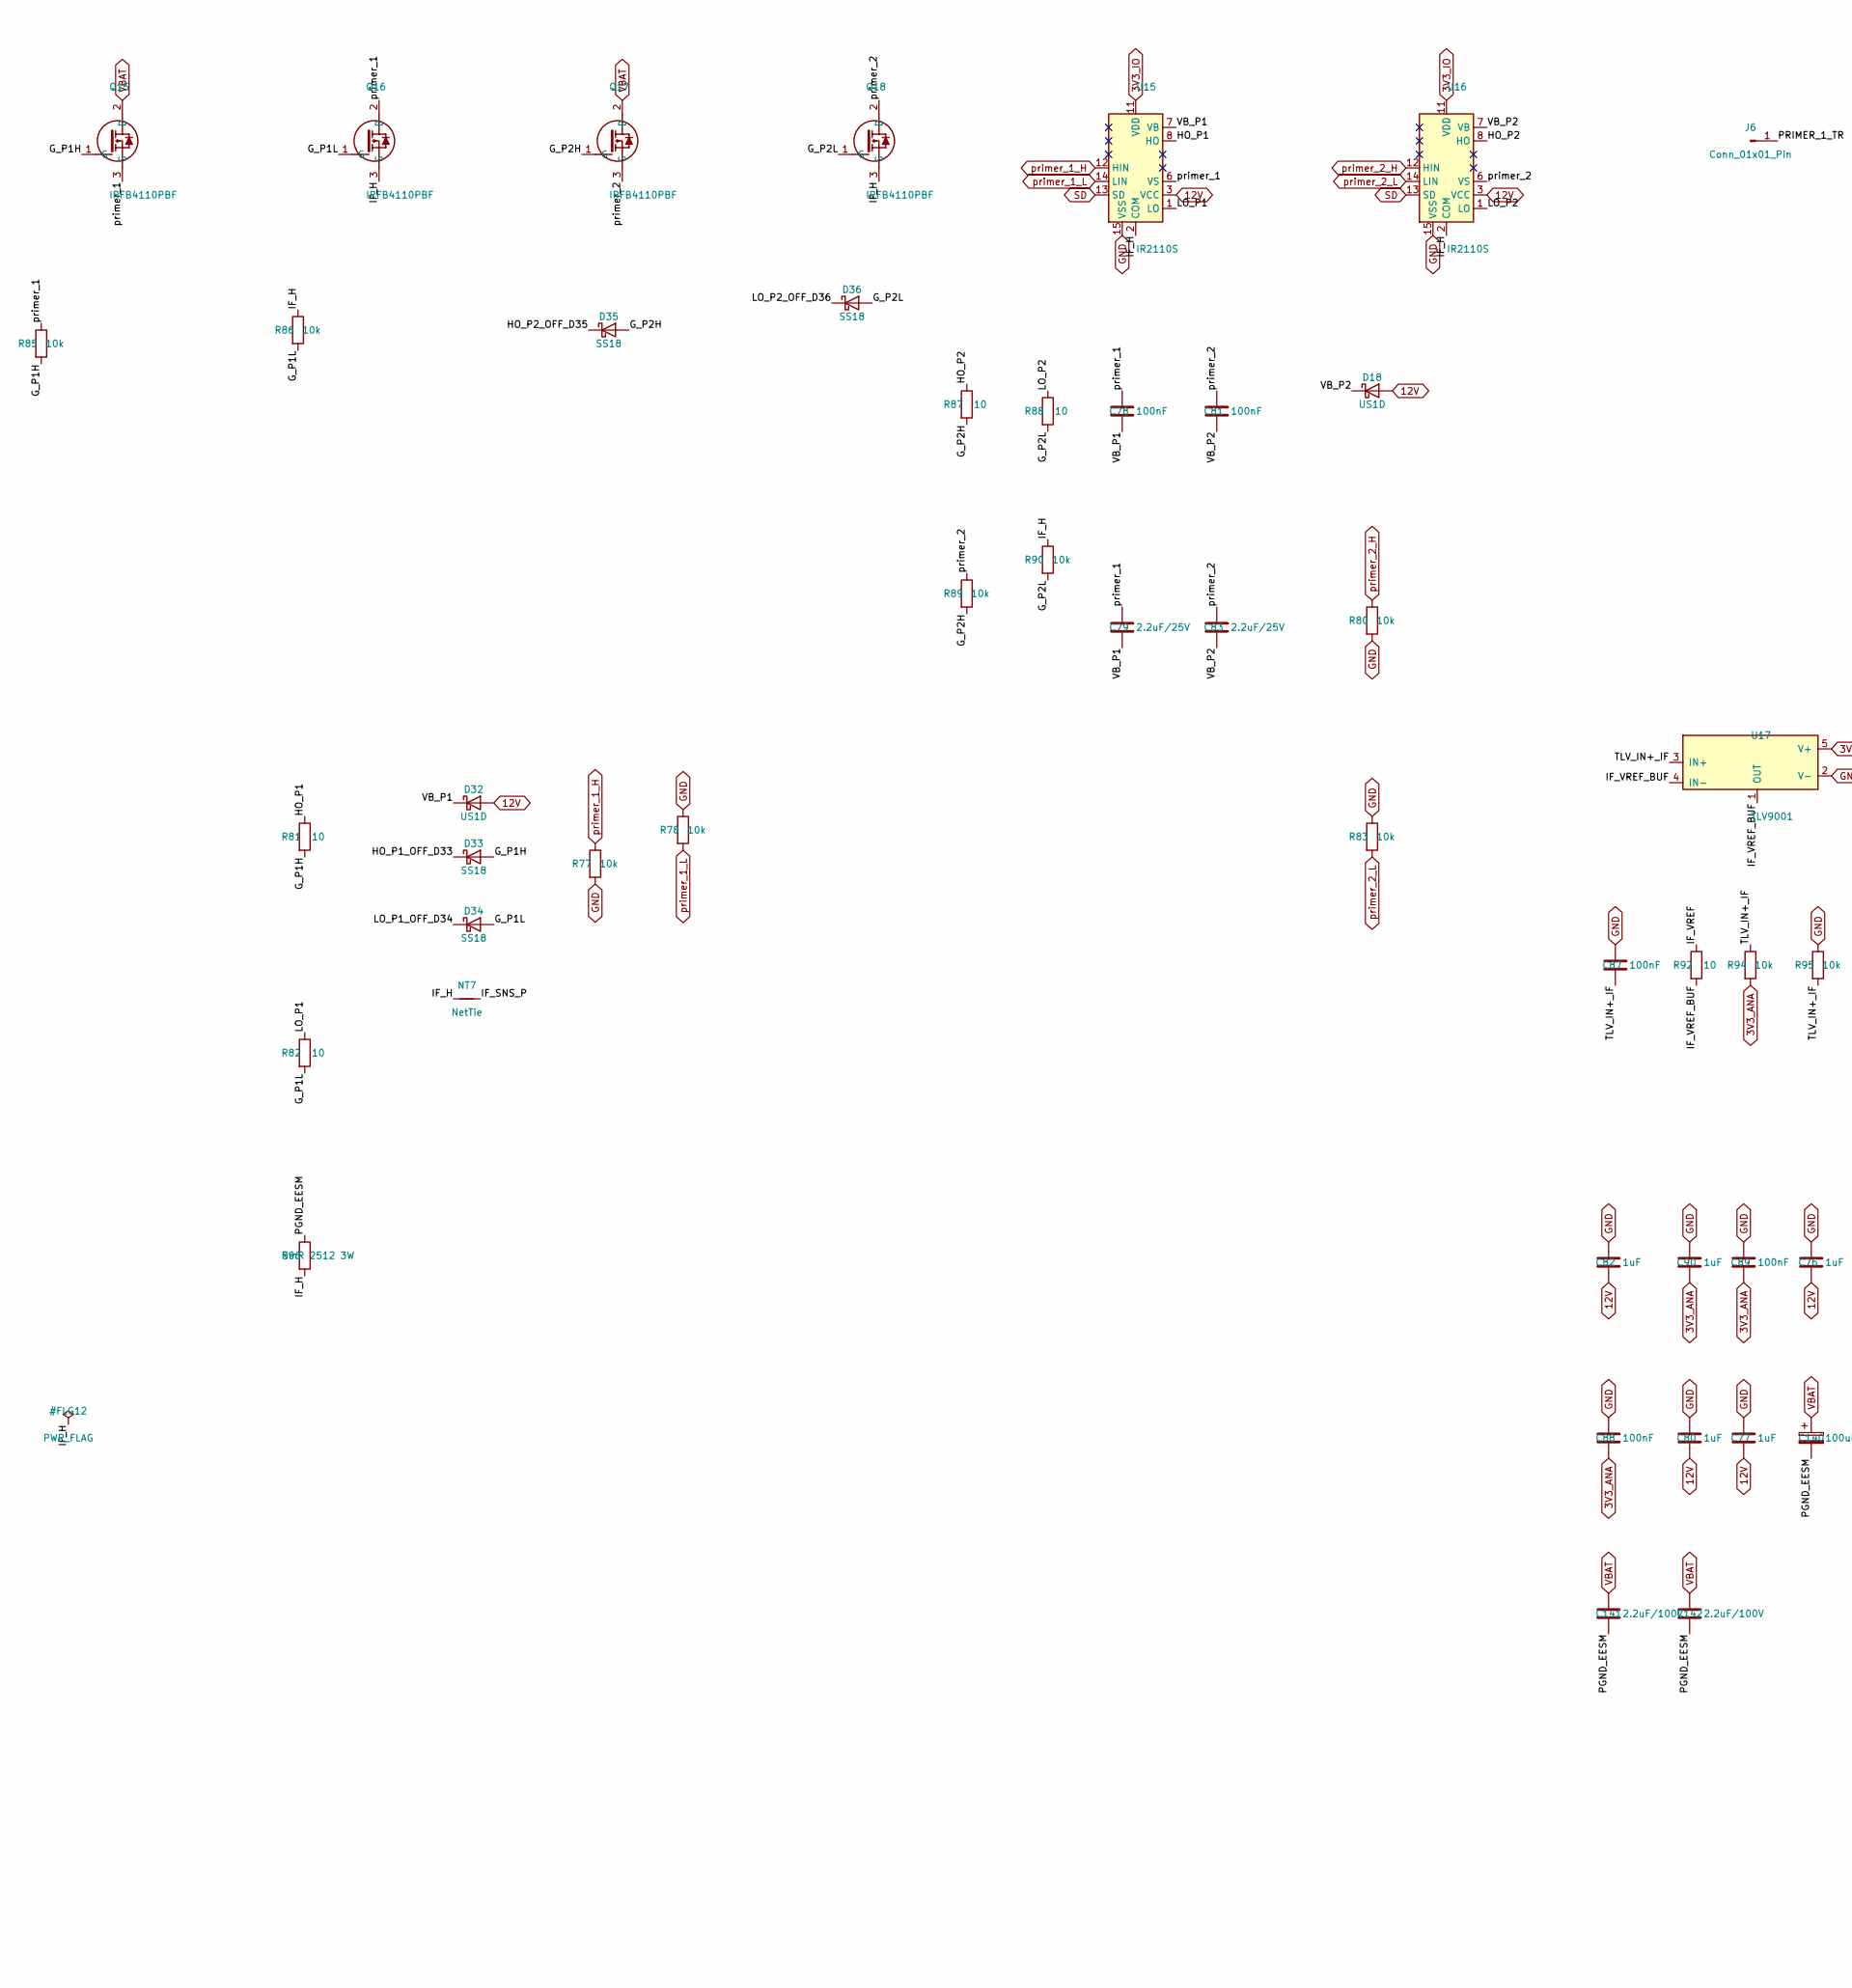
[picture p36: schematic eesm_modulu.kicad_sch, part in row 1, column 1]

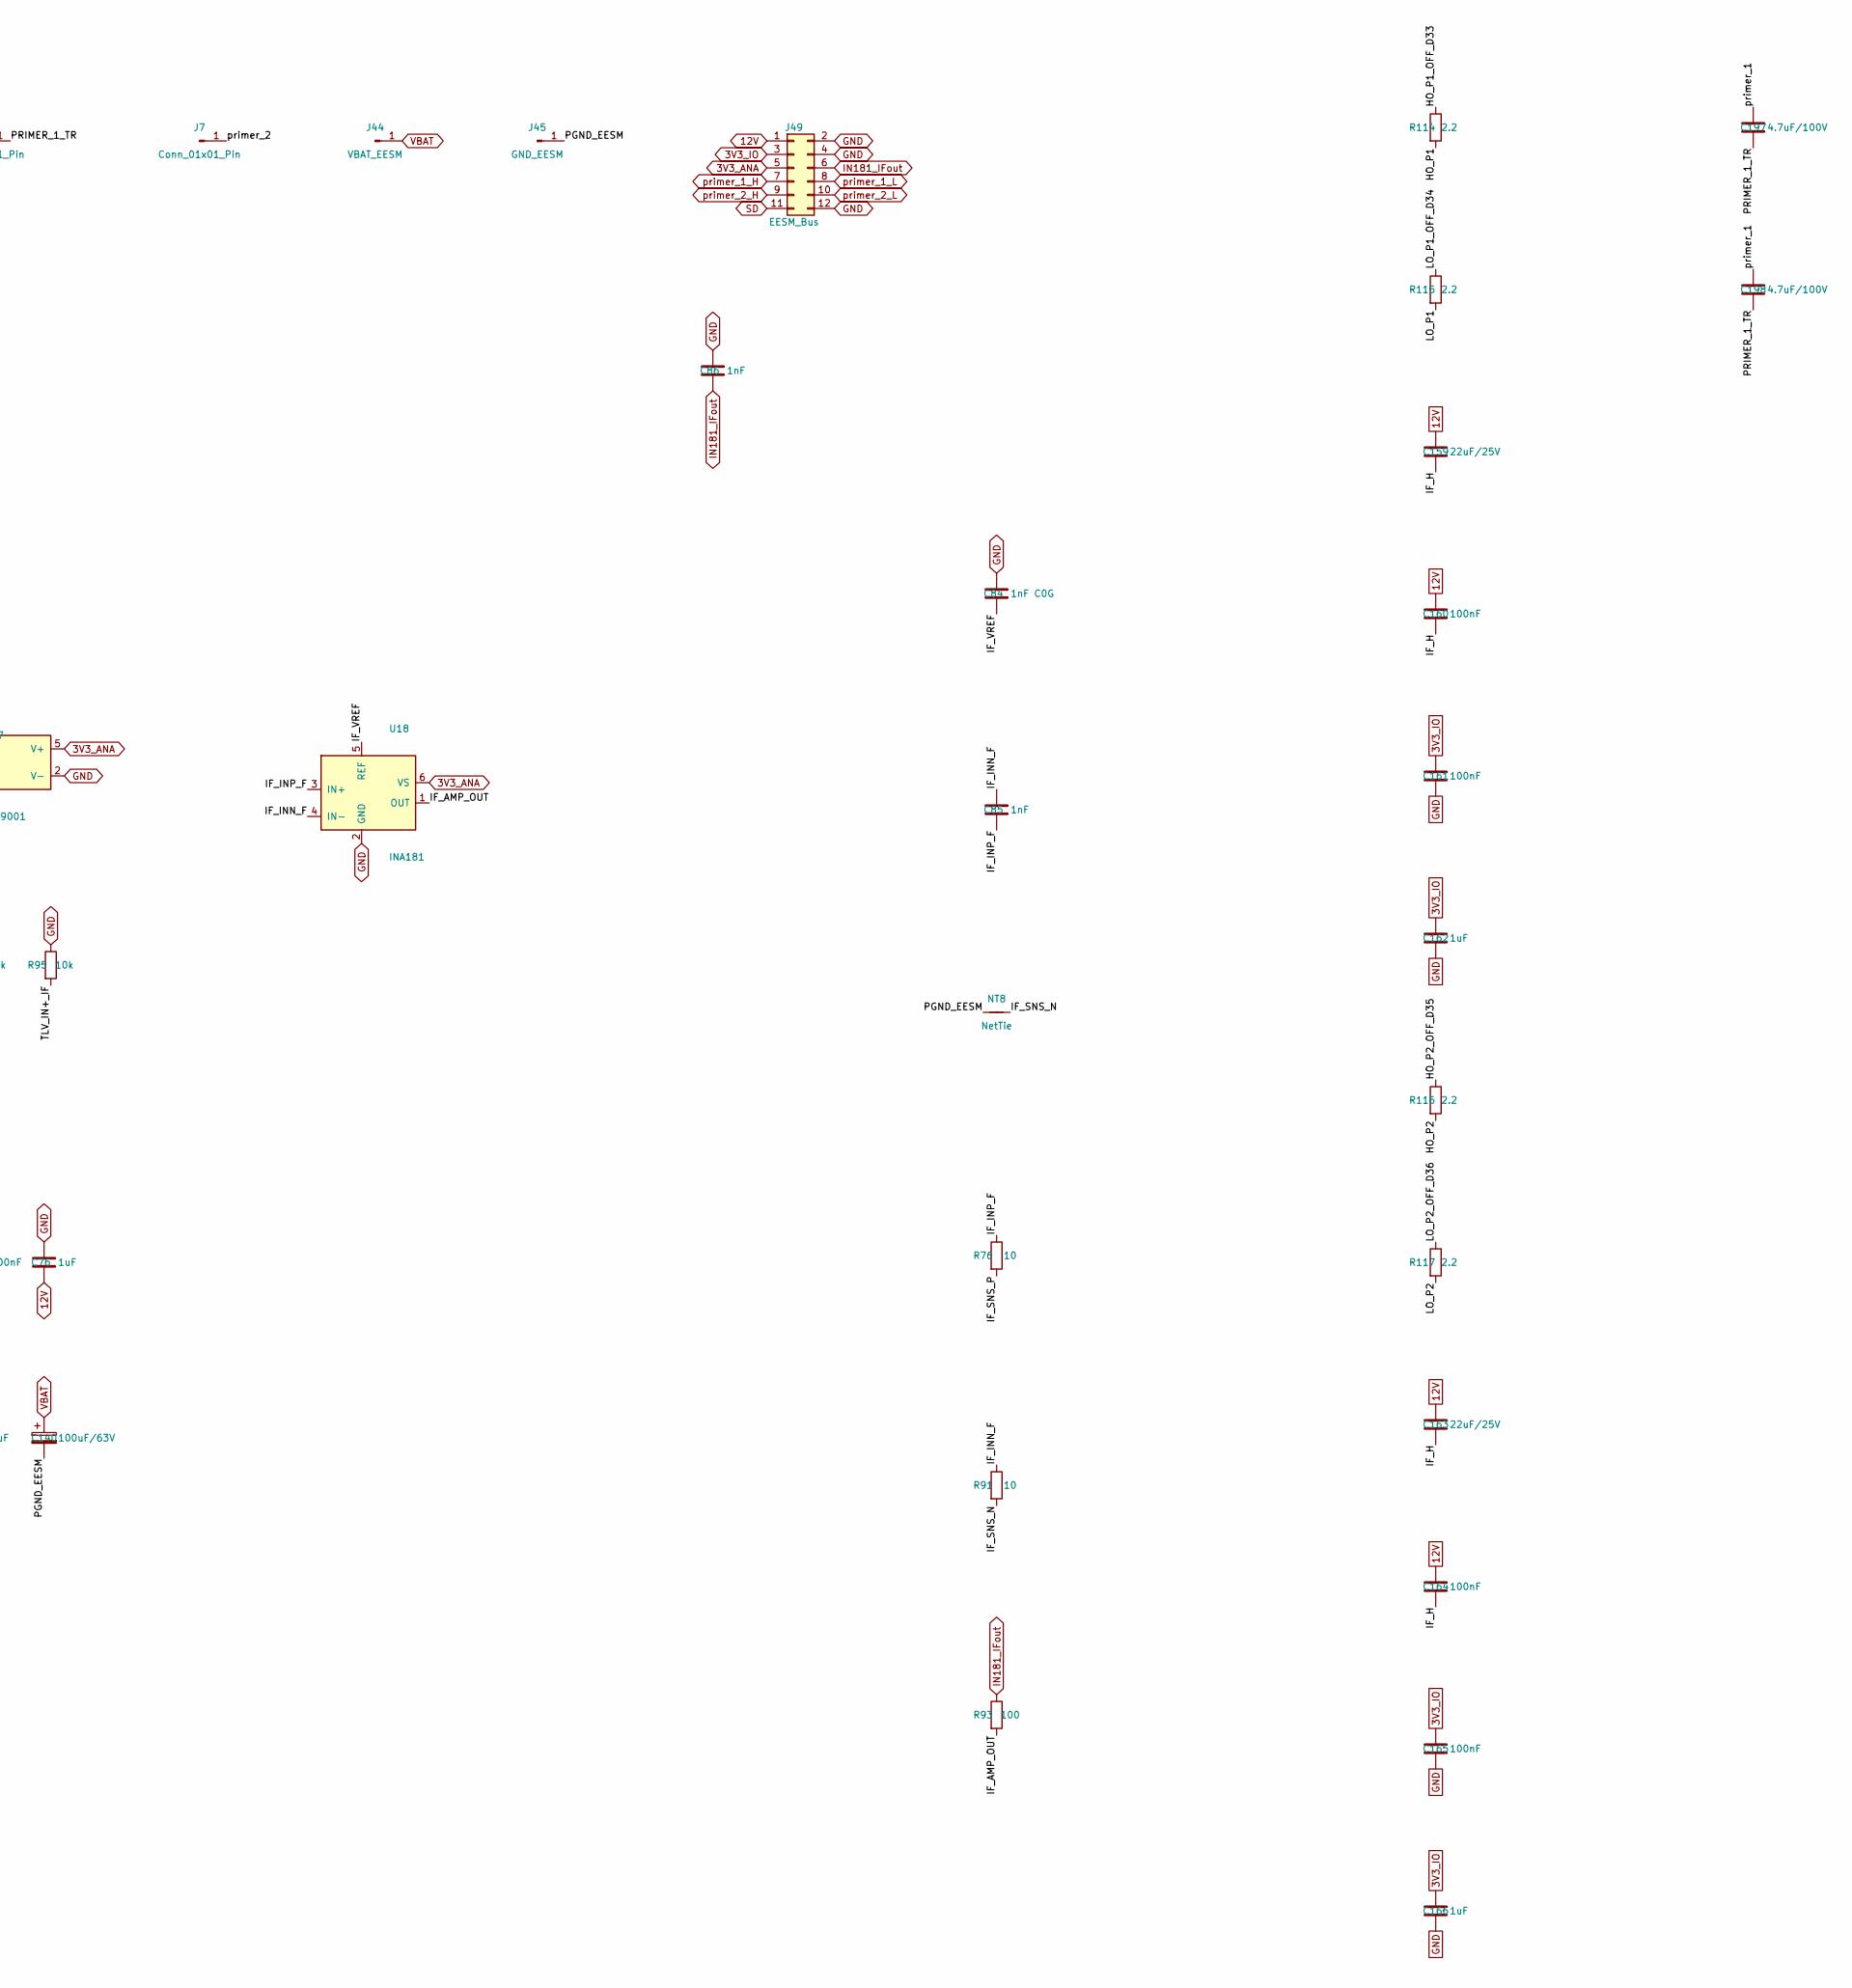
[picture p37: schematic eesm_modulu.kicad_sch, part in row 1, column 2]

Parts:
C76, C77, C80, C82, C90, C162, C166: 1uF; C_0603_1608Metric
C78, C81, C87, C88, C89, C160, C161, C164, C165: 100nF; C_0603_1608Metric
C79, C83: 2.2uF/25V; C_1206_3216Metric; MPN CL31B225KAHNNNE
C84: 1nF C0G; C_0603_1608Metric
C85, C86: 1nF; C_0603_1608Metric
C140: 100uF/63V; CP_Elec_10x10.5
C141, C142: 2.2uF/100V; C_1206_3216Metric
C159, C163: 22uF/25V; C_1206_3216Metric; MPN CL31A226KAHNNNE
C197, C198: 4.7uF/100V; C_1210_3225Metric; MPN GRM32ER72A475KA12L
D18, D32: US1D; D_SMA; MPN US1D-13-F
D33, D34, D35, D36: SS18; D_SMA
J6, J7: Conn_01x01_Pin; SolderWire-2.5sqmm_1x01_D2.4mm_OD4.4mm
J44: VBAT_EESM; SolderWire-2.5sqmm_1x01_D2.4mm_OD4.4mm
J45: GND_EESM; SolderWire-2.5sqmm_1x01_D2.4mm_OD4.4mm
J49: EESM_Bus; PinHeader_2x06_P2.54mm_Vertical
NT7, NT8: NetTie; NetTie-2_SMD_Pad0.5mm
Q15, Q16, Q17, Q18: IRFB4110PBF; TO-220-3_Vertical
R76, R81, R82, R87, R88, R91, R92: 10; R_0805_2012Metric
R77, R78, R80, R83, R85, R86, R89, R90, R94, R95: 10k; R_0603_1608Metric
R93: 100; R_0805_2012Metric
R96: 5mR 2512 3W; R_2512_6332Metric; MPN CSS2H-2512R-5L00F (Bourns) - dogrulanac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
R114, R115, R116, R117: 2.2; R_0603_1608Metric
U15, U16: IR2110S; SOIC-16W_7.5x10.3mm_P1.27mm
U17: TLV9001; TLV9001_LP
U18: INA181; INA181_LP

Connections:
3V3_ANA: C88.2, C89.2, C90.2, J49.5, R94.2, U17.5 (V+), U18.6 (VS); also elsewhere on the board
3V3_IO: C161.1, C162.1, C165.1, C166.1, J49.3, U15.11 (VDD), U16.11 (VDD); also elsewhere on the board
12V: C76.2, C77.2, C80.2, C82.2, C159.1, C160.1, C163.1, C164.1, D18.2 (A), D32.2 (A), J49.1, U15.3 (VCC), U16.3 (VCC); also elsewhere on the board
/Katman4_EESM_Modulu/G_P1H: D33.2 (A), Q15.1 (G), R81.2, R85.2
/Katman4_EESM_Modulu/G_P1L: D34.2 (A), Q16.1 (G), R82.2, R86.2
/Katman4_EESM_Modulu/G_P2H: D35.2 (A), Q17.1 (G), R87.2, R89.2
/Katman4_EESM_Modulu/G_P2L: D36.2 (A), Q18.1 (G), R88.2, R90.2
/Katman4_EESM_Modulu/HO_P1: R81.1, R114.2, U15.8 (HO)
/Katman4_EESM_Modulu/HO_P1_OFF_D33: D33.1 (K), R114.1
/Katman4_EESM_Modulu/HO_P2: R87.1, R116.2, U16.8 (HO)
/Katman4_EESM_Modulu/HO_P2_OFF_D35: D35.1 (K), R116.1
/Katman4_EESM_Modulu/IF_AMP_OUT: R93.2, U18.1 (OUT)
/Katman4_EESM_Modulu/IF_H: C159.2, C160.2, C163.2, C164.2, NT7.1, Q16.3 (S), Q18.3 (S), R86.1, R90.1, R96.2, U15.2 (COM), U16.2 (COM)
/Katman4_EESM_Modulu/IF_INN_F: C85.1, R91.1, U18.4 (IN-)
/Katman4_EESM_Modulu/IF_INP_F: C85.2, R76.1, U18.3 (IN+)
/Katman4_EESM_Modulu/IF_SNS_N: NT8.2, R91.2
/Katman4_EESM_Modulu/IF_SNS_P: NT7.2, R76.2
/Katman4_EESM_Modulu/IF_VREF: C84.2, R92.1, U18.5 (REF)
/Katman4_EESM_Modulu/IF_VREF_BUF: R92.2, U17.1 (OUT), U17.4 (IN-)
/Katman4_EESM_Modulu/LO_P1: R82.1, R115.2, U15.1 (LO)
/Katman4_EESM_Modulu/LO_P1_OFF_D34: D34.1 (K), R115.1
/Katman4_EESM_Modulu/LO_P2: R88.1, R117.2, U16.1 (LO)
/Katman4_EESM_Modulu/LO_P2_OFF_D36: D36.1 (K), R117.1
/Katman4_EESM_Modulu/PGND_EESM: C140.2, C141.2, C142.2, J45.1 (Pin_1_1), NT8.1, R96.1
/Katman4_EESM_Modulu/PRIMER_1_TR: C197.2, C198.2, J6.1 (Pin_1_1)
/Katman4_EESM_Modulu/TLV_IN+_IF: C87.2, R94.1, R95.2, U17.3 (IN+)
/Katman4_EESM_Modulu/VB_P1: C78.2, C79.2, D32.1 (K), U15.7 (VB)
/Katman4_EESM_Modulu/VB_P2: C81.2, C83.2, D18.1 (K), U16.7 (VB)
/Katman4_EESM_Modulu/primer_1: C78.1, C79.1, C197.1, C198.1, Q15.3 (S), Q16.2 (D), R85.1, U15.6 (VS)
/Katman4_EESM_Modulu/primer_2: C81.1, C83.1, J7.1 (Pin_1_1), Q17.3 (S), Q18.2 (D), R89.1, U16.6 (VS)
GND: C76.1, C77.1, C80.1, C82.1, C84.1, C86.1, C87.1, C88.1, C89.1, C90.1, C161.2, C162.2, C165.2, C166.2, J49.2, J49.4, J49.12, R77.2, R78.1, R80.2, R83.1, R95.1, U15.15 (VSS), U16.15 (VSS), U17.2 (V-), U18.2 (GND); also elsewhere on the board
IN181_IFout: C86.2, J49.6, R93.1; also elsewhere on the board
SD: J49.11, U15.13 (SD), U16.13 (SD); also elsewhere on the board
VBAT: C140.1, C141.1, C142.1, J44.1 (Pin_1_1), Q15.2 (D), Q17.2 (D); also elsewhere on the board
primer_1_H: J49.7, R77.1, U15.12 (HIN); also elsewhere on the board
primer_1_L: J49.8, R78.2, U15.14 (LIN); also elsewhere on the board
primer_2_H: J49.9, R80.1, U16.12 (HIN); also elsewhere on the board
primer_2_L: J49.10, R83.2, U16.14 (LIN); also elsewhere on the board

Schematic: kontrol_karti.kicad_sch

Parts:
C8: 10nF; C_0603_1608Metric
C9, C11: 100nF/100V; C_0805_2012Metric; MPN CL21B104KCFNNNE
C10, C16, C17, C22, C28, C29, C30, C35, C36, C37, C42, C45, C46, C100, C102, C103, C104, C105, C106, C136, C137, C143, C144, C199: 100nF; C_0603_1608Metric
C12: 4.7nF; C_0603_1608Metric
C13, C20, C31, C38, C107: 1uF; C_0603_1608Metric
C14, C15: 10uF; C_0603_1608Metric
C18, C39, C40, C91, C93: 10uF/25V; C_1206_3216Metric
C19, C92, C94, C146: 22uF/10V; C_0805_2012Metric
C21, C25, C32: 1nF C0G; C_0603_1608Metric
C23, C26, C33: 220nF; C_0603_1608Metric
C24, C27, C34, C132, C133, C134, C173, C174, C175, C176, C177, C178: 1nF; C_0603_1608Metric
C43, C44, C99, C101: 27pF; C_0603_1608Metric
C135: 10uF/16V; C_0805_2012Metric
C138, C139: 2.2uF/100V; C_1206_3216Metric
C145: 4.7uF/10V; C_0805_2012Metric
D37: NUP2105L; SOT-23
D40, D41: SS18; D_SMA
D42: SS34; D_SMA
D43: SMAJ15A; D_SMA
Enkoder_soket1: Conn_01x05_Socket; PinHeader_1x05_P2.54mm_Vertical
F1: PTC 1.1A/33V; Fuse_1812_4532Metric
FB1: FerriteBead; C_0805_2012Metric
J8: CAN-bus; PinHeader_1x03_P2.54mm_Vertical
J23: USB_IN; USB_C_Receptacle_GCT_USB4105-xx-A_16P_TopMnt_Horizontal
J35: Pwr_U; PinSocket_1x03_P2.54mm_Vertical
J36: Ctrl_U; PinSocket_1x03_P2.54mm_Vertical
J37: Sense_U; PinHeader_1x02_P2.54mm_Vertical
J38: Pwr_V; PinSocket_1x03_P2.54mm_Vertical
J39: Ctrl_V; PinSocket_1x03_P2.54mm_Vertical
J40: Sense_V; PinHeader_1x02_P2.54mm_Vertical
J41: Pwr_W; PinSocket_1x03_P2.54mm_Vertical
J42: Ctrl_W; PinSocket_1x03_P2.54mm_Vertical
J43: Sense_W; PinHeader_1x02_P2.54mm_Vertical
J47: Riser_VBAT_GND; PinHeader_2x02_P2.54mm_Vertical
J48: EESM_Bus; PinSocket_2x06_P2.54mm_Vertical
J50: Kontaktor; PinHeader_1x04_P2.54mm_Vertical
J51: NTC_sogutucu; PinHeader_1x02_P2.54mm_Vertical
JICSPSoket1: Conn_01x05_Pin; PinHeader_1x05_P2.54mm_Vertical
JP1: CAN 120R; SolderJumper-2_P1.3mm_Open_RoundedPad1.0x1.5mm
L2: 33uH; L_Bourns_SRR1260; MPN SRR1260-330M
Q13, Q14: IRLML0100TRPBF; SOT-23
Q19, Q20: AO3400A; SOT-23
R4: 5.6k; R_0805_2012Metric
R5, R100: 100k; R_0603_1608Metric
R18: 20k; R_0603_1608Metric
R19: 1.05k 1%; R_0805_2012Metric
R20: 2.2; R_0603_1608Metric
R21: 100k; R_1206_3216Metric
R22: 60k; R_0603_1608Metric_Pad0.98x0.95mm_HandSolder
R23, R24, R33, R34, R39, R40, R68, R140, R142: 10k; R_0603_1608Metric
R25, R26, R27, R29, R30, R31, R35, R36, R37: 10; R_0805_2012Metric
R28, R32, R38, R69, R71, R73, R75: 100; R_0805_2012Metric
R41, R42: 5.1k; R_0805_2012Metric
R57: 2.2k; R_0603_1608Metric
R66: 100k; R_0603_1608Metric_Pad0.98x0.95mm_HandSolder
R67: 4.7k; R_0805_2012Metric
R70, R72, R74: 1.5k; R_0805_2012Metric
R97: 0R; R_0805_2012Metric
R98: 470k; R_1206_3216Metric
R99: 27k; R_0603_1608Metric
R101: 120; R_0805_2012Metric
R139, R141: 100; R_0603_1608Metric
R143: 10k 0.1%; R_0603_1608Metric
R144: 1k; R_0603_1608Metric
SW1: SW_Push; SW_SPST_CK_RS282G05A3
U4: ADuM1201; ADuM1201_LP
U5: CH340G; CH340G_LP
U6: dsPIC33CK256MP508; LQFP-80_12x12mm_P0.5mm
U7, U12, U14: INA181; INA181_LP
U8, U19, U20: LDL1117S33R; NCP1117
U9: MIC2128; MIC2128_LP
U10, U11, U13: TLV9001; TLV9001_LP
U21: LDL1117S50R; NCP1117
U22: TJA1051; TJA1051_LP
U23: SP0503BAHT; SOT-143
U24: USBLC6-2SC6; SOT-23-6
U25: TSR 1-2450; Converter_DCDC_TRACO_TSR-1_THT
Y2, Y3: 12MHz Kristal; AS-12.000-18-3030-EXT-SMD-TR

Connections:
3V3_ANA: C16.2, C17.2, C20.2, C29.2, C30.2, C31.2, C36.2, C37.2, C38.2, C94.2, FB1.1, J48.5, R23.2, R33.2, R39.2, R143.1, U7.6 (VS), U10.5 (V+), U11.5 (V+), U12.6 (VS), U13.5 (V+), U14.6 (VS), U20.2 (VO), U20.4 (TAB); also elsewhere on the board
3V3_IO: C19.2, C137.1, C143.1, Enkoder_soket1.1, J35.1, J38.1, J41.1, J48.3, R57.1, R70.1, R72.1, R74.1, U4.8 (VDD2), U8.2 (VO), U8.4 (TAB), U22.5 (VIO); also elsewhere on the board
3V3_MCU: C92.2, C102.2, C103.2, C104.2, C105.2, JICSPSoket1.2, R68.2, R100.2, U6.12 (VDD), U6.31 (VDD), U6.51 (VDD), U6.71 (VDD), U19.2 (VO), U19.4 (TAB)
5V_CAN: C135.1, C136.1, U21.2 (VO), U21.4 (TAB), U22.3 (VCC)
5V_USB: C45.2, C46.2, C145.1, J23.A4 (VBUS), J23.A9 (VBUS), J23.B4 (VBUS), J23.B9 (VBUS), U4.1 (VDD1), U5.16 (VCC), U24.5 (VBUS)
12V: C12.2, C13.2, C18.2, C39.2, C40.2, C91.2, C93.2, D42.1 (K), J35.2, J38.2, J41.2, J48.1, L2.2, R18.2, U9.9 (EXTVDD), U21.3 (VI), U25.1 (IN); also elsewhere on the board
/Katman3_Kontrol_Karti/5V_SYS: C146.1, U8.3 (VI), U19.3 (VI), U20.3 (VI), U25.3 (OUT)
/Katman3_Kontrol_Karti/12V_EXT: D42.2 (A), F1.2
/Katman3_Kontrol_Karti/BUCK_BST: C10.2, U9.4 (BST)
/Katman3_Kontrol_Karti/BUCK_EN: R98.2, R99.1, U9.10 (EN)
/Katman3_Kontrol_Karti/BUCK_FB_DIV: R19.1, R97.2
/Katman3_Kontrol_Karti/BUCK_FREQ: R21.2, R22.2, U9.11 (FREQ)
/Katman3_Kontrol_Karti/BUCK_ILIM: R4.1, U9.2 (ILIM)
/Katman3_Kontrol_Karti/BUCK_PG: R100.1, U6.66 (RC10/RP58), U9.1 (PG)
/Katman3_Kontrol_Karti/BUCK_PVDD: C14.2, R20.1, U9.8 (PVDD)
/Katman3_Kontrol_Karti/BUCK_RIPPLE: C11.1, R5.2
/Katman3_Kontrol_Karti/BUCK_SS: C8.2, U9.12 (SS)
/Katman3_Kontrol_Karti/BUCK_SW: C10.1, C11.2, L2.1, Q13.3 (D), Q14.2 (S), R4.2, U9.3 (SW)
/Katman3_Kontrol_Karti/BUCK_VDD: C15.2, R20.2, U9.15 (VDD)
/Katman3_Kontrol_Karti/CANH: D37.1 (K), J8.2, R101.1, U22.7 (CANH)
/Katman3_Kontrol_Karti/CANL: D37.2 (K), J8.1, JP1.2 (B), U22.6 (CANL)
/Katman3_Kontrol_Karti/CAN_TERM: JP1.1 (A), R101.2
/Katman3_Kontrol_Karti/CH340_V3: C42.2, U5.4 (V3)
/Katman3_Kontrol_Karti/CH340_XI: C43.2, U5.7 (XI), Y2.1
/Katman3_Kontrol_Karti/CH340_XO: C44.2, U5.8 (XO), Y2.2
/Katman3_Kontrol_Karti/CH_RXD: U4.2 (VOA), U5.3 (RXD)
/Katman3_Kontrol_Karti/CH_TXD: U4.3 (VIB), U5.2 (TXD)
/Katman3_Kontrol_Karti/COIL_12V: D40.1 (K), D41.1 (K), D43.1 (K), F1.1, J50.1
/Katman3_Kontrol_Karti/CONT_EN: R139.1, U6.2 (RE0)
/Katman3_Kontrol_Karti/CONT_EN_G: Q19.1 (G), R139.2, R140.1
/Katman3_Kontrol_Karti/CONT_K: D40.2 (A), J50.2, Q19.3 (D)
/Katman3_Kontrol_Karti/DH: Q14.1 (G), U9.5 (DH)
/Katman3_Kontrol_Karti/DL: Q13.1 (G), U9.7 (DL)
/Katman3_Kontrol_Karti/Enkoder_A: C132.2, R71.2, U6.54 (RD5/RP69)
/Katman3_Kontrol_Karti/Enkoder_A_soket: Enkoder_soket1.2, R70.2, R71.1, U23.2 (K)
/Katman3_Kontrol_Karti/Enkoder_B: C133.2, R73.2, U6.53 (RD6/RP70)
/Katman3_Kontrol_Karti/Enkoder_B_soket: Enkoder_soket1.3, R72.2, R73.1, U23.3 (K)
/Katman3_Kontrol_Karti/Enkoder_Z: C134.2, R75.2, U6.52 (RD7/RP71)
/Katman3_Kontrol_Karti/Enkoder_Z_soket: Enkoder_soket1.4, R74.2, R75.1, U23.4 (K)
/Katman3_Kontrol_Karti/FB: C12.1, R5.1, R18.1, R19.2, U9.13 (FB)
/Katman3_Kontrol_Karti/IN181_Uout: C24.2, R28.1, U6.16 (RA0)
/Katman3_Kontrol_Karti/IN181_Vout: C27.2, R32.1, U6.18 (RA1), U6.33 (RC3/RP51)
/Katman3_Kontrol_Karti/IN181_Wout: C34.2, R38.1, U6.58 (RB7/RP39)
/Katman3_Kontrol_Karti/MCLR: JICSPSoket1.1, R69.1, U6.9 (MCLR)
/Katman3_Kontrol_Karti/MCLR_SW: C144.1, R68.1, R69.2, SW1.2
/Katman3_Kontrol_Karti/NTC_ADC: C199.1, R144.2, U6.20 (RA2)
/Katman3_Kontrol_Karti/NTC_HS: J51.1, R143.2, R144.1
/Katman3_Kontrol_Karti/OSCI_DSP: C101.2, U6.34 (OSCI/CLKI), Y3.2
/Katman3_Kontrol_Karti/OSCO_DSP: C99.2, U6.35 (OSCO/CLKO), Y3.1
/Katman3_Kontrol_Karti/PGC1: JICSPSoket1.5, U6.61 (RB9/RP41)
/Katman3_Kontrol_Karti/PGD1: JICSPSoket1.4, U6.60 (RB8/RP40)
/Katman3_Kontrol_Karti/PRE_EN: R141.1, U6.4 (RE1)
/Katman3_Kontrol_Karti/PRE_EN_G: Q20.1 (G), R141.2, R142.1
/Katman3_Kontrol_Karti/PRE_K: D41.2 (A), J50.3, Q20.3 (D)
/Katman3_Kontrol_Karti/RXD_DSP: U4.6 (VOB), U6.46 (RC8/RP56)
/Katman3_Kontrol_Karti/RXD_DSP_can: U6.68 (RD4/RP68), U22.4 (RXD)
/Katman3_Kontrol_Karti/TLV_IN+_u: C22.2, R23.1, R24.2, U10.3 (IN+)
/Katman3_Kontrol_Karti/TLV_IN+_v: C28.2, R33.1, R34.2, U11.3 (IN+)
/Katman3_Kontrol_Karti/TLV_IN+_w: C35.2, R39.1, R40.2, U13.3 (IN+)
/Katman3_Kontrol_Karti/TXD_DSP: U4.7 (VIA), U6.47 (RC9/RP57)
/Katman3_Kontrol_Karti/TXD_DSP_can: U6.69 (RD3/RP67), U22.1 (TXD)
/Katman3_Kontrol_Karti/USB_CC1: J23.A5 (CC1), R41.2
/Katman3_Kontrol_Karti/USB_CC2: J23.B5 (CC2), R42.2
/Katman3_Kontrol_Karti/USB_DM: J23.A7 (D-), J23.B7 (D-), U5.6 (UD-), U24.3 (I/O2), U24.4 (I/O2)
/Katman3_Kontrol_Karti/USB_DP: J23.A6 (D+), J23.B6 (D+), U5.5 (UD+), U24.1 (I/O1), U24.6 (I/O1)
/Katman3_Kontrol_Karti/U_AMP_OUT: R28.2, U7.1 (OUT)
/Katman3_Kontrol_Karti/U_INN_F: C23.1, C174.1, R27.1, U7.4 (IN-)
/Katman3_Kontrol_Karti/U_INP_F: C23.2, C173.1, R26.1, U7.3 (IN+)
/Katman3_Kontrol_Karti/U_VREF: C21.2, R25.1, U7.5 (REF)
/Katman3_Kontrol_Karti/U_VREF_BUF: R25.2, U10.1 (OUT), U10.4 (IN-)
/Katman3_Kontrol_Karti/V_AMP_OUT: R32.2, U12.1 (OUT)
/Katman3_Kontrol_Karti/V_BUS_SENSE: C100.2, R66.2, R67.2, U6.21 (RA3)
/Katman3_Kontrol_Karti/V_INN_F: C26.1, C176.1, R30.1, U12.4 (IN-)
/Katman3_Kontrol_Karti/V_INP_F: C26.2, C175.1, R29.1, U12.3 (IN+)
/Katman3_Kontrol_Karti/V_VREF: C25.2, R31.1, U12.5 (REF)
/Katman3_Kontrol_Karti/V_VREF_BUF: R31.2, U11.1 (OUT), U11.4 (IN-)
/Katman3_Kontrol_Karti/W_AMP_OUT: R38.2, U14.1 (OUT)
/Katman3_Kontrol_Karti/W_INN_F: C33.1, C178.1, R36.1, U14.4 (IN-)
/Katman3_Kontrol_Karti/W_INP_F: C33.2, C177.1, R35.1, U14.3 (IN+)
/Katman3_Kontrol_Karti/W_VREF: C32.2, R37.1, U14.5 (REF)
/Katman3_Kontrol_Karti/W_VREF_BUF: R37.2, U13.1 (OUT), U13.4 (IN-)
AVDD: C106.2, C107.2, FB1.2, U6.25 (AVDD)
GND: C8.1, C9.1, C13.1, C14.1, C15.1, C16.1, C17.1, C18.1, C19.1, C20.1, C21.1, C22.1, C24.1, C25.1, C27.1, C28.1, C29.1, C30.1, C31.1, C32.1, C34.1, C35.1, C36.1, C37.1, C38.1, C39.1, C40.1, C91.1, C92.1, C93.1, C94.1, C99.1, C100.1, C101.1, C102.1, C103.1, C104.1, C105.1, C106.1, C107.1, C132.1, C133.1, C134.1, C135.2, C136.2, C137.2, C138.2, C139.2, C143.2, C144.2, C146.2, C173.2, C174.2, C175.2, C176.2, C177.2, C178.2, C199.2, D37.3 (A), D43.2 (A), Enkoder_soket1.5, J8.3, J35.3, J38.3, J41.3, J47.2, J47.4, J48.2, J48.4, J48.12, J50.4, J51.2, JICSPSoket1.3, Q13.2 (S), Q19.2 (S), Q20.2 (S), R22.1, R24.1, R34.1, R40.1, R67.1, R97.1, R99.2, R140.2, R142.2, SW1.1, U4.5 (GND2), U6.11 (VSS), U6.26 (AVSS), U6.32 (VSS), U6.50 (VSS), U6.70 (VSS), U7.2 (GND), U8.1 (GND/ADJ), U9.6 (PGND), U9.14 (AGND), U9.17 (EP), U10.2 (V-), U11.2 (V-), U12.2 (GND), U13.2 (V-), U14.2 (GND), U19.1 (GND/ADJ), U20.1 (GND/ADJ), U21.1 (GND/ADJ), U22.2 (GND), U22.8 (S), U23.1 (A), U25.2 (GND); also elsewhere on the board
GND_PC: C42.1, C43.1, C44.1, C45.1, C46.1, C145.2, J23.A1 (GND), J23.A12 (GND), J23.B1 (GND), J23.B12 (GND), J23.SH (SHIELD), R41.1, R42.1, U4.4 (GND1), U5.1 (GND), U24.2 (GND)
G_UH_IN: J36.1, U6.1 (RB14/RP46); also elsewhere on the board
G_UL_IN: J36.3, U6.3 (RB15/RP47); also elsewhere on the board
G_VH_IN: J39.1, U6.78 (RB12/RP44); also elsewhere on the board
G_VL_IN: J39.3, U6.80 (RB13/RP45); also elsewhere on the board
G_WH_IN: J42.1, U6.75 (RB10/RP42); also elsewhere on the board
G_WL_IN: J42.3, U6.76 (RB11/RP43); also elsewhere on the board
IN181_IFout: J48.6, U6.23 (RA4); also elsewhere on the board
SD: J36.2, J39.2, J42.2, J48.11, R57.2, U6.72 (RD2/RP66); also elsewhere on the board
U_SNS_N: J37.2, R27.2; also elsewhere on the board
U_SNS_P: J37.1, R26.2; also elsewhere on the board
VBAT: C9.2, C138.1, C139.1, J47.1, J47.3, Q14.3 (D), R21.1, R66.1, R98.1, U9.16 (VIN); also elsewhere on the board
V_SNS_N: J40.2, R30.2; also elsewhere on the board
V_SNS_P: J40.1, R29.2; also elsewhere on the board
W_SNS_N: J43.2, R36.2; also elsewhere on the board
W_SNS_P: J43.1, R35.2; also elsewhere on the board
primer_1_H: J48.7, U6.73 (RD1/RP65); also elsewhere on the board
primer_1_L: J48.8, U6.74 (RD0/RP64); also elsewhere on the board
primer_2_H: J48.9, U6.63 (RC4/RP52); also elsewhere on the board
primer_2_L: J48.10, U6.65 (RC5/RP53); also elsewhere on the board
