tekcanyilmaz42-gif/bldc_driver/yedek_faz7/pre_inceleme3/bldc_driver_ai.kicad_pcb

## KiCad design yedek_faz7/pre_inceleme3/bldc_driver_ai.kicad_pcb (continued)

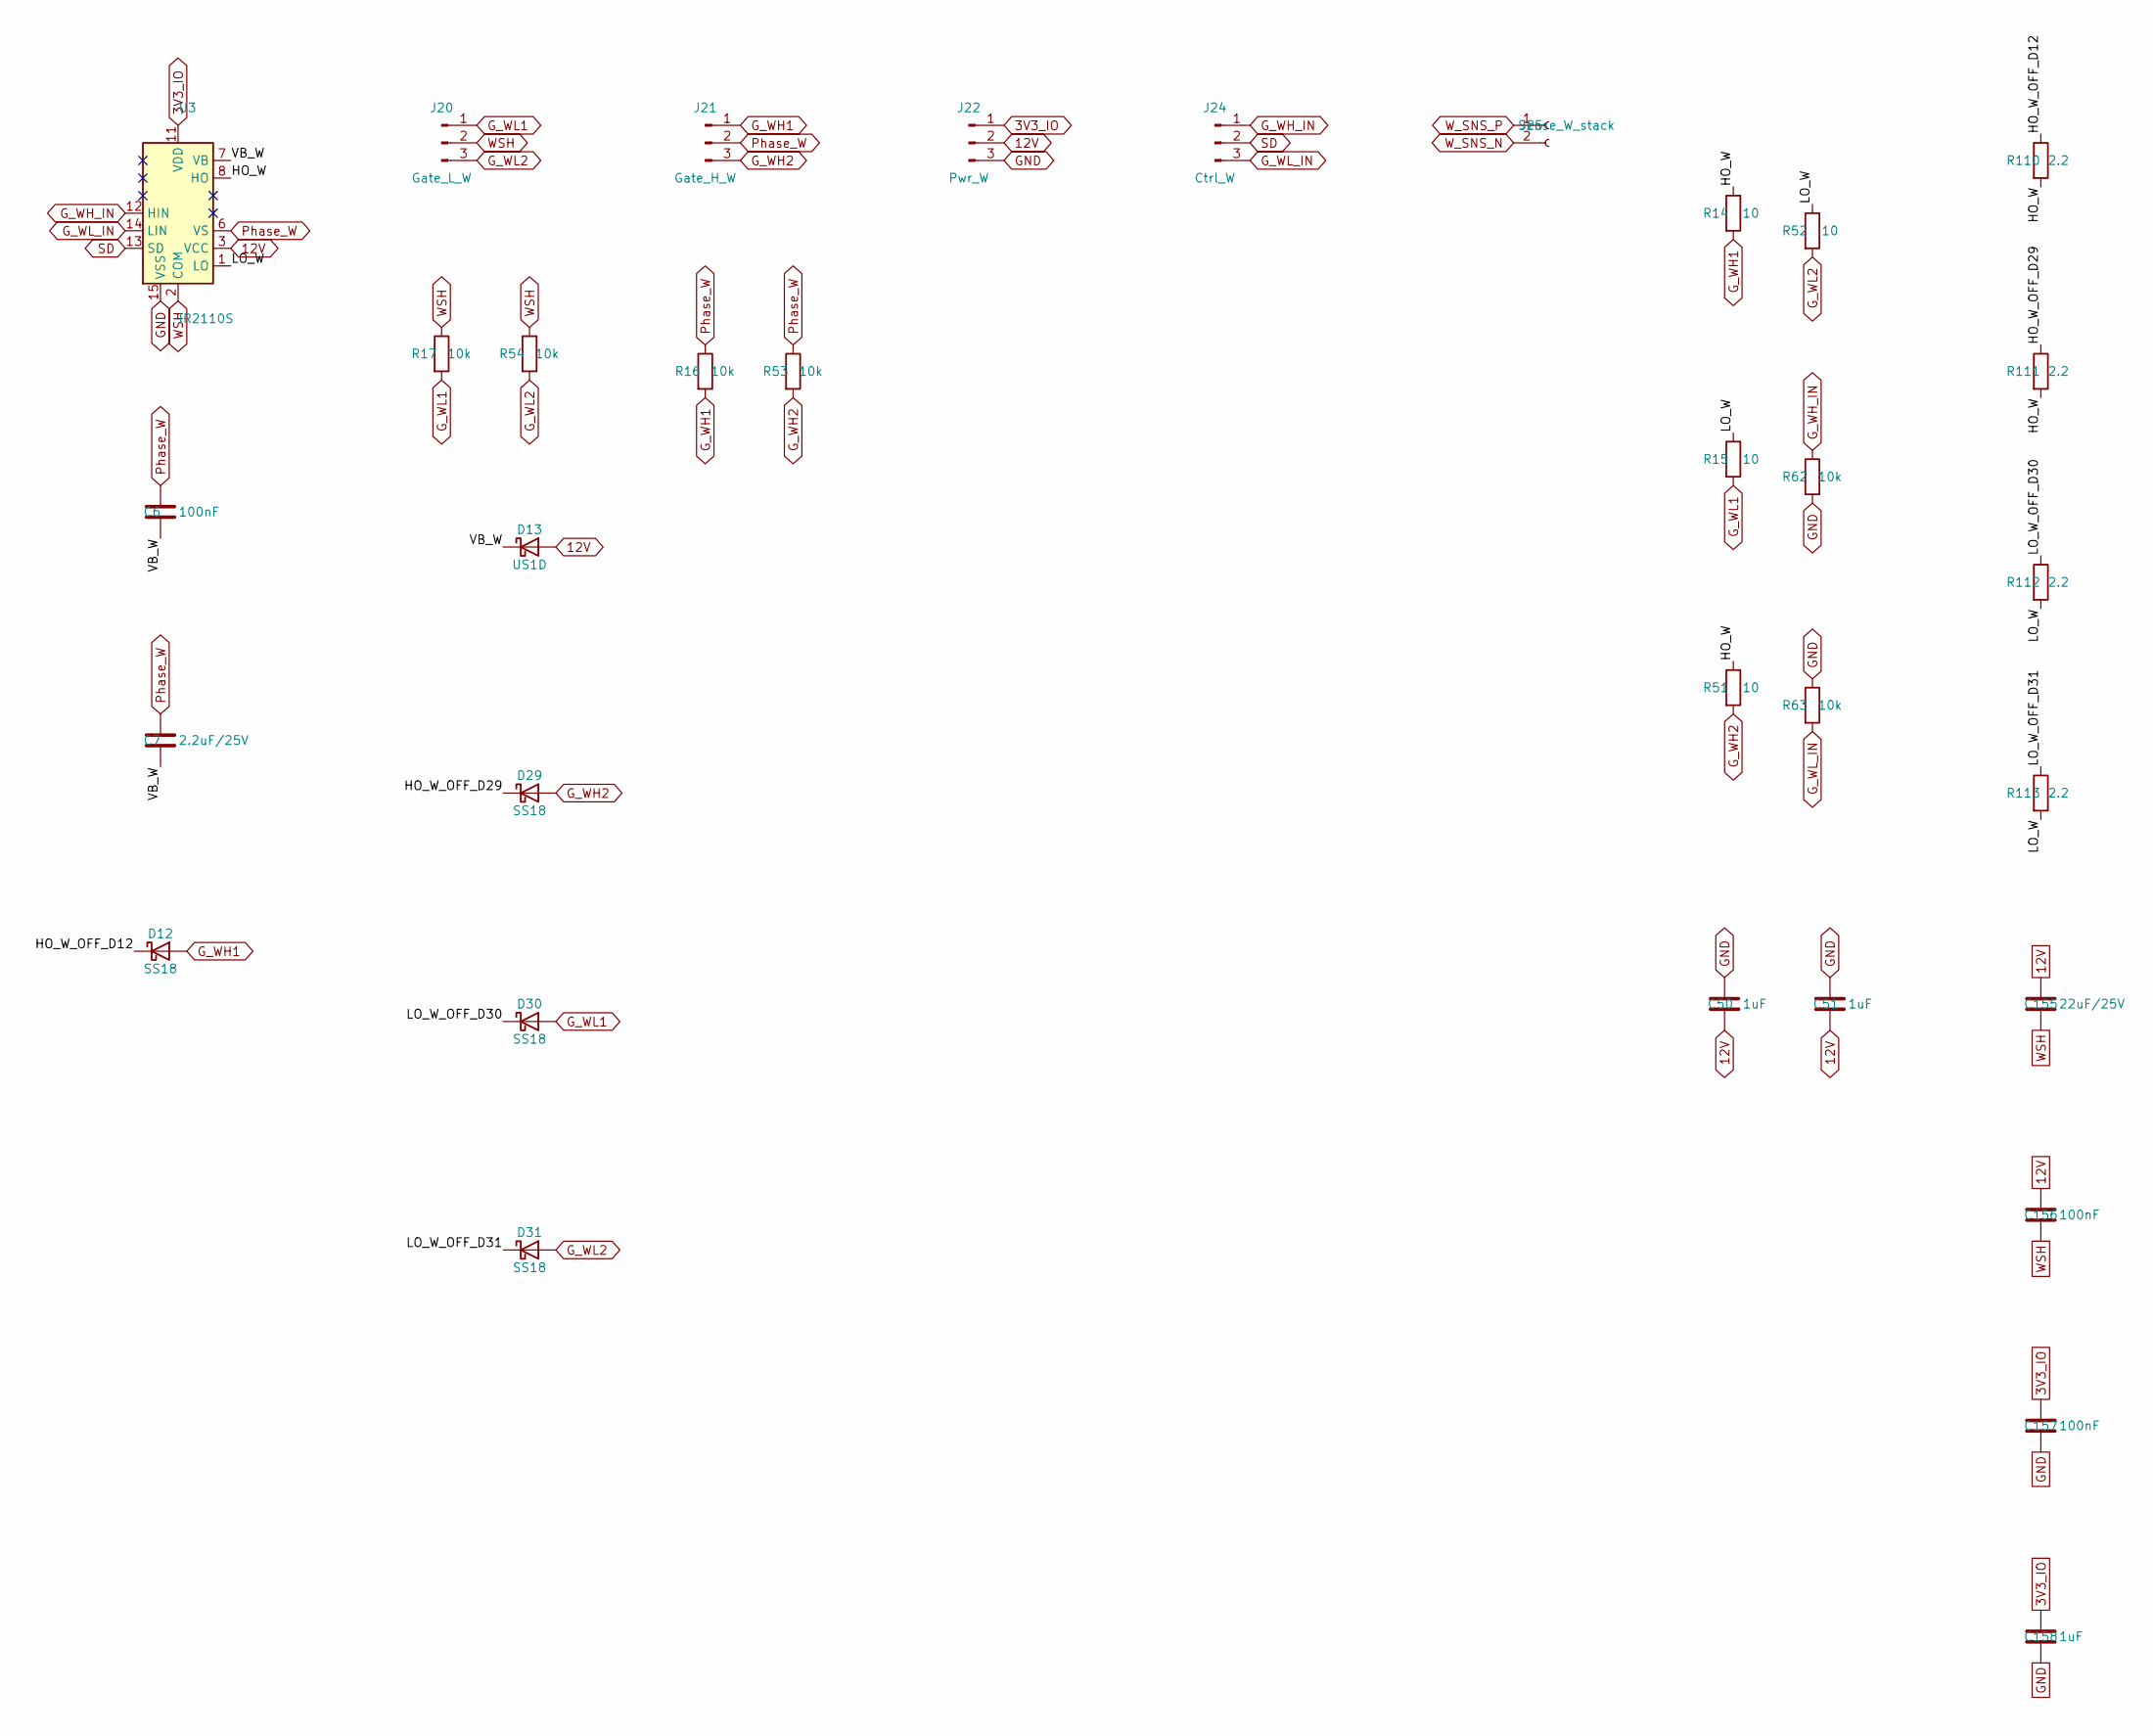
[picture p38: schematic gate_driver_w.kicad_sch]

Parts:
C6, C156, C157: 100nF; C_0603_1608Metric
C7: 2.2uF/25V; C_1206_3216Metric; MPN CL31B225KAHNNNE
C50, C51, C158: 1uF; C_0603_1608Metric
C155: 22uF/25V; C_1206_3216Metric; MPN CL31A226KAHNNNE
D12, D29, D30, D31: SS18; D_SMA
D13: US1D; D_SMA; MPN US1D-13-F
J20: Gate_L_W; PinHeader_1x03_P2.54mm_Vertical
J21: Gate_H_W; PinHeader_1x03_P2.54mm_Vertical
J22: Pwr_W; PinHeader_1x03_P2.54mm_Vertical
J24: Ctrl_W; PinHeader_1x03_P2.54mm_Vertical
J25: Sense_W_stack; PinSocket_1x02_P2.54mm_Vertical
R14, R15, R51, R52: 10; R_0805_2012Metric
R16, R17, R53, R54, R62, R63: 10k; R_0603_1608Metric
R110, R111, R112, R113: 2.2; R_0603_1608Metric
U3: IR2110S; SOIC-16W_7.5x10.3mm_P1.27mm

Connections:
3V3_IO: C157.1, C158.1, J22.1, U3.11 (VDD); also elsewhere on the board
12V: C50.2, C51.2, C155.1, C156.1, D13.2 (A), J22.2, U3.3 (VCC); also elsewhere on the board
/Katman2_GateDriver_W/HO_W: R14.1, R51.1, R110.2, R111.2, U3.8 (HO)
/Katman2_GateDriver_W/HO_W_OFF_D12: D12.1 (K), R110.1
/Katman2_GateDriver_W/HO_W_OFF_D29: D29.1 (K), R111.1
/Katman2_GateDriver_W/LO_W: R15.1, R52.1, R112.2, R113.2, U3.1 (LO)
/Katman2_GateDriver_W/LO_W_OFF_D30: D30.1 (K), R112.1
/Katman2_GateDriver_W/LO_W_OFF_D31: D31.1 (K), R113.1
/Katman2_GateDriver_W/VB_W: C6.2, C7.2, D13.1 (K), U3.7 (VB)
GND: C50.1, C51.1, C157.2, C158.2, J22.3, R62.2, R63.1, U3.15 (VSS); also elsewhere on the board
G_WH1: D12.2 (A), J21.1, R14.2, R16.2; also elsewhere on the board
G_WH2: D29.2 (A), J21.3, R51.2, R53.2; also elsewhere on the board
G_WH_IN: J24.1, R62.1, U3.12 (HIN); also elsewhere on the board
G_WL1: D30.2 (A), J20.1, R15.2, R17.2; also elsewhere on the board
G_WL2: D31.2 (A), J20.3, R52.2, R54.2; also elsewhere on the board
G_WL_IN: J24.3, R63.2, U3.14 (LIN); also elsewhere on the board
Phase_W: C6.1, C7.1, J21.2, R16.1, R53.1, U3.6 (VS); also elsewhere on the board
SD: J24.2, U3.13 (SD); also elsewhere on the board
WSH: C155.2, C156.2, J20.2, R17.1, R54.1, U3.2 (COM); also elsewhere on the board
W_SNS_N: J25.2; also elsewhere on the board
W_SNS_P: J25.1; also elsewhere on the board

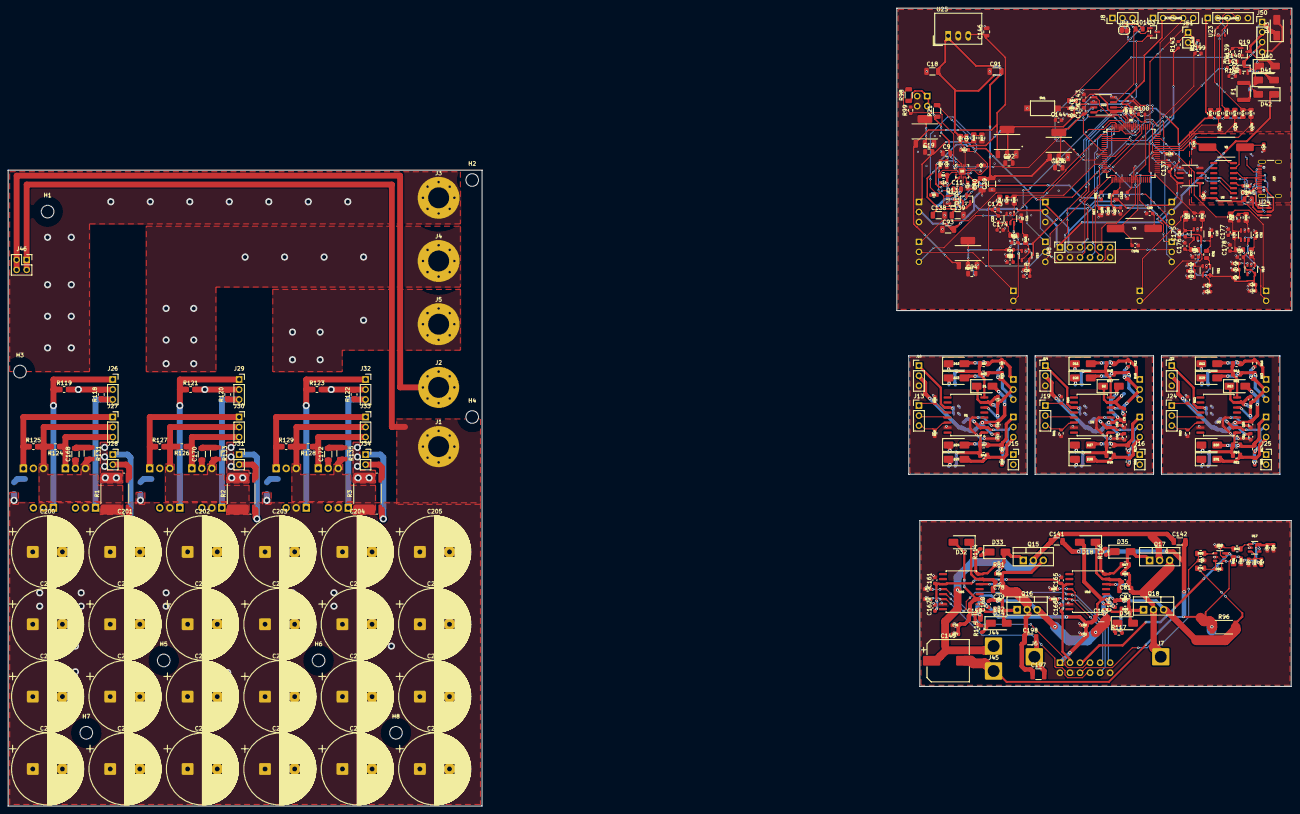
[picture p39: board bldc_driver_ai.kicad_pcb from above]

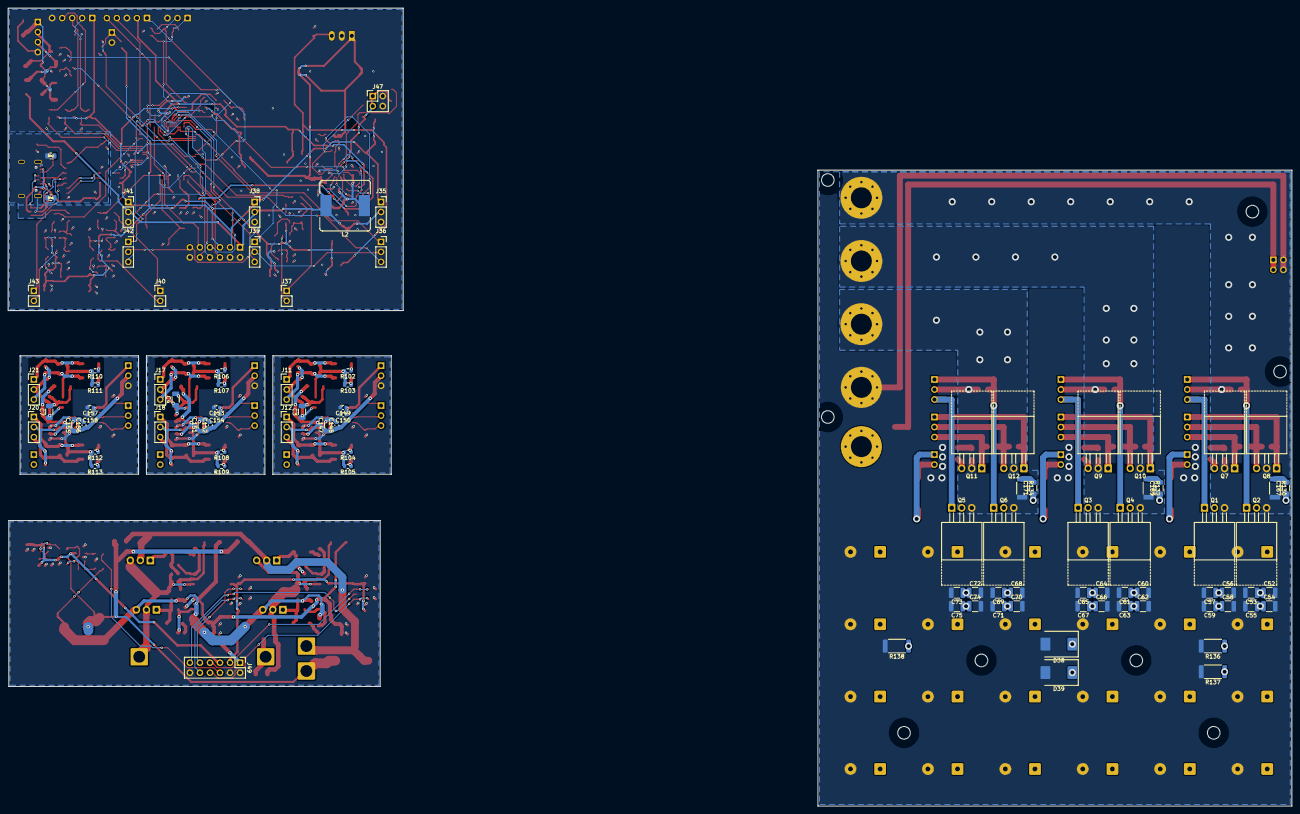
[picture p40: board bldc_driver_ai.kicad_pcb from below]

Board: 2 copper layers, 325.0 x 202.0 mm, 456 parts (94 on the bottom side), 175 nets.

Other parts of the board:
H1, H2, H3, H4, H5, H6, H7, H8: M3_Sogutucu; MountingHole_3.2mm_M3
