tekcanyilmaz42-gif/bldc_driver/uretim/guc_karti/guc_karti.kicad_pcb

## KiCad design uretim/guc_karti/guc_karti.kicad_pcb (2026-11-07)

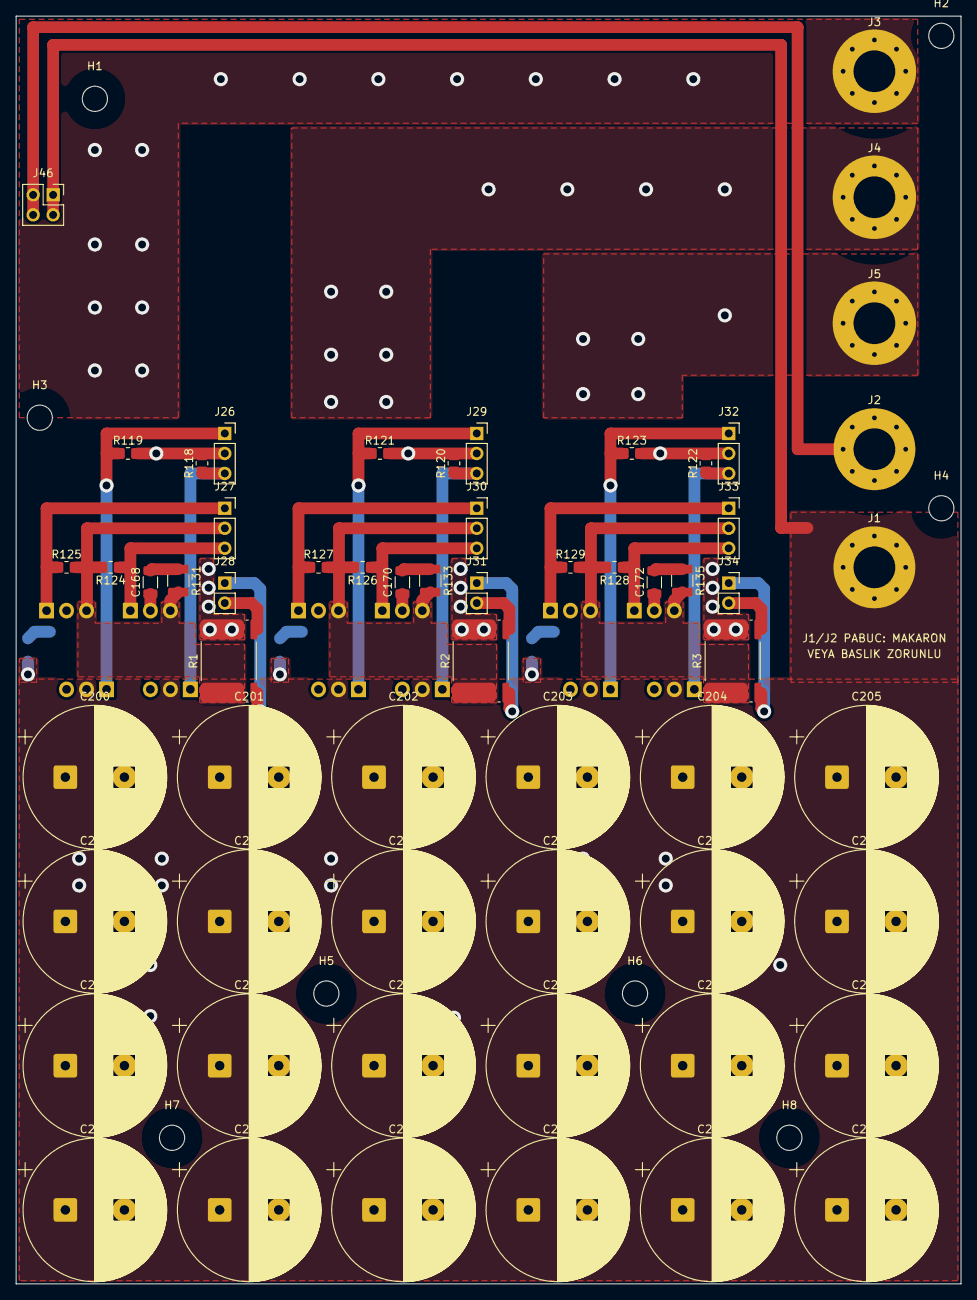
[picture p41: board guc_karti.kicad_pcb from above]

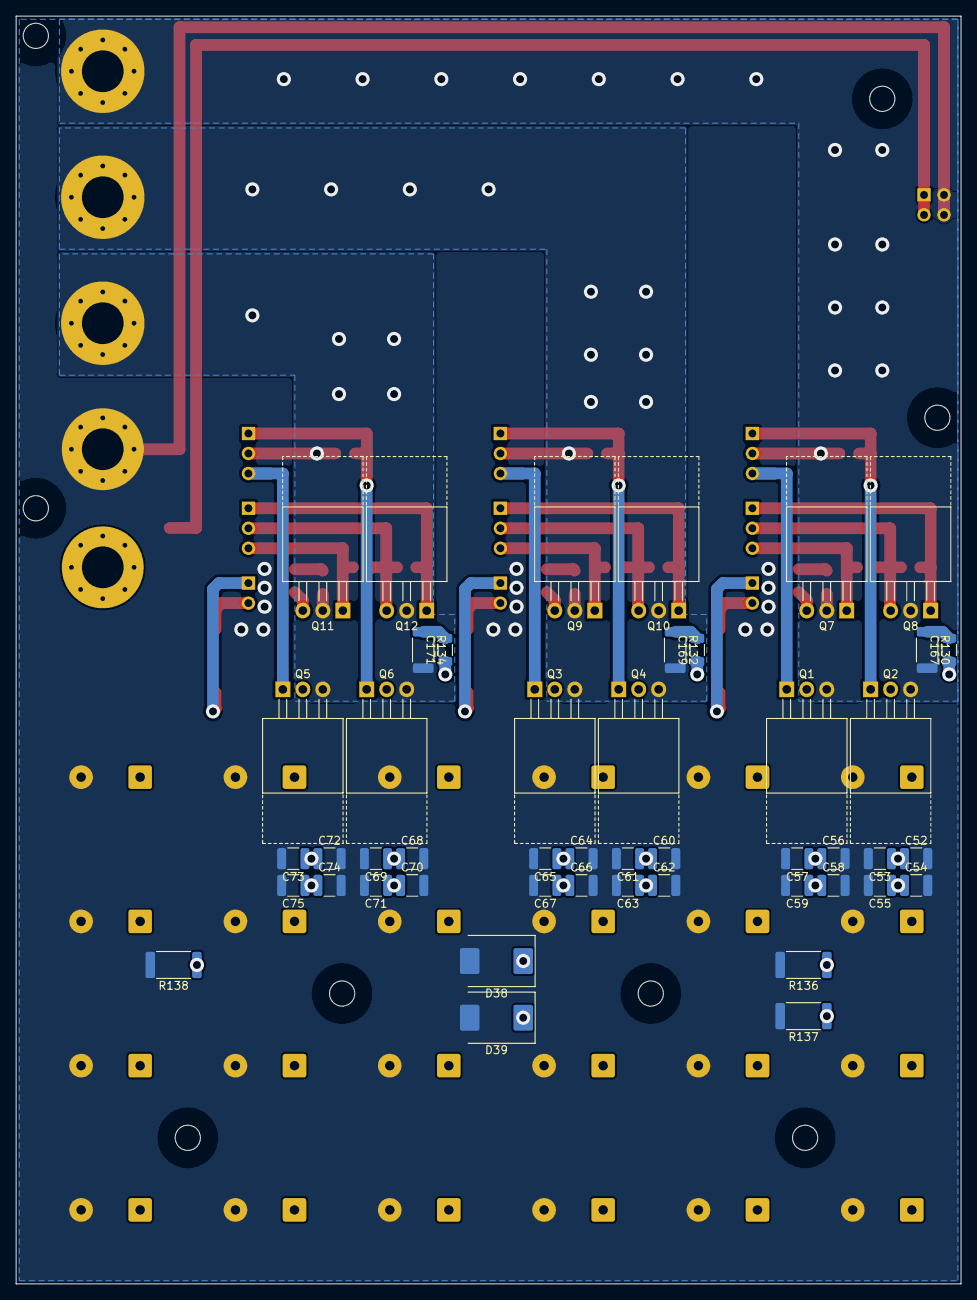
[picture p42: board guc_karti.kicad_pcb from below]

Board: 2 copper layers, 120.0 x 161.0 mm, 115 parts (47 on the bottom side), 32 nets.

Parts:
C52, C53, C54, C55, C56, C57, C58, C59, C60, C61, C62, C63, C64, C65, C66, C67, C68, C69, C70, C71, C72, C73, C74, C75: 4.7uF/100V; C_1210_3225Metric
C167, C168, C169, C170, C171, C172: 4.7nF/100V C0G; C_1206_3216Metric
C200, C201, C202, C203, C204, C205, C206, C207, C208, C209, C210, C211, C212, C213, C214, C215, C216, C217, C218, C219, C220, C221, C222, C223: 1000uF/100V; CP_Radial_D18.0mm_L40mm_P7.50mm_KOSHIN_KLH
D38, D39: 5.0SMDJ58CA; D_SMC
H1, H2, H3, H4, H5, H6, H7, H8: M3_Sogutucu; MountingHole_3.2mm_M3
J1: M5_Lug_VBAT; MountingHole_5.3mm_M5_Pad_Via
J2: M5_Lug_GND; MountingHole_5.3mm_M5_Pad_Via
J3: M5_Lug_U; MountingHole_5.3mm_M5_Pad_Via
J4: M5_Lug_V; MountingHole_5.3mm_M5_Pad_Via
J5: M5_Lug_W; MountingHole_5.3mm_M5_Pad_Via
J26: Gate_H_U; PinSocket_1x03_P2.54mm_Vertical
J27: Gate_L_U; PinSocket_1x03_P2.54mm_Vertical
J28: Sense_U; PinSocket_1x02_P2.54mm_Vertical
J29: Gate_H_V; PinSocket_1x03_P2.54mm_Vertical
J30: Gate_L_V; PinSocket_1x03_P2.54mm_Vertical
J31: Sense_V; PinSocket_1x02_P2.54mm_Vertical
J32: Gate_H_W; PinSocket_1x03_P2.54mm_Vertical
J33: Gate_L_W; PinSocket_1x03_P2.54mm_Vertical
J34: Sense_W; PinSocket_1x02_P2.54mm_Vertical
J46: Riser_VBAT_GND; PinSocket_2x02_P2.54mm_Vertical
Q1, Q2, Q3, Q4, Q5, Q6, Q7, Q8, Q9, Q10, Q11, Q12: IRFB4110PBF; TO-220-3_Horizontal_TabUp_NoHole
R1, R2, R3: 0.2mR 4-terminal; R_Shunt_Isabellenhuette_BVR4026
R118, R119, R120, R121, R122, R123, R124, R125, R126, R127, R128, R129: 10k; R_0805_2012Metric
R130, R132, R134: 2.2; R_2010_5025Metric
R131, R133, R135: 2.2; R_1210_3225Metric
R136, R137, R138: 10k 1W; R_2512_6332Metric

Connections:
/Katman1_Guc_Karti/SNB_UH: C167.2, R130.1
/Katman1_Guc_Karti/SNB_UL: C168.2, R131.1
/Katman1_Guc_Karti/SNB_VH: C169.2, R132.1
/Katman1_Guc_Karti/SNB_VL: C170.2, R133.1
/Katman1_Guc_Karti/SNB_WH: C171.2, R134.1
/Katman1_Guc_Karti/SNB_WL: C172.2, R135.1
GND: C52.2, C53.2, C54.2, C55.2, C56.2, C57.2, C58.2, C59.2, C60.2, C61.2, C62.2, C63.2, C64.2, C65.2, C66.2, C67.2, C68.2, C69.2, C70.2, C71.2, C72.2, C73.2, C74.2, C75.2, C200.2, C201.2, C202.2, C203.2, C204.2, C205.2, C206.2, C207.2, C208.2, C209.2, C210.2, C211.2, C212.2, C213.2, C214.2, C215.2, C216.2, C217.2, C218.2, C219.2, C220.2, C221.2, C222.2, C223.2, D38.2 (A2), D39.2 (A2), J2.1 (Pin_1_1), J46.2, J46.4, R1.4, R2.4, R3.4, R136.2, R137.2, R138.2
G_UH1: J26.1, Q2.1, R119.1
G_UH2: J26.3, Q1.1, R118.1
G_UL1: J27.1, Q8.1, R125.1
G_UL2: J27.3, Q7.1, R124.1
G_VH1: J29.1, Q4.1, R121.1
G_VH2: J29.3, Q3.1, R120.1
G_VL1: J30.1, Q10.1, R127.1
G_VL2: J30.3, Q9.1, R126.1
G_WH1: J32.1, Q6.1, R123.1
G_WH2: J32.3, Q5.1, R122.1
G_WL1: J33.1, Q12.1, R129.1
G_WL2: J33.3, Q11.1, R128.1
Phase_U: C168.1, J3.1 (Pin_1_1), J26.2, Q1.3, Q2.3, Q7.2, Q8.2, R118.2, R119.2, R130.2
Phase_V: C170.1, J4.1 (Pin_1_1), J29.2, Q3.3, Q4.3, Q9.2, Q10.2, R120.2, R121.2, R132.2
Phase_W: C172.1, J5.1 (Pin_1_1), J32.2, Q5.3, Q6.3, Q11.2, Q12.2, R122.2, R123.2, R134.2
USH: J27.2, Q7.3, Q8.3, R1.1, R124.2, R125.2, R131.2
U_SNS_N: J28.2, R1.3
U_SNS_P: J28.1, R1.2
VBAT: C52.1, C53.1, C54.1, C55.1, C56.1, C57.1, C58.1, C59.1, C60.1, C61.1, C62.1, C63.1, C64.1, C65.1, C66.1, C67.1, C68.1, C69.1, C70.1, C71.1, C72.1, C73.1, C74.1, C75.1, C167.1, C169.1, C171.1, C200.1, C201.1, C202.1, C203.1, C204.1, C205.1, C206.1, C207.1, C208.1, C209.1, C210.1, C211.1, C212.1, C213.1, C214.1, C215.1, C216.1, C217.1, C218.1, C219.1, C220.1, C221.1, C222.1, C223.1, D38.1 (A1), D39.1 (A1), J1.1 (Pin_1_1), J46.1, J46.3, Q1.2, Q2.2, Q3.2, Q4.2, Q5.2, Q6.2, R136.1, R137.1, R138.1
VSH: J30.2, Q9.3, Q10.3, R2.1, R126.2, R127.2, R133.2
V_SNS_N: J31.2, R2.3
V_SNS_P: J31.1, R2.2
WSH: J33.2, Q11.3, Q12.3, R3.1, R128.2, R129.2, R135.2
W_SNS_N: J34.2, R3.3
W_SNS_P: J34.1, R3.2
