tekcanyilmaz42-gif/bldc_driver/uretim/gate_driver_u/gate_driver_u.kicad_pcb

## KiCad design uretim/gate_driver_u/gate_driver_u.kicad_pcb (2026-11-06)

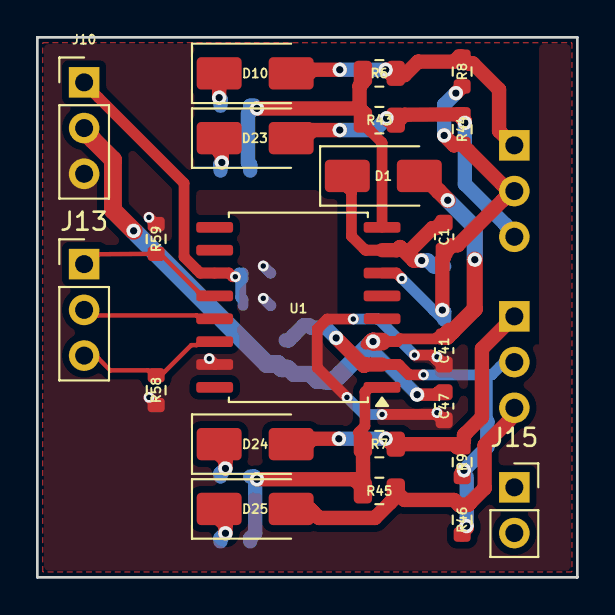
[picture p43: board gate_driver_u.kicad_pcb from above]

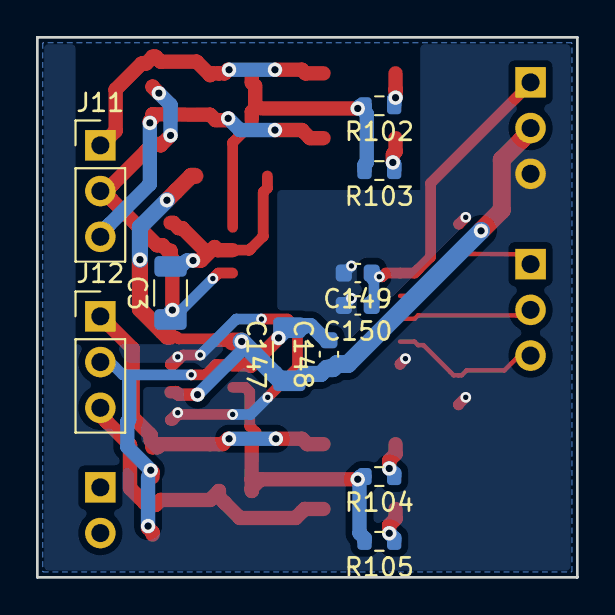
[picture p44: board gate_driver_u.kicad_pcb from below]

Board: 2 copper layers, 30.0 x 30.0 mm, 33 parts (11 on the bottom side), 19 nets.

Parts:
C1, C148, C149: 100nF; C_0603_1608Metric
C3: 2.2uF/25V; C_1206_3216Metric
C41, C47, C150: 1uF; C_0603_1608Metric
C147: 22uF/25V; C_1206_3216Metric
D1: US1D; D_SMA
D10, D23, D24, D25: SS18; D_SMA
J10: Pwr_U; PinHeader_1x03_P2.54mm_Vertical
J11: Gate_H_U; PinHeader_1x03_P2.54mm_Vertical
J12: Gate_L_U; PinHeader_1x03_P2.54mm_Vertical
J13: Ctrl_U; PinHeader_1x03_P2.54mm_Vertical
J15: Sense_U_stack; PinSocket_1x02_P2.54mm_Vertical
R6, R7, R43, R45: 10; R_0805_2012Metric
R8, R9, R44, R46, R58, R59: 10k; R_0603_1608Metric
R102, R103, R104, R105: 2.2; R_0603_1608Metric
U1: IR2110S; SOIC-16W_7.5x10.3mm_P1.27mm

Connections:
3V3_IO: C149.1, C150.1, J10.1, U1.11 (VDD)
12V: C41.2, C47.2, C147.1, C148.1, D1.2 (A), J10.2, U1.3 (VCC)
/Katman2_GateDriver_U/HO_U: R6.1, R43.1, R102.2, R103.2, U1.8 (HO)
/Katman2_GateDriver_U/HO_U_OFF_D10: D10.1 (K), R102.1
/Katman2_GateDriver_U/HO_U_OFF_D23: D23.1 (K), R103.1
/Katman2_GateDriver_U/LO_U: R7.1, R45.1, R104.2, R105.2, U1.1 (LO)
/Katman2_GateDriver_U/LO_U_OFF_D24: D24.1 (K), R104.1
/Katman2_GateDriver_U/LO_U_OFF_D25: D25.1 (K), R105.1
/Katman2_GateDriver_U/VB_U: C1.2, C3.2, D1.1 (K), U1.7 (VB)
GND: C41.1, C47.1, C149.2, C150.2, J10.3, R58.1, R59.2, U1.15 (VSS)
G_UH1: D10.2 (A), J11.1, R6.2, R8.2
G_UH2: D23.2 (A), J11.3, R43.2, R44.2
G_UH_IN: J13.1, R59.1, U1.12 (HIN)
G_UL1: D24.2 (A), J12.1, R7.2, R9.2
G_UL2: D25.2 (A), J12.3, R45.2, R46.2
G_UL_IN: J13.3, R58.2, U1.14 (LIN)
Phase_U: C1.1, C3.1, J11.2, R8.1, R44.1, U1.6 (VS)
SD: J13.2, U1.13 (SD)
USH: C147.2, C148.2, J12.2, R9.1, R46.1, U1.2 (COM)
