tekcanyilmaz42-gif/bldc_driver/uretim/gate_driver_v/gate_driver_v.kicad_pcb

## KiCad design uretim/gate_driver_v/gate_driver_v.kicad_pcb (2026-11-06)

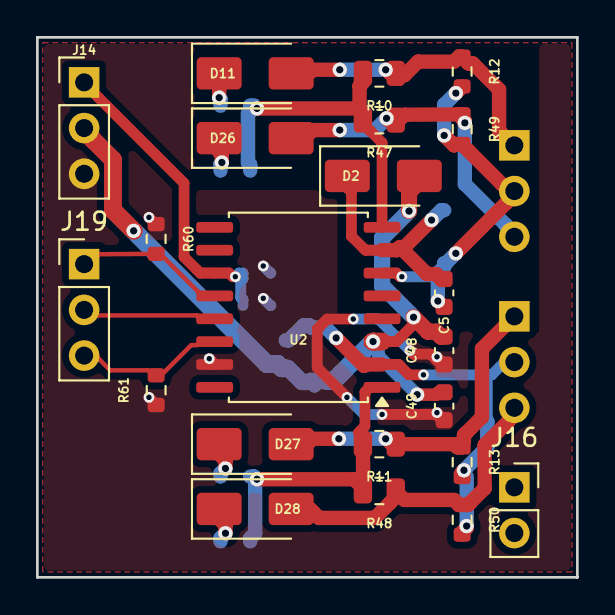
[picture p47: board gate_driver_v.kicad_pcb from above]

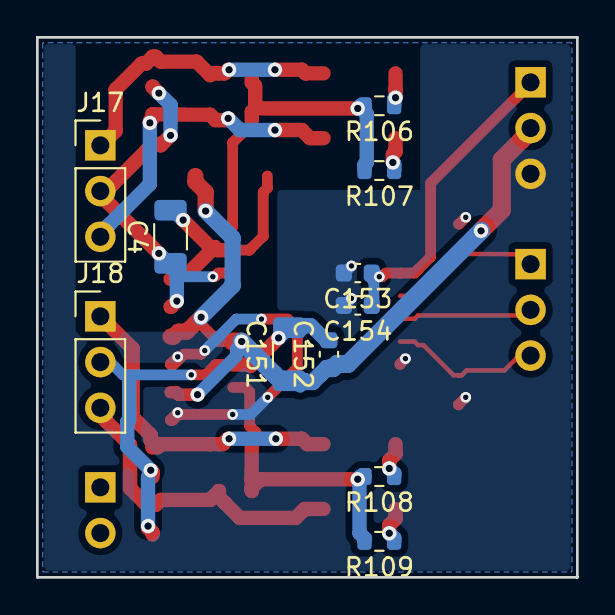
[picture p48: board gate_driver_v.kicad_pcb from below]

Board: 2 copper layers, 30.0 x 30.0 mm, 33 parts (11 on the bottom side), 19 nets.

Parts:
C4: 2.2uF/25V; C_1206_3216Metric
C5, C152, C153: 100nF; C_0603_1608Metric
C48, C49, C154: 1uF; C_0603_1608Metric
C151: 22uF/25V; C_1206_3216Metric
D2: US1D; D_SMA
D11, D26, D27, D28: SS18; D_SMA
J14: Pwr_V; PinHeader_1x03_P2.54mm_Vertical
J16: Sense_V_stack; PinSocket_1x02_P2.54mm_Vertical
J17: Gate_H_V; PinHeader_1x03_P2.54mm_Vertical
J18: Gate_L_V; PinHeader_1x03_P2.54mm_Vertical
J19: Ctrl_V; PinHeader_1x03_P2.54mm_Vertical
R10, R11, R47, R48: 10; R_0805_2012Metric
R12, R13, R49, R50, R60, R61: 10k; R_0603_1608Metric
R106, R107, R108, R109: 2.2; R_0603_1608Metric
U2: IR2110S; SOIC-16W_7.5x10.3mm_P1.27mm

Connections:
3V3_IO: C153.1, C154.1, J14.1, U2.11 (VDD)
12V: C48.2, C49.2, C151.1, C152.1, D2.2 (A), J14.2, U2.3 (VCC)
/Katman2_GateDriver_V/HO_V: R10.1, R47.1, R106.2, R107.2, U2.8 (HO)
/Katman2_GateDriver_V/HO_V_OFF_D11: D11.1 (K), R106.1
/Katman2_GateDriver_V/HO_V_OFF_D26: D26.1 (K), R107.1
/Katman2_GateDriver_V/LO_V: R11.1, R48.1, R108.2, R109.2, U2.1 (LO)
/Katman2_GateDriver_V/LO_V_OFF_D27: D27.1 (K), R108.1
/Katman2_GateDriver_V/LO_V_OFF_D28: D28.1 (K), R109.1
/Katman2_GateDriver_V/VB_V: C4.2, C5.2, D2.1 (K), U2.7 (VB)
GND: C48.1, C49.1, C153.2, C154.2, J14.3, R60.2, R61.1, U2.15 (VSS)
G_VH1: D11.2 (A), J17.1, R10.2, R12.2
G_VH2: D26.2 (A), J17.3, R47.2, R49.2
G_VH_IN: J19.1, R60.1, U2.12 (HIN)
G_VL1: D27.2 (A), J18.1, R11.2, R13.2
G_VL2: D28.2 (A), J18.3, R48.2, R50.2
G_VL_IN: J19.3, R61.2, U2.14 (LIN)
Phase_V: C4.1, C5.1, J17.2, R12.1, R49.1, U2.6 (VS)
SD: J19.2, U2.13 (SD)
VSH: C151.2, C152.2, J18.2, R13.1, R50.1, U2.2 (COM)
