tekcanyilmaz42-gif/bldc_driver/(commit log)

2026-10-15 Initial commit: bldc_driver files
    [bldc_driver.kicad_pcb, bldc_driver.kicad_sch, kapasitor_power.kicad_sch, untitled.kicad_sch]
2026-11-04 Update project to bldc_driver_ai (KiCad 10 Rev 3.0)
    [bldc_driver.kicad_pcb, bldc_driver.kicad_sch, bldc_driver_ai.kicad_pcb, bldc_driver_ai.kicad_sch, bldc_driver_ai_3d_montaj.kicad_pcb, bldc_driver_ai_BOM.xlsx, bldc_driver_ai_faz7_D42.kicad_pcb, bldc_driver_ai_faz7_kural_oncesi.kicad_pcb]
2026-11-05 Revize tasarim: DC-link film kapasitor banki, ozel footprintler ve guncel uretim ciktilari
    [bldc_driver_ai.kicad_pcb, bldc_driver_ai_3d_montaj.kicad_pcb, bldc_driver_ai_BOM.xlsx, bldc_driver_ai_film_bank.kicad_pcb, bldc_driver_ai_film_kucuk.kicad_pcb, bldc_driver_ai_film_oncesi.kicad_pcb, bldc_driver_ai_inceleme_oncesi.kicad_pcb, bldc_driver_ai_inceleme_sonrasi.kicad_pcb]
2026-11-06 Revize tasarim: KOSHIN KLH 24 mF DC-link bara kondansator grubu, guncel uretim ve 3D montaj ciktilari
    [bldc_driver_ai.kicad_pcb, bldc_driver_ai_3d_montaj.kicad_pcb, bldc_driver_ai_BOM.xlsx, bldc_driver_ai_faz7_D42.kicad_pcb, bldc_driver_ai_faz7_kural_oncesi.kicad_pcb, bldc_driver_ai_film_bank.kicad_pcb, bldc_driver_ai_film_kucuk.kicad_pcb, bldc_driver_ai_film_oncesi.kicad_pcb]
2026-11-06 Revize tasarim: Guc karti 120x161 mm kompakt yerlesim (kondansatorler MOSFET uzerinde), moduler uretim projeleri ve guncel ciktilar
    [bldc_driver_ai.kicad_pcb, bldc_driver_ai_205x93_birlesik.kicad_pcb, bldc_driver_ai_3d_montaj.kicad_pcb, bldc_driver_ai_BOM.xlsx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]
2026-11-07 Tasarim incelemesi 3 duzeltmeleri: D43 TVS revizyonu, motor sicaklik girisi (J52), enkoder giris direncleri, 8.5 mm standoff ve guncel ciktilar
    [bldc_driver_ai.kicad_pcb, bldc_driver_ai.kicad_sch, bldc_driver_ai_3d_montaj.kicad_pcb, bldc_driver_ai_BOM.xlsx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]
